aviljoenn/inno-pilot/test_after_opensettings.png

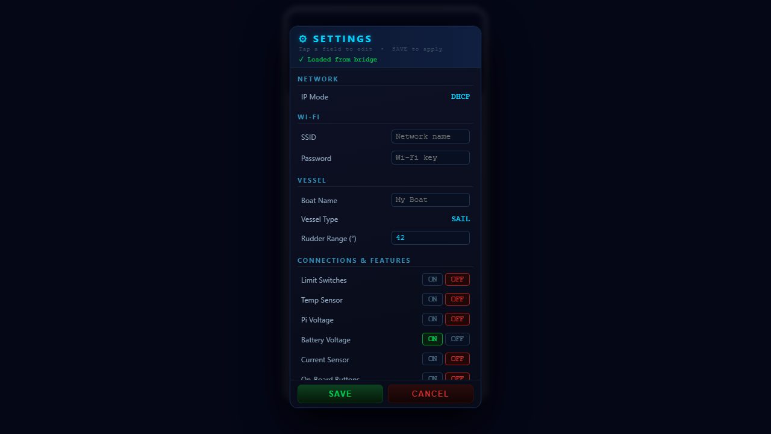
test_after_opensettings.png
