aviljoenn/inno-pilot/test_before_gear.png

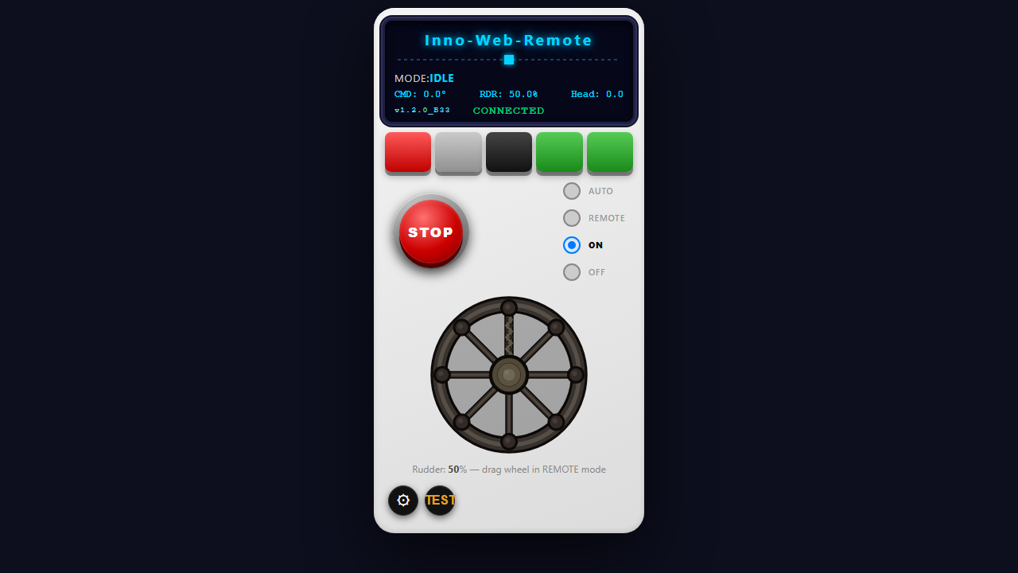
test_before_gear.png
