aviljoenn/inno-pilot/CHANGELOG.md

# Changelog

All notable changes to the Inno-Pilot system are documented here.
Format follows [Keep a Changelog](https://keepachangelog.com/).
Version applies to all three components (Bridge, Nano, Remote) simultaneously and the version of all components must always match regardless if a change was made in a component or not.
Versioning is `vHARDWARE.FEATURE.FIX` (MAJOR = hardware change, MINOR = software feature change,
PATCH = patch / bug fix), bumped on every merge of code to master. Components whose development is
paused (currently the ESP32 remote + its OTA binary) are deliberately left on their old version.
Full rule: CLAUDE.md "Version sync".

## [Unreleased]

## [v3.3.2] — 2026-10-21

Patch release. Bumped across all actively developed components (Nano, bridge, web remote).
The paused ESP32 remote firmware (v1.3.3_B3) and its OTA binary are deliberately not bumped.
Diagnosed on Inno-Pilot-Rosa from a REMOTE hand-steering session that stopped by itself, plus an
attended dock test with a packet capture (Samsung S20, Chrome).

### Fixed
- **REMOTE stopped (STEER LOSS) while the skipper was steering.** With a finger held on the helm
  wheel for several seconds, Chrome on a Samsung S20 paused the web page's timers (~1.5 s) and then
  reported the page hidden although it stayed on screen, so the page's heartbeat stopped and the
  bridge's 1.5 s dead-man ended REMOTE. Wi-Fi and the Pi were fine (pings answered within 70 ms,
  every request served in 2–20 ms). Touches on the wheel now send a heartbeat too (`ALIVE T`),
  also while the browser claims the page is hidden — a finger on the wheel is a skipper. The
  dead-man itself is unchanged: no heartbeat and no touches for 1.5 s still means STEER LOSS
  (screen locked, phone gone).
- **Motor chatter in REMOTE.** 144 of 189 REMOTE motor starts lasted only 1–2 ms: the Nano started
  and stopped on the same deadband edge, and each start's inrush pulled the motor supply down (once
  to 6.3 V). The Nano now starts only beyond 1.5 × the deadband (stops at the deadband), runs at
  least 60 ms once started, rests at least 150 ms after any stop, and never reverses a running pump
  directly. Limits, rudder ends and STOP still stop at once. The bridge's REMOTE stall check uses the
  same start threshold, so the deliberate hold between 1 and 1.5 deadbands is not counted as a stall.
- **Debug log motor direction was backwards** (`[PORT]` while the rudder moved to starboard). The
  bridge now labels RPWM = port, LPWM = starboard as the firmware drives them (honours `invert_motor`).

### Added
- **Diagnostics that survive.** The journal is kept across reboots (64 MB cap; Raspberry Pi OS keeps
  it in RAM by default). The bridge logs a late REMOTE heartbeat (> 1.0 s) as a warning, naming
  whether it came from the timer or a touch. The page reports hidden/visible, frozen/resumed, focus
  changes and late timers to the journal (`PAGE_EVENT`), so the next unexplained stop names its cause.

## [v3.3.1] — 2026-10-15

Patch release. Bumped across all actively developed components (Nano, bridge, web remote);
only the vendored pypilot fork changed. The paused ESP32 remote firmware (v1.3.3_B3) and its
OTA binary are deliberately not bumped.

### Fixed
- **Autopilot dead after any pypilot restart or hang (EBUSY on `/dev/ttyINNOPILOT`).**
  pypilot's servo set the exclusive flag (TIOCEXCL) on its port and cleared it only on a tidy
  close; when pypilot was stopped or restarted (by hand, or by systemd after pypilot exits —
  pypilot exits on any signal, including a hang being resumed) the flag stayed on the socat
  PTY and every reopen failed with EBUSY, so an engaged AP
  sent no commands until pypilot, the bridge and socat were restarted together. Found and
  confirmed on Inno-Pilot-Rosa (flag read back as set). Deliberate pypilot-fork strips:
  - `servo.py`: no TIOCEXCL on the servo port.
  - `nmea.py`: serial NMEA probing disabled — the flag only existed to keep that probe off
    the servo port, and Inno-Pilot has no serial NMEA devices (GPS/wind come over TCP/UDP).
    TCP/UDP NMEA inputs are unchanged.
- **False "rudder at centre" after a pypilot restart.** pypilot reports an invalid rudder
  reading as `False`; the bridge converted it with `float()`, giving 0.0°, so the web rudder bar
  and helm jumped to centre for ~0.5 s on every pypilot restart (a 29° "swing" on
  Inno-Pilot-Rosa with the rudder at port). Invalid pypilot values now mean "unknown": the
  page keeps the last angle, and a jog is refused or stopped while the angle is unknown (its
  soft limit cannot be checked). Applies to a dead rudder sensor as well.

## [v3.3.0] — 2026-10-15

Minor (feature) release. Bumped across all actively developed components (Nano, bridge,
web remote). The paused ESP32 remote firmware (v1.3.3_B3) and its OTA binary are
deliberately not bumped.

### Safety: no rudder motion before rudder limits are set
- **The bridge refuses every rudder motion until the rudder limits have been set by hand**:
  engaging AP (web remote, Nano B3 **and** pypilot's own port 8000 page — its COMMAND frames
  are dropped before the Nano and `ap.enabled=False` is sent back), REMOTE steering, jog and
  the rudder sweep. Alert `RUDDER LIMITS: NOT SET` in the web page alert panel
  (telemetry `WARN LIMITS_UNSET` when something was refused or stopped).
- **Limits are tied to the calibration they were set against.** Any later change to pypilot's
  rudder calibration (reset or capture on port 8000, a rudder range edit, the Nano EEPROM
  copy differing beyond its rounding) makes them invalid, and anything moving the rudder is
  stopped through its normal exit path. A pypilot outage keeps the last calibration, so
  REMOTE steering still works when pypilot dies.
- **Dock-Side Wizard, step 1 — rudder sensor & limits by hand** (Settings → Setup Wizards →
  Dock-Side → OPEN). Clutch out, the skipper turns the wheel/tiller: rudder angle at the stops
  → capture centre, port stop and starboard stop (each sampled for 1 s and rejected if the
  rudder moved > 0.5°; handed to pypilot's own 3-point calibration) → soft limits in degrees,
  at least 1° inside each stop (default 3°). The bridge checks the resulting calibration
  (stops inside the sensor span, span not tiny, curve monotonic) before accepting.
  New bridge commands `LIMITS RANGE|CAPTURE|SET`, status telemetry `LIMITS <json>`.
- Limits live in a bridge-owned file `/var/lib/inno-pilot/rudder_limits.json` (atomic
  write), deliberately outside `settings.json` so `SETTINGS SET` cannot mark them set.
- Jog and sweep now use these degree limits. The old **Port/Stbd Limit (%)** settings are
  greyed out as "REPLACED: DOCK-SIDE WIZARD" (still written to the Nano EEPROM block).
- **Existing installations must run the Dock-Side Wizard step once after updating** —
  there is no carry-over of the old percentage limits (agreed: Inno-Pilot-Rosa is
  re-commissioned).
- Not yet: the soft limits are not enforced while AP or REMOTE steer (TODO.md HIGH item);
  "limits set" is a precondition for motion, not yet a bound in every mode.

### Fixed after the Inno-Pilot-Rosa bench test (2026-10-15)
- **Web STOP silences the Nano's alarms** (new `WARNING_CODE` value 3), like the Nano's STOP
  button — units without helm buttons could not stop a STEER LOSS buzzer. Web STOP also
  ends a running jog.
- **Bridge now detects pypilot dying.** pypilot's client never raises on disconnect, so the
  immediate "pypilot connection lost" stop never fired on hardware (the Nano's 1.5 s
  watchdog caught it instead). The connection state now comes from the client.
- **Jog stops before the soft limit, not after**: it allows for its speed × 0.25 s (one
  pypilot angle step + coast; tuned on Inno-Pilot-Rosa, where the coast is only 0.6–0.9°). Measured overshoot before: up to 2.2° at detection, 0.8° short of the
  stop. The log reports where the rudder settled, for tuning.
- **No stale rudder angle to the Nano**: when pypilot hangs, the bridge stops relaying its
  frozen angle, and the Nano's cross-check only trusts a relayed angle under 0.6 s old —
  a hang no longer latches the Nano off its local angle.

### Safety (stop latch, dead-men, failsafe)
- **Nano STOP is now one press, always a full stop, and latched** (`motor_simple.ino`). It
  used to be two-press while an alarm sounded (first press only silenced and left the AP
  engaged), and a stop could be undone within ~200 ms by pypilot's next COMMAND frame. The
  Nano now ignores COMMAND frames and re-sends STOP until pypilot has visibly disengaged.
- **Nano AP command watchdog**: engaged but no pypilot COMMAND for 1.5 s (pypilot crashed or
  hung) → disengage, `!STEER LOSS` alarm, new button event 7 (AP_LOST) to the bridge.
- **REMOTE steering dead-man**: the web page sends `ALIVE` every 0.4 s; 1.5 s of silence (phone
  dropped, screen locked, Wi-Fi gone) stops REMOTE steering with STEER LOSS. Before, REMOTE
  steering continued indefinitely while the server stayed connected. Armed at entry
  (`MODE MANUAL ALIVE`), sent only by the phone that selected REMOTE. Opt-in per session, so
  the paused ESP32 remote is unaffected.
- **NUDGE dead-man**: `NUDGE HOLD` every 0.2 s while held; 0.8 s of silence stops the jog
  (was: up to 10 s). A held button can no longer restart a jog the bridge has stopped.
- **pypilot loss while engaged** (bridge): immediate DISENGAGE + alert when the pypilot
  connection drops, or when AP is shown but pypilot has sent no COMMAND for 3 s (also catches
  a re-engage while pypilot is hung); and no surprise re-engage — pypilot COMMAND frames are held back until pypilot disengages or the skipper
  re-engages.
- Skipper alerts `REMOTE STEER: STOPPED` / `AUTOPILOT: STOPPED` in the web page alert panel
  (telemetry `WARN <code>`); the mode selector follows the bridge when it leaves REMOTE.

## [v3.2.0] — 2026-10-15

Minor (feature) release. Bumped across all actively developed components (Nano, bridge,
web remote); the Nano and bridge have no code change. The paused ESP32 remote firmware
(v1.3.3_B3) and its OTA binary are deliberately not bumped. First release for
Inno-Pilot-Rosa (the unit formerly called Dyason).

### Changed
- Web remote Settings split into **SETUP WIZARDS** (Startup, Dock-Side, Sea Trial —
  placeholders, "COMING SOON") and **ADVANCED SETTINGS** (all existing settings,
  collapsed by default). Saving is unchanged.
- 14 settings that are stored but not acted on by the Pi or the Nano are greyed out,
  locked and labelled "(NOT USED)": network block, Wi-Fi SSID/key, vessel type, P-Gain,
  off-course alarm, auto-disengage, comms WARN/CRIT. See the dead settings register
  in TODO.md.

## [v3.1.0] — 2026-10-13

Minor (feature) release. Bumped across all actively developed components (Nano, bridge,
web remote). The paused ESP32 remote firmware (v1.3.3_B3) and its OTA binary are
deliberately not bumped.

### Added
- Attended rudder sweep with measurements (Hardware Test 1); Hardware tests 2-9 greyed out
  (PR #85, first shipped on Inno-Pilot-Rosa as v3.0.3 from the PR branch).

### Fixed
- Latent `NameError` in vendored pypilot `gps_filter.py` (missing `import datetime`, PR #80).

## [v3.0.3] — 2026-10-01

Patch release. Bumped across all actively developed components (Nano, bridge, web
remote). The paused
ESP32 remote firmware (v1.3.3_B3) and its OTA binary are deliberately not bumped.

### Fixed
- **REMOTE helm: "play" between the finger and the rudder** (found on Inno-Pilot-Rosa after the
  deadband tuning; four stacked causes, fixed together):
  - **A — final finger position dropped** (`inno_web_remote.py`): RUD was rate-limited
    to 5 Hz and anything inside the 200 ms window was discarded, with nothing sent on
    release, so the rudder went to where the finger was up to 200 ms before it
    stopped. Now a trailing send delivers the latest value as soon as the window
    allows, and the final value is sent on finger lift.
  - **B — Nano steered on a ~0.3 s-stale angle** (`motor_simple.ino`,
    `inno_pilot_bridge.py`; hardware impact — position control). The remote-manual
    loop used pypilot's angle, computed from the Nano's own ADC but sent out at 5 Hz,
    converted ~220 ms later and relayed back at 5 Hz (~2° late at 6°/s). The bridge
    now watches pypilot's rudder calibration (scale, offset, nonlinearity, range) and
    sends it to the Nano as a quadratic (new frames 0xC0–0xC6, status 0xC8); the Nano
    evaluates it on its fresh ADC every loop. pypilot stays the calibration truth.
    Safety: cross-check against pypilot's angle (> 5° for > 1 s → rejected, falls
    back to the old behaviour, latched until the calibration changes); end-stop
    backstop checks both angles; AP steering unchanged. Host unit test: Nano maths
    matches pypilot's formula within 0.05° over 300 random calibrations × 1024 ADC
    values. **Changes the right deadband:** with fresh feedback the Nano stops at the
    deadband edge (4% → ~2° short), and overshoot shrinks to the coast, so a smaller
    deadband (~1.5%) now settles without correction moves (simulator: 1.5% → end
    error −0.5°, overshoot 0; old firmware at 1.5% overshot 1.3° and corrected).
  - **C — offset starting target on entering REMOTE** (`motor_simple.ino`): the Nano
    seeded its target from the raw ADC scaled to 1..1022 but interprets targets on the
    calibrated axis, so the first wheel move jumped. It now re-seeds from the
    calibrated angle (unless the bridge sends a target first). Bridge side: the stall
    check's fixed 500 placeholder target is replaced by the actual rudder position, which
    removes the false "RUDDER: NOT MOVING" alert when REMOTE is entered off-centre.
  - **D — wheel gearing now a setting** (`inno_web_remote.py`): "Helm Wheel Turn (±°)"
    (Settings, shown with Remote Helm ON), default ±90° (was fixed ±150°) — 3° of wheel
    per rudder degree on a ±30° rudder instead of 5°. Changing it re-draws the wheel at
    the same rudder position. Also: ON/OFF settings now show/hide their dependent rows,
    and fields can carry a default for settings saved before they existed.
  - Nano flash 96% (29508 / 30720) after B — little headroom left.
- **Nano: REMOTE steering and the rudder sweep could not start the motor near the
  target** (`motor_simple.ino`; hardware impact — motor drive). Within 4 × deadband of
  the target (24° on Inno-Pilot-Rosa) remote-manual mode wrote `analogWrite(D9, 160)`, but the
  pin-state telemetry called `digitalRead(D9)` every loop, and on AVR `digitalRead()`
  turns PWM off on that pin — the duty never reached the motor. Found when Inno-Pilot-Rosa's
  second sweep stopped "stuck" without moving at all. Fix: all EN writes go through
  `motor_pwm()`, which records the duty, and the telemetry reports EN from that value
  (no `digitalRead(D9)`); and the slow zone now drives at full duty (255), matching the
  AP path — the hydraulic pump is on/off and the firmware's own note requires ≥ 180 for
  any PWM. Stopping is left to the existing reverse brake pulse + deadband, so overshoot
  near the target may rise slightly; the sweep measures it.
- **Hardware tests 2–9 could never run, and pressing RUN broke the bridge's text
  relay** (`inno_web_remote.py`, `inno_pilot_bridge.py`). They send `TEST <id>` to
  the Nano, but no sketch implements that protocol (`motor_simple` ignores it;
  `pwm_test.ino` picks its mode with compile-time `#define`s and never sends
  `TEST_DONE`). The bridge set `test_mode` and never cleared it, so every telemetry
  byte went through the text relay and any `0x0A` inside a frame reached the
  remotes as a junk `TEST_LINE` until restart. Tests 2–9 are now greyed out
  ("BENCH FIRMWARE / NOT AVAILABLE") and the bridge refuses `TEST` behind
  `NANO_TEST_PROTOCOL_SUPPORTED = False`. Also fixed: duplicate ID 2 (Speed Sweep
  is 3), and the test list staying visible behind the detail/config screens.
- **RAM test: the Nano's physical STOP did not stop it** (safety). STOP set the
  bridge mode to IDLE but left `ram_test_running` set; the sweep loop re-asserted
  MANUAL within 200 ms and carried on. The Nano's B3 could also engage AP mid-sweep.
- **RAM test kept sweeping with nobody watching**: a remote disconnect only
  handled MANUAL mode; stall detection flagged but did not stop it; `MODE`/`RUD`/
  `NUDGE` from any client left it running.

### Changed
- **RAM test → "Rudder Sweep (commissioning)", attended only, with measurements.**
  - **Dead-man hold:** after arming, the operator must HOLD B3 for the whole run.
    The browser sends `RAM HOLD` every 200 ms; the bridge stops after 1 s without
    one, so lifting the finger, dropping/locking the phone, switching apps,
    closing the page or losing WiFi all stop it. Release ends the test (no resume;
    re-arm from Settings). Arming never held disarms after 60 s.
  - **One exit path** (`ram_test_abort()`): hold lost/released, any Nano button,
    any remote STOP/BTN/MODE/RUD/NUDGE/TGT, stall, rudder angle unavailable,
    stroke timeout, remote disconnect, cycles complete. A stop never auto-centres
    (that would be unattended motion); MANUAL is released where the rudder stands.
  - **Measures** per direction: rudder speed (°/s, central 60% of the stroke),
    estimated hard-over time, reversal lag, overshoot, settled end error, settle
    timeouts, motor current (if `current_sensor` is on), port/stbd speed
    difference. Results show on the remote and go to the journal. PASS / CHECK /
    STOPPED. Reported only — nothing is written to settings.
  - Amplitude 5°–range (also clamped to `rudder_limit_*_pct`), 1–10 cycles
    (default 3). Bridge now watches `servo.current` from pypilot.
  - **Deadband-aware** (found on Inno-Pilot-Rosa's first boat run, which false-stopped with
    "rudder not moving" while the rudder moved fine): the Nano stops anywhere within
    its deadband (`deadband_pct` × full span — ±6° on Inno-Pilot-Rosa at 10%). The sweep now
    treats arriving inside that band as the end of the stroke, uses its own
    speed-independent jam check (< 0.5° progress in 2 s) instead of the generic 2°/s
    stall detector, times speed over the travel actually achieved, estimates lag from
    the local speed at the start of the move, and refuses sweeps too small to clear
    the deadband (with a plain explanation). Results show the deadband.
  - Verified against the real bridge `main()` with a simulated Nano/pypilot:
    complete run (speeds measured exactly), release (~120 ms), window blur
    (~120 ms), silent heartbeat loss (~1.1 s), Nano STOP, Nano B3, jam → stall,
    remote MODE, disconnect, 60 s arm timeout, too-small sweep refused; plus a
    Inno-Pilot-Rosa-like profile (±30°, 10% deadband, 80/20 limits) that reproduced both boat
    failures (false stop; motor never starting inside the old PWM-160 zone) and passes
    with the fixes. Nano: 91% flash / 70% RAM, `Serial` 221 bytes (128-byte RX buffer).

## [v3.0.2] — 2026-10-01

Patch release. Bumped across all actively developed components (Nano, bridge, web
remote) although only the web remote's code changed — a code change in any one
component makes a bump of all of them mandatory. The paused ESP32 remote firmware
(v1.3.3_B3) and its OTA binary are deliberately not bumped.

### Fixed
- **Web remote felt slow and jerky** (`inno_web_remote.py`; web remote only — bridge,
  pypilot and Nano untouched). Diagnosed from a Inno-Pilot-Rosa Debug capture 2026-09-30.
  - **SSE coalescing:** every bridge telemetry line used to push a full-state
    snapshot to every browser — ~48 events/s, ~85% identical, each a full page
    re-render, and enough to overflow a browser's 60-event queue (→ "dropped slow
    client") after a ~1.25 s stall. The bridge thread now parses each received
    burst, then publishes one snapshot, and only if it changed. Measured against a
    burst-faithful fake bridge: 51 → 3.4 events/s idle, 150 → 13 during a 2 s
    nudge, every rudder step still delivered, command round-trip unchanged.
    `TEST_LINE`/`TEST_DONE` bypass coalescing so no test line can be merged away.
  - **Rudder bar / wheel glide:** marker and arrows `0.12s ease` → `0.2s linear`
    (matches the ~200 ms telemetry interval so steps join up); the wheel gets the
    same glide when following telemetry, and none in REMOTE mode (it follows the
    finger). Headless-Chrome measurement during a nudge: marker stationary on 44%
    → 11% of frames, longest pause 99 → 33 ms. Cost: the drawn marker trails the
    reported position by ~1% of bar width more on average (the glide).

## [v3.0.1] — 2026-09-30

### Added
- **Two separate network-link monitors, one display** (`inno_web_remote.py`,
  `inno_health_notify.py`). Both are kept; they watch different paths and each
  alerts and logs on its own.
  - **Remote -> Pi** (new, `inno_web_remote.py`): the page probes `/health` once a
    second from the browser and tracks loss and round-trip over a rolling 60 s.
    Breach = loss > 2% (acceptable for AP control) with >= 10 samples; clears when
    the window is back at <= 2%. Each breach/clear is POSTed to the new
    `/linkevent` endpoint and written to the journal as `LINK_LOSS_BREACH` /
    `LINK_LOSS_CLEAR`; a report that fails during an outage is retried.
  - **Pi -> router** (`inno_health_notify.py`, unchanged in purpose): thresholds
    shortened from a 10 min window / 30 min clear to **60 s window / 60 s clear**.
    Still logs `PACKET_LOSS_WARN/CLEAR` and sends Telegram alerts. Also publishes
    its state on every ping result to `/dev/shm/inno-pilot-net.json` (tmpfs, no SD wear).
    - **Ping interval:** default 1 s (was 0.5 s), settable 1-30 s in Settings
      (`notifications.ping_interval_s`, clamped 1-30). Forced to 0.5 s while the
      remote is in Debug mode, for finer debug metrics (the web remote mirrors its
      Debug state to `/dev/shm/inno-pilot-debug`; the loop notices within ~1 s).
    - **Non-blocking rewrite:** the 60 s batch-`ping` calls are gone. One
      long-lived `ping -O` process is read with non-blocking reads in a single
      loop; each result is recorded, evaluated, logged and published the moment it
      arrives (`_record_ping`). The loop only ever waits in `select()` for <= 0.25 s,
      so shutdown, setting changes and Debug toggles are prompt. The default
      gateway is read from `/proc/net/route` (no subprocess) every 10 s; a gateway
      change resets the window (samples described a different path).
    - **Alert rule:** WARN when loss > 2% of the window AND >= 2 pings lost (one
      stray drop in a young window can't alert); nothing is judged before 20
      samples; the window stretches to 20 x interval at slow intervals (e.g. 10 min
      at 30 s) so it is always statistically meaningful.
  - **Display:** the full-width `#net-warn-banner` (outside the remote body) is
    removed. A miniature OLED-styled panel in the footer, right of the Debug
    button, replaces it. Normal mode: quiet `PI WIFI WEAK` / `REMOTE WIFI WEAK`
    lines only while a link is over threshold. Debug mode: live numbers for both
    (`PI>RTR loss% ms`, `REM>PI loss% avg/max ms`).
  - The web remote now reads the Pi-side state from that file instead of tailing
    `journalctl -f` for `PACKET_LOSS_*` strings; a file older than 60 s means the
    monitor isn't running and is shown as unknown (nothing displayed).
  - **Plain-language wording** for the skipper: the full-screen "NO BRIDGE" overlay
    (look and grey-out unchanged) now reads "AUTO PILOT: CONNECTION LOST /
    Trying to reconnect...", with the heading wrapped to stay inside the remote's
    width; the OLED status row says "AUTOPILOT LOST". Footer messages read
    "AUTOPILOT WIFI: WEAK" / "REMOTE WIFI: WEAK"; Telegram alerts read "WIFI ALERT:
    Autopilot WiFi is weak ..." / "WIFI OK: ...". Technical log markers
    (`PACKET_LOSS_*`, `LINK_LOSS_*`) are unchanged.
  - **One alerting area (principle):** all warnings, errors and system messages
    moved out of the skipper's command-and-control area into the bottom-right panel
    (`#alert-oled`, OLED-styled, 3 rows: red blinking = critical, amber = warning,
    cyan = info/debug). Quiet when all is well; if more than 3 are active the last
    row reads `+N MORE`. Priority: rudder not moving, autopilot lost, steer-motor
    fault, no compass heading, motor link poor, autopilot WiFi weak, remote WiFi weak.
    - Removed the OLED's bottom status row (version + connection text) — the OLED now
      shows steering information only. The software version moved to the panel in
      Debug mode (shown when no alert is active).
    - Replaced the centre-screen "Settings only available in OFF mode" toast (it sat
      outside the remote body) with a transient message in the panel; the same path
      shows "could not start autopilot" style errors, word-wrapped.
    - Reworded: RUDDER NOT RESPONDING -> "RUDDER: NOT MOVING", MOTOR FAULT ->
      "STEER MOTOR: FAULT", NO HEADING -> "COMPASS: NO HEADING", COMMS WARN ->
      "MOTOR LINK: POOR". Server error texts and the Settings / Software Update
      dialogs no longer say "bridge", "GitHub" or "git error".
  - No bridge, Nano or ESP32 change, so no version bump. Needs `inno_deploy.sh`
    (restarts health-notify and web-remote).

### Changed
- **Version scheme:** all components (Nano, bridge, web remote) move to **v3.0.1** and
  from now on carry release versions only (`vMAJOR.MINOR.PATCH`); the `_Bxx` beta build
  suffix is dropped. The Nano/bridge build counter `INNOPILOT_BUILD_NUM` is replaced by
  `INNOPILOT_VERSION_CODE` = major*10000 + minor*100 + patch (30001), sent in the existing
  `BRIDGE_VERSION_CODE` (0xF2) uint16 frame — no protocol change. The Nano's
  `!VER MISMATCH!` row and boot screen now show real versions (`Pi:3.0.1 Nano:3.0.1`,
  `Bridge: v3.0.1`) instead of `B11` / a hard-coded `v0.2.0_Bxx`.
  - ESP32 handheld remote source (`inno-remote/.../inno_remote.c`) and its OTA binary
    are NOT changed: remotes are offline pending development, and the source there is
    known not to match the firmware on the device.
- **Web remote layout** (`inno_web_remote.py`, page only):
  - The "Inno-Web-Remote" title moved out of the top OLED to the bottom edge of the
    remote body, in black, left-justified, with the software version right-justified
    beside it (served from `INNOPILOT_VERSION`). The name is the same font size as
    the OLED "Head"; the version stays small.
  - OLED mode line is centred, no longer prefixed with "MODE:", and uses the same
    font, size and colour as CMD/Head (previously grey small text with a big "AP",
    so "AP ON" showed a small white "ON").
  - OLED rudder position bar is twice as tall (track, centre tick, marker and
    command arrow heights all doubled; widths unchanged).
  - OLED "CMD: / Head:" line is now two lines: "Command" and "Heading" labels with
    the degrees centred beneath each.
  - Alert panel uses the same face, weight and colour as the OLED CMD/Head readout
    (bold Courier, cyan). Warnings are now cyan too (were amber); critical alerts
    stay red and blinking. Alerts use a smaller size so three rows still fit. When
    there is nothing to report it shows "All Services Nominal" at full CMD/Head
    size on two centred lines ("All Services" / "Nominal") instead of staying blank.
  - Helm wheel + nudge buttons moved up by the height of the old title row; wheel,
    Settings/Debug/alert footer and name/version row are evenly spaced (13 px).
    STOP, the mode radios and the nudge-button spacing are unchanged.
  - Web-remote-only change; shipped with the v3.0.1 version sync above.

### Fixed
- **Latent `NameError` in vendored pypilot GPS filter**
  (`compute_module/pypilot/pypilot/gps_filter.py`): the world-magnetic-model
  declination path called `datetime.date.today().year` but the module never
  imported `datetime` — and neither `from values import *` nor
  `from resolv import *` supplies the name (verified: `values.py` imports only
  `os, time, math, pyjson, resolv`; `resolv.py` imports nothing; neither
  defines `__all__`). Added the missing `import datetime`.
  - **Dormant on every current install, not a live fault.** The line runs only
    when the `wmm2020` package is installed *and* `gps.filtered.enabled` is
    true. On Inno-Pilot-Rosa `wmm2020` is absent (`ModuleNotFoundError`) and
    `gps.filtered.enabled=false` is persisted in `~/.pypilot/pypilot.conf`, so
    it was unreachable. Found 2026-09-26 while auditing whether GPS input could
    influence autopilot heading.
  - **What it would have done if reached:** `filter_process()` calls
    `f.update(*args)` with no `try`/`except`, so the `NameError` would have
    killed the GPS filter child process. The parent keeps calling
    `pipe.send(...)`; because the parent still holds its own copy of the read
    fd, no `EPIPE` is raised — the writes simply fill the 64 KB pipe buffer and
    then fail with `BlockingIOError`, which `NonBlockingPipe.send()` swallows
    into a **rate-limited (once per 10 s) and misleading** log line reading
    `ERROR: failed to encode data pipe!`. Net effect: filtered GPS output stops
    dead with no obvious indication of why.
  - This is a genuine upstream bug fix inside the vendored fork, **not** one of
    the deliberate strips described under "pypilot fork strategy" in CLAUDE.md.
  - Repo-wide check: `gps_filter.py:257` was the only `datetime.` use in the
    fork. The only other importer, `gpsd.py`, does `from datetime import
    datetime` and is correct (that import is currently unused, left untouched).
  - **Follow-up (not done here):** `filter_process()`'s `predict`/`update` calls
    remain unguarded, so any exception in the filter still kills the child
    process semi-silently. Adding a guard is a separate robustness concern and
    was kept out of this fix per CLAUDE.md's "keep changes small and focused".
- **I2C enable verification** (`install.sh`, `INSTALL.md`): `raspi-config nonint
  do_i2c 0` can exit 0 without actually writing the `dtparam=i2c_arm=on` line
  (seen in the field 2026-09-15, on a card whose boot partition had been
  re-imaged separately from its rootfs). `install.sh` now greps
  `/boot/firmware/config.txt` (falling back to `/boot/config.txt`) right after
  the call and aborts with a clear error if the write didn't land, instead of
  silently continuing with I2C never actually enabled. `INSTALL.md` documents
  the same manual check for anyone enabling I2C by hand.
- **pypilot web UI / install** (`install.sh`, `inno_deploy.sh`,
  `compute_module/pypilot/scripts/debian/etc/systemd/system/pypilot_web.service`):
  the pypilot web UI on port **8000** — which hosts the compass/heel
  **calibration** interface — was never installed. `install.sh` deliberately
  skipped `pypilot_web.service` ("not used by Inno-Pilot"), and `inno_deploy.sh`
  only *started* the unit if it already existed, so port 8000 was down on every Pi.
  - `install.sh` now installs and enables `pypilot_web.service` alongside
    `pypilot.service`.
  - `inno_deploy.sh` Step 4b now installs/enables the unit on redeploy, so Pis
    provisioned before this change pick it up without a full reinstall.
  - `inno_deploy.sh` Step 4b now does a **two-pass** `setup.py install`.
    dependencies.py drops a `pyproject.toml` that (on setuptools 78 / Python
    3.13) makes `build_py` skip the pure-Python pypilot source, so a single pass
    installs only the C extensions and never updates `web.py` et al. — meaning
    edits to pypilot Python source silently never reach the Pi on a redeploy.
    The second pass (pyproject.toml removed + `deps` marker touched, bypassing
    dependencies.py) actually installs the Python modules. This mirrors
    install.sh's workaround but runs every redeploy (install.sh only ran it when
    pypilot was entirely missing).
  - The unit runs as `User=innopilot` (upstream ships it with no `User=` line, so
    it would run as root with the wrong `~/.pypilot`) and uses an absolute
    `ExecStart` path.
- **pypilot competing with avahi-daemon for mDNS (UDP 5353)** (`compute_module/pypilot/pypilot/server.py`,
  `compute_module/pypilot/pypilot/signalk.py`, `compute_module/glue/inno_pilot_bridge.py`):
  `<hostname>.local` resolution on the LAN was intermittently failing — diagnosed
  on Inno-Pilot-Rosa (2026-09-17) after the web UI appeared unreachable via mDNS. Three
  independent pieces of code each ran their own IPv4 python-zeroconf mDNS
  responder/scanner, all competing with the system `avahi-daemon` for the same
  UDP 5353 socket (avahi itself logs `Detected another IPv4 mDNS stack running
  on this host... makes mDNS unreliable` when this happens):
  1. `server.py` self-announced `_pypilot._tcp.local.` for pypilot-client
     auto-discovery — unused by anything in this repo, disabled outright.
  2. `signalk.py`'s `ZeroConfProcess` scanned for `_http._tcp.local.` to
     auto-discover a SignalK server — SignalK integration itself is a real,
     wanted feature (see `TODO.md`), only the live LAN-scanning discovery was
     disabled; `ZeroConfProcess.process()` now idles instead.
  3. Our own `inno_pilot_bridge.py` called `pypilotClient()` with no host
     argument, which makes pypilot's client library probe via zeroconf on every
     (re)connect — fixed by pinning `pypilotClient('127.0.0.1')` (bridge and
     pypilot always run co-resident on the same Pi at a fixed port, so no
     discovery was ever needed).
  - Verified on Inno-Pilot-Rosa: `avahi-daemon` is now the sole UDP 5353 holder, a fresh
    avahi restart logs no conflict warning, and a direct unicast mDNS query
    (`dig @<pi-ip> -p 5353 <hostname>.local A`) resolves correctly.
  - See `CLAUDE.md`'s "pypilot fork strategy" section for the full diagnosis
    and the standing lesson for future pypilot integration code in this repo
    (always pass an explicit host to `pypilotClient()`).

### Added
- **`TODO.md`**: parked a high-priority design task — proper SignalK
  integration covering two scenarios (no central SignalK instance, Inno-Pilot
  must stand alone reliably; vs. a central SignalK Pi that every instance
  connects to via a static, known address rather than LAN discovery). Disabling
  SignalK's zeroconf discovery above was a narrow mDNS-conflict fix, not this
  design.
- **CLAUDE.md**: firm rule that deployment always goes through `inno_deploy.sh`
  — no component's own install/build tooling (`setup.py`, `arduino-cli upload`,
  etc.) should ever be hand-run against a live instance.

### Notes
- This change touches the **pypilot** subsystem, the bridge glue, and docs
  only; it does **not** modify any of the version-synced inno-remote
  components (Bridge protocol, Nano firmware, Remote), so no
  `INNOPILOT_VERSION` bump is required.

## [v1.3.3_B7] — 2026-06-26 — ADC mux-settle fix (spurious PiV HIGH) + 5V calibration

### Fixed
- **Nano firmware** (`motor_simple.ino`, `read_adc_avg()`): added ADC sample/hold
  settling (3 discarded reads after each channel switch). Without it the
  high-impedance dividers (A3 Pi/5V, A0 Vin) suffered ADC-mux **crosstalk**: A3 (5V
  rail) intermittently read ~14 V (≈ Vin's pin voltage), tripping a **spurious
  `PiV HIGH` alarm** (buzzer + OLED) once FEATURE_PI_VOLTAGE was enabled. Confirmed
  via the new 5V telemetry — ~15 % of samples read 14.2 V, the rest a correct ~5.18 V
  (14 V on a 5 V rail is impossible — it would destroy the Pi/Nano).
- **Nano firmware**: `PI_VSENSE_SCALE` calibrated 5.25 → **5.17** (multimeter 5.1 V
  vs reported 5.18 V). Per-board value.

### Changed
- **All version-synced components** (Nano, Bridge, Web remote): v1.3.3_B6 → v1.3.3_B7.

### Hardware impact
- Adds ~1.2 ms per `read_adc_avg()` call (3 settle reads); negligible at 5 Hz, no
  change to motor drive. Makes A3/A0/A1 readings trustworthy — prerequisite for a
  meaningful brown-out load test.

## [v1.3.3_B6] — 2026-06-26 — 5V-rail telemetry + Vin calibration (brown-out diagnosis)

### Added
- **Nano firmware + Bridge**: 5V logic-rail telemetry. The Nano samples the shared
  Pi/Nano 5V bus (A3) each telemetry cycle and sends it as `PI_VOLTAGE_CODE` (0xB4,
  volts×100); the bridge logs it at DEBUG (`Nano 5V rail: X.XX V`). Lets us watch the
  logic rail under motor load to diagnose a suspected brown-out/reset of the Nano
  during steering. Forwarded to pypilot like other inno-pilot codes (pypilot ignores
  codes it doesn't recognise, so no guard needed).

### Fixed
- **Nano firmware** (`motor_simple.ino`): `VOLTAGE_SCALE` corrected for Malu (.13)
  from 3.323 to **4.855** (bench-calibrated: multimeter 12.985 V vs reported 8.887 V).
  The old value under-read Vin by ~35% (a true 13 V showed as ~8.9 V — below the
  10.9 V under-voltage threshold; harmless only because battery-voltage faults are
  disabled on Malu). Per-board value; recalibrate per unit.

### Changed
- **All version-synced components** (Nano, Bridge, Web remote): v1.3.3_B5 → v1.3.3_B6.

### Hardware impact
- Adds one ADC read (A3) per telemetry cycle (~5 Hz); negligible loop-time impact, no
  change to motor drive. Corrected `VOLTAGE_SCALE` makes the reported Vin accurate —
  relevant if battery-voltage faults are later enabled.

## [v1.3.3_B5] — 2026-06-23 — Fix: remote-manual (REMOTE) rudder runaway — axis sign

### Fixed
- **Nano firmware** (`servo_motor_control/arduino/motor_simple/motor_simple.ino`):
  remote-manual ("REMOTE" helm) steering ran the rudder hard-over to the
  commanded-side end-stop instead of servoing to the commanded angle. The B49
  angle-based loop assumed `pilot_rudder_deg10` was `+port / -stbd`, but the bridge
  transmits the Nano `-rudder.angle` (`PILOT_RUDDER_CODE`) plus matching limits, so
  the axis is actually `+stbd / -port`. That single inverted assumption made the
  position loop **positive-feedback** (error grew as it drove) and pointed the
  end-limit guard at the wrong end, so nothing halted travel. Confirmed by
  instrumented bench test on Malu (192.168.6.13): a small port command drove the
  rudder to the port stop (~+91°, well past the ±42° calibrated limit).
  - Rebuilt the remote-manual block on the correct `+stbd / -port` axis — target
    mapping, position error, drive direction, and end-limit guard are now consistent,
    so the loop converges and holds at the commanded angle.
  - Added a **convention-independent absolute end backstop** (`over_stbd_end` /
    `over_port_end`): the motor is never driven past a calibrated end regardless of
    the directional logic — defence-in-depth against any future sign error.
  - Motor direction mapping unchanged (bench-confirmed correct: port cmd → port
    motion); only the position-loop sign and limit-end mapping were wrong.
- **Deploy/install** (`inno_deploy.sh`, `install.sh`): the two-pass `setup.py install`
  marker-file shuffle now uses `sudo` (`sudo rm -f pyproject.toml; sudo touch deps;
  sudo rm -f deps`). Pass 1 runs under sudo and creates those files as root, so the
  earlier plain `touch deps` failed with "Permission denied" and aborted the deploy
  mid-way (after services were already stopped).

### Changed
- **All version-synced components** (Nano, Bridge, Web remote): v1.3.3_B4 →
  v1.3.3_B5 (`INNOPILOT_VERSION` / `INNOPILOT_BUILD_NUM`). The ESP32 hardware-remote
  OTA binary is not rebuilt here — it is not used for the bench validation (the web
  remote on port 8888 drives the test).

### Hardware impact
- Changes which H-bridge direction is commanded for a given rudder error in
  remote-manual mode, and adds an absolute end-stop cutout. Requires a Nano reflash
  and bench re-test before sea use: verify port/stbd convergence and that travel
  halts at the calibrated limits.

## [v1.3.3_B3] — 2026-05-08 — Fix: deploy script aborts on root-owned nano_sketch.sha256

### Fixed
- **Deploy** (`inno_deploy.sh`): After a successful Nano flash the script
  records the firmware hash via `echo > "$NANO_HASH_FILE"` (no sudo).
  If a previous deploy was run with `sudo`, the hash file ends up
  `root:root`, and the next unprivileged deploy fails with
  `Permission denied` *after* the Nano has already been reflashed —
  leaving the post-flash steps (boot wait, bridge restart, version
  verification) unrun and the system in a half-deployed state.
  The script now detects an unwritable hash file and repairs ownership
  via `sudo chown` to the current user before writing.

### Changed
- **All** (Bridge, Web, Nano, Remote): version bump v1.3.3_B2 → v1.3.3_B3.

## [v1.3.3_B2] — 2026-05-08 — Fix: OTA URL `127.0.0.1` due to bridge/network startup race

### Fixed
- **Bridge** (`inno_pilot_bridge.py`): `_local_ip()` was called at module
  import time and its result frozen in `OTA_SERVER_HOST`. On a Pi Zero on
  Wi-Fi the bridge service starts ~80 s before `network-online.target`, so
  the UDP probe to `8.8.8.8` raised `ENETUNREACH`, the except branch fell
  back to `127.0.0.1`, and the bridge advertised an unreachable OTA URL
  (`http://127.0.0.1:8556/inno_remote.bin`) to every remote that connected
  with a version mismatch — even after the network came up.
  - Replaced with a lazy `ota_host()` helper that resolves the LAN IP at
    OTA-offer time and caches the first non-loopback result. `_local_ip()`
    now returns `None` (instead of `127.0.0.1`) when no route is available
    so the cache is not poisoned.
  - If the network is still unreachable when an OTA is offered, the bridge
    logs a WARNING and re-tries on the next remote HELLO.

### Changed
- **All** (Bridge, Web, Nano, Remote): version bump v1.3.3_B1 → v1.3.3_B2.

## [v1.2.0_B36] — 2026-04-14 — OLED SH1106 toggle + EEPROM settings storage

### Added
- **Web** (`inno_web_remote.py`): "OLED SH1106 Mode" toggle in CONNECTIONS & FEATURES
  settings section with hover tooltip explaining the pixel-shift symptom.
- **Bridge** (`inno_pilot_bridge.py`): All settings now serialized to Nano EEPROM on
  save and on bridge startup. Nano rebooted via DTR pulse after EEPROM write so
  settings take effect immediately.
- **Nano** (`motor_simple.ino`): EEPROM read on boot — loads feature flags (including
  OLED type) before display init. OLED init selects SH1106_128x64 or Adafruit128x64
  profile based on the stored flag.
- **Nano** (`motor_simple.ino`): EEPROM_WRITE_CODE (0x53) handler for receiving
  settings bytes from bridge.

### Changed
- **All** (Nano, Bridge, Web): Version bump v1.2.0_B34 → v1.2.0_B36.
  B35 fixes (OTA IP auto-detect, Nano cold-boot DTR pulse, Flask Markup) are
  included but were committed previously without a version string bump.

## [v1.2.0_B35] — 2026-04-13 — Fix: Pi5/Bookworm reinstall issues (OTA IP, Nano cold-boot UART, Flask Markup)

### Fixed
- **Bridge** (`inno_pilot_bridge.py`): Removed hardcoded `OTA_SERVER_HOST = "192.168.6.13"`.
  Replaced with a `_local_ip()` function that probes the routing table via a UDP
  connect (no data sent) to determine the Pi's own LAN IP at startup. This means the
  bridge works correctly on any Pi regardless of its fixed IP address, and OTA update
  push works without manual edits after install.
- **Bridge** (`inno_pilot_bridge.py`): Added explicit DTR pulse on bridge startup to
  ensure the Nano's UART initialises correctly on cold boot. On cold boot the CH340
  USB-UART DTR line starts LOW; `open_serial_no_reset()` clears HUPCL but causes no
  DTR transition, so the Nano's serial TX never drove the line. The bridge sent frames
  continuously but received nothing until a DTR reset occurred. The fix pulses DTR
  HIGH→LOW (150 ms) immediately after opening the port; HUPCL is already cleared so
  this is the only reset the Nano will see during normal bridge operation. The
  subsequent `time.sleep(2.0)` gives the Nano comfortable margin to finish `setup()`
  before the bridge starts sending RCT settings.
- **Web** (`compute_module/pypilot/web/web.py`): Fixed `ImportError` crash-loop on
  Flask >= 2.3. `flask.Markup` was removed in Flask 2.3 and moved to `markupsafe`.
  The import is now guarded with a try/except so pypilot_web starts correctly on
  Bookworm (Flask 3.x) and still works on older installs.

## [v1.2.0_B34] — 2026-04-13 — Fix: settings SAVE permanently stuck on "Saving…" (missing Content-Length)

### Fixed
- **Web Remote**: Settings POST response now includes a `Content-Length` header.
  The handler class uses `protocol_version = "HTTP/1.1"` so the browser keeps the
  connection alive and requires either `Content-Length` or `Transfer-Encoding:
  chunked` to know when the response body ends.  Without it `r.json()` in the
  browser hung forever — the 200 status and headers were received immediately but
  the body never "arrived".  The GET (`_serve_settings`) and command POST
  (`_handle_command` via `_send_json`) already sent Content-Length correctly; only
  the settings POST was missing it.  Root cause found via Playwright debug tracing
  (browser showed HTTP 200 received; server logs showed response fully sent; body
  never delivered to JS).

## [v1.2.0_B33] — 2026-04-13 — Fix: "Saving…" status stuck indefinitely on slow bridge response

### Fixed
- **Web Remote**: Settings SAVE POST now has a 9-second `AbortController` timeout.
  Previously there was no client-side fetch timeout — if the Python HTTP handler
  blocked longer than expected (bridge reconnect 2 s + SETTINGS_TIMEOUT_S 4 s = 6 s
  worst case, or indefinitely on an unhandled server error), the "Saving…" status
  would remain on-screen forever. The AbortController guarantees `.catch()` fires
  within 9 s with a "✗ Save timed out" message so the panel always closes.

## [v1.2.0_B32] — 2026-04-13 — Fix: Settings panel always shows "bridge unavailable" in OFF mode

### Fixed
- **Web Remote**: Settings GET and SET now work regardless of autopilot mode.
  Previously, the bridge client thread dropped its TCP connection when mode was
  OFF, so `_snap()["connected"]` returned False and both `_serve_settings` and
  `_handle_settings_post` silently fell back to the local file — showing the
  "⚠ Using local settings — bridge unavailable" warning even when the bridge
  was fully operational.  Fixed by temporarily setting `_bridge_active` before
  each settings operation, waiting up to 2 s for the bridge thread to
  (re)connect, then restoring the OFF state in a `finally` block.

## [v1.2.0_B31] — 2026-04-13 — Feat: Settings panel status/feedback line

### Added
- **Web Remote**: Status/feedback line inside the settings panel header (`#sov-status`).
  Shows load and save outcomes so the user always knows whether settings came from the
  bridge or the local fallback file, and whether a save succeeded.
  - **Opening settings**: "Loading…" (blue-grey) while the `GET /settings` request is in
    flight; then "✓ Loaded from bridge" (green) or "⚠ Using local settings — bridge
    unavailable" (amber) depending on which path the server used.
  - **Saving settings**: "Saving…" (blue-grey) while the `POST /settings` request is in
    flight; panel stays open until the response arrives, then shows "✓ Saved via bridge"
    (green), "⚠ Saved locally — bridge unavailable" (amber), or "✗ Save failed" (red).
    Panel auto-closes 1.8 s after a successful save (2 s after a network error).
  - **Load failure**: "✗ Failed to load settings" (red) on network error.
- **Web Remote**: `setSovStatus(msg, type)` JS helper manages the status line.
- **Web Remote**: `_doClosePanel()` JS helper extracted from `closeSettings` to support
  the deferred-close save flow.

### Changed
- **Web Remote** (`_serve_settings`): Response JSON now includes a `_source` key
  (`"bridge"` or `"local"`) so JS can show the correct status. JS strips this key before
  storing settings in `gSettings` so it is never re-POSTed to the bridge.
- **Web Remote** (`_handle_settings_post`): Response JSON changed from `{"ok":true}` to
  `{"ok":true,"via":"bridge"|"local"}` so JS can distinguish the two save paths.
- **Nano**: Version constant bumped to B31 (no logic changes).

## [v1.2.0_B29] — 2026-04-05 — Feat: 4-mode animated radio button selector (OFF / ON / REMOTE / AUTO)

### Changed
- **Web Remote**: Replaced 3-position vertical lever toggle (OFF / AUTO / MANUAL) with a
  4-position animated radio button group (AUTO / REMOTE / ON / OFF, top-to-bottom).
  Each option has an animated round radio dot with a label beside it.
- **Web Remote**: Mode semantics redefined:
  - **OFF** — OLED content area blanked, TCP connection to bridge dropped (port freed for ESP32 handheld)
  - **ON** — observer mode; connects to bridge, shows all telemetry, helm wheel follows rudder position sensor (dark/inactive appearance), no control
  - **REMOTE** — skipper steers; helm wheel lights up, wheel reflects commanded rudder position, boat driven by web remote (was "MANUAL")
  - **AUTO** — Pypilot heading hold; helm wheel dark but follows actual rudder movements, all metrics displayed
- **Web Remote**: `MODE ON` command handled server-side (wakes bridge thread without forwarding a control command)
- **Web Remote**: Wheel label updated to "drag wheel in REMOTE mode"

## [v1.2.0_B28] — 2026-04-05 — Fix: On-Board Buttons setting not rendering or responding in web UI

### Fixed
- **Web Remote**: `on_board_buttons` was missing from the `SF` field descriptor array —
  the UI rendered the row but had no JS registration for it, so the ON/OFF buttons showed
  no active state on open and click events were silently ignored. Added
  `{id:'on_board_buttons', sec:'features', type:'bool'}` to `SF` alongside the other
  feature flags.

## [v1.2.0_B27] — 2026-04-05 — Fix: motor activates in HAND mode on units without buttons

### Fixed
- **Nano**: Motor falsely activated in HAND mode when helm moved by hand on units with no
  physical buttons wired (e.g. .12 / Pi5 boat). Root cause: floating A6 pin combined with
  ADC S/H crosstalk from the preceding A2 rudder read caused `decode_button_from_adc()` to
  return BTN_B1, setting `manual_override=true` and driving the motor STBD (confirmed via
  MOTOR_REASON_CODE = `manual_phys(btn)` with `manual_ov=1`).

### Added
- **Nano**: `FEATURE_ON_BOARD_BUTTONS` (0x20) — when this feature flag is OFF, the Nano
  skips `analogRead(A6)` entirely and forces `raw_b = BTN_NONE`, eliminating the floating
  pin false-positive. Default OFF so units without buttons are safe out of the box.
- **Bridge**: `FEATURE_ON_BOARD_BUTTONS` constant and `on_board_buttons` settings key;
  included in `send_features_to_nano()` and logged at startup.
- **Web Remote**: "On-Board Buttons" ON/OFF toggle in SETTINGS → CONNECTIONS & FEATURES.
  Set ON for the .13 unit (has buttons), leave OFF for the .12 unit (no buttons).

## [v1.2.0_B20] — 2026-04-02 — Version sync across all components

### Changed
- **All**: Synchronised version to `v1.2.0_B20` across Bridge, Nano (motor_simple.ino), and ESP32 Remote — Bridge was at B15, Nano and Remote were at B7

## [v1.2.0_B1] — 2026-03-27 — OTA Update Pipeline + Version Reset

### Added
- **Remote**: OTA firmware update via TCP — on TCP connect, HELLO version mismatch triggers automatic OTA download from bridge HTTP server (`http://192.168.6.13:8556/inno_remote.bin`), flashes inactive OTA partition, and reboots; OLED shows "OTA UPDATE / Updating..." during transfer, "OTA FAILED / Check bridge" on error
- **Remote**: Task watchdog unregisters during OTA download to prevent false 10 s timeout during transfer
- **Bridge**: OTA HTTP file server on port 8556 — serves `inno_remote.bin` from `/var/lib/inno-pilot/ota/` in a daemon thread; returns 404 if binary not yet deployed (safe at startup)
- **Bridge**: HELLO handler now sends `OTA <url>` after `HELLO <ver>` reply when remote version mismatches and binary is present
- **Deploy**: `deploy_inno_pilot_glue.sh` now copies `ota/inno_remote.bin` from repo to `/var/lib/inno-pilot/ota/` on Pi
- **Repo**: `inno-remote/firmware/inno_remote/ota/` directory tracked in git; `.gitignore` exception allows committing the OTA-ready `.bin`

### Changed
- Version scheme reset from `v0.2.0_B21` (Bridge/Nano) / `v0.2.0_B19` (Remote) to `v1.2.0_B1` across all three components — build counter restarts at 1

## [v0.2.0_B21] — 2026-03-27 — OLED Fault Area Moved to Rows 1-2, Helm Always at Row 3

### Changed
- **Nano**: All fault/warning messages moved from rows 2-3 to rows 1-2 — 2X messages span rows 1+2, 1X messages use row 1
- **Nano**: Helm field (row 3) is now always drawn unconditionally — `row3_taken` guard removed entirely
- **Bridge**: Build bumped to B21 to match Nano

## [v0.2.0_B20] — 2026-03-27 — OLED Layout Compaction: Remove Diagnostics Row, Move Helm/Cmd/Rudder Up

### Changed
- **Nano**: Removed Rx diagnostics row (was row 3: `Rx:N Er:N A:N.N`) — no longer shown in normal or offline state
- **Nano**: Helm mode moved from row 4 to row 3 (guarded: hidden during 2X fault messages that span rows 2-3)
- **Nano**: Cmd/HDG row moved from row 5 to row 4
- **Nano**: Graphical rudder bar moved from row 6 to row 5; track now filled with `-` instead of spaces (`P---I---S`)
- **Nano**: Row 6 always cleared (was rudder bar); row 7 V/A/T unchanged
- **Nano**: Offline path now simply clears rows 3-6 (no diagnostics text in middle rows)
- **Bridge**: Build bumped to B20 to match Nano

## [v0.2.0_B19] — 2026-03-27 — Remote Safety: TCP Indicator, Comms Display, Watchdog, Buzzer, Version Handshake

### Added
- **Remote**: No-bridge connecting screen — when TCP is not established in normal mode, OLED shows "NO BRIDGE / Connecting..." instead of simulated instrument values; simulation is now strictly a demo-mode feature (hold ESTOP at boot)
- **Remote**: COMMS fault display — parses `COMMS WARN` / `COMMS CRIT` from bridge; mode line becomes `MODE: AUTO [W]` on WARN and `!COMMS FAULT!` on CRIT
- **Remote**: Buzzer drive — GPIO 8 (NPN transistor) now driven for three events:
  - ESTOP press: double-beep (100 ms on / 60 ms off / 100 ms on), highest priority
  - TCP bridge lost mid-session: triple short pulse alarm
  - COMMS CRIT active: continuous 500 ms on/off slow beep (matches Nano pattern)
- **Remote**: Task watchdog — `esp_task_wdt_add(NULL)` registered in `app_main`; fed by `esp_task_wdt_reset()` every 20 ms loop; 10 s timeout + panic in `sdkconfig.defaults`
- **Remote**: VERSION handshake — sends `HELLO v0.2.0_B19` on every new TCP connection; logs mismatch warning if bridge replies with a different version
- **Remote**: `tcp_client_set_connect_callback()` API — fires once per new TCP connection, used for HELLO send
- **Bridge**: HELLO command handler — parses remote version, logs match/mismatch at INFO/WARNING, replies `HELLO <bridge_version>`

### Changed
- All components bumped to B19 (Nano: version constant only, no logic changes)

## [v0.2.0_B18] — 2026-03-27 — OLED Simplification & Graphical Rudder Bar

### Changed
- **Nano**: OLED Row 1 removed — Pi online/offline status replaced by version-mismatch-by-exception warning in rows 2-3 (flashing `!VER MISMATCH!` + build numbers when bridge ≠ Nano build)
- **Nano**: Boot splash is now non-blocking — `loop()` runs during the 3 s splash (serial RX uninterrupted); old `delay(3000)` removed
- **Nano**: Row 4 replaces AP/Clutch dual-field with single `Helm:` field: `HAND` (manual jog), `AUTO` (AP engaged), `REMOTE` (TCP remote manual)
- **Nano**: Row 5 heading values always 3-digit zero-padded (e.g. `005`); `HDG:` right-justified on the display
- **Nano**: Row 6 replaced with graphical rudder bar — `P` on left, `S` on right, `I` indicator proportionally placed within [port_lim, stbd_lim]; `I` blinks over `P` or `S` when rudder exceeds a limit, with `?Rud>Limit` warning in rows 2-3
- **Nano**: Rows 2-3 warning priority updated: steer_loss > hw_fault > ver_mismatch > comms_crit > comms_warn > rud_overshoot > ap_pressed
- **Nano**: Removed unused `rudder_deg` local in `oled_draw()` (was never read)
- **Bridge**: Build bumped to B18 to match Nano

## [v0.2.0_B17] — 2026-03-27 — Fix CRC Errors: RX Buffer + OLED Throttle

### Fixed
- **Nano**: Root cause of sustained ~20 CRC errors/10s identified — OLED I2C draw blocking `loop()` long enough to overflow the 64-byte Arduino serial RX buffer during bridge telemetry bursts
- **Nano**: Increased serial RX buffer from 64 to 128 bytes via `--build-property "build.extra_flags=-DSERIAL_RX_BUFFER_SIZE=128"` (required on every compile)
- **Nano**: Reduced OLED refresh from 200ms (5 Hz) to 1000ms (1 Hz) — eliminates buffer pressure overlap with 5 Hz telemetry bursts
- **Nano**: Partial OLED update — rows 0-1 (version/Pi status) skip I2C writes when content unchanged, saving ~25% of draw time

## [v0.2.0_B16] — 2026-03-27 — Comms Error Diagnostic Logging

### Added
- **Nano**: `COMMS_ERR_DETAIL_CODE` (0xED) — sends corrupt frame CODE byte + received CRC to bridge on CRC error, rate-limited to 5/s (200 ms throttle, latest-wins 1-slot)
- **Bridge**: Volatile diagnostic log at `/tmp/inno_pilot_comms_diag.log` — 256 KB rotating, ms-precision timestamps, does not survive reboot
- **Bridge**: `COMMS_ERR_DETAIL_CODE` parser — extracts corrupt code + CRC, logs with err_window/crit_s context
- **Bridge**: Bridge-side CRC errors (Nano→Bridge direction) also logged to the same diagnostic file

## [v0.2.0_B15] — 2026-03-26 — Comms-Fault Detection & Safety System

### Added
- **Nano**: Sliding-window CRC error rate monitor — 10 × 1-second buckets, cached sum, evaluated every loop
- **Nano**: Two-level fault thresholds: WARN (≥5 errors/10 s) and CRITICAL (≥15/10 s held 3 consecutive seconds)
- **Nano**: Autonomous AP disengage (one-shot latch) on CRITICAL — motor neutral, clutch off, 0ms latency
- **Nano**: 1 Hz comms buzzer alarm (500ms on/off) — distinct from 100ms hw-alarm rapid beeps
- **Nano**: OLED comms-fault slots: `!COMMS ERR!` (flashing 2×) at CRITICAL, `?Comms:N err/10s` (static 1×) at WARN
- **Nano**: PTM two-press extended to silence comms buzzer (first press silence, second press STOP)
- **Nano**: `COMMS_DIAG_CODE` (0xEC) telemetry at 1 Hz — lo byte = err_window_sum, hi byte = crit_consec_s
- **Nano**: New flag bits `COMMS_WARN_FAULT=0x1000`, `COMMS_CRIT_FAULT=0x2000` in FLAGS word
- **Bridge**: Parse `COMMS_WARN_FAULT`/`COMMS_CRIT_FAULT` from FLAGS — auto-disengage AP via pypilot set_q on CRITICAL
- **Bridge**: `COMMS_DIAG_CODE` handler — logs elevated error rates at INFO, clean at DEBUG
- **Bridge**: CRC validation on Nano→bridge frames in `extract_wrapped_frames()` — corrupt frames dropped, not forwarded to pypilot
- **Bridge**: `COMMS OK` / `COMMS WARN N` / `COMMS CRIT` TCP telemetry to remote at 5 Hz
- **Bridge**: Relay diagnostics — drop-rate percentage logged every 30 s, warns at >5%

### Changed
- OLED fault priority: steer_loss > hw_fault > **comms_crit** > **comms_warn** > ap_pressed_warn > overlay
- Buzzer priority: steer_loss > hw_alarm > **comms_fault** (500ms/1Hz) > ap_pressed_warn

## [v0.2.0_B14] — 2026-03-26 — AP State Cleanup + Probe Refactor

### Changed
- **Bridge**: Removed `AP_ENABLED_CODE` (0xE1) send — AP engage/disengage is now derived from pypilot's native `COMMAND_CODE`/`DISENGAGE_CODE` relay frames (single source of truth)
- **Bridge**: Removed `ap.enabled` subscription from pypilot worker thread (redundant after above)
- **Bridge**: Relay loop now inspects forwarded pypilot frames to keep `bstate.mode` accurate when pypilot changes AP state externally
- **Bridge**: `probe_nano_port()` now uses `send_nano_frame()` — removes hand-rolled wrap/build duplication
- **Nano**: Removed `AP_ENABLED_CODE` handler; `ap_enabled_remote` set true on first `COMMAND_CODE`, cleared on `DISENGAGE_CODE`

## [v0.2.0_B11] — 2026-03-26 — Serial Reliability + HUPCL Fix

### Added
- **Bridge**: B8 — CRC-validated pypilot relay: wraps outbound pypilot frames in bridge framing + CRC before forwarding to Nano; prevents Nano CRC-error flood from raw pypilot data
- **Bridge**: B9 — Structured DEBUG logging for relay diagnostics (SIGUSR1 toggle)
- **Nano**: B10 — RX debug counters on OLED (CRC errors, raw bytes, valid frames)

### Fixed
- **Bridge**: B11 — HUPCL disabled on serial open via `termios.tcsetattr(~termios.HUPCL)` — prevents Nano reset (DTR-drop) when the port is closed. Documented in `CLAUDE.md` and top-level `CLAUDE.md`.

## [v0.2.0_B7] — 2026-03-25 — Remote Integration (Tasks #2–#10)

### Added
- **Bridge**: Mode state machine (`IDLE / AP / MANUAL`), `handle_remote_disconnect()` with steer-loss safety
- **Bridge**: TCP server on port 8555 handles `MODE MANUAL/AUTO`, `RUD xx.x`, `BTN TOGGLE/±1/±10`, `ESTOP`
- **Bridge**: Parses `FLAGS_CODE` and `BUZZER_STATE_CODE` from Nano, relays to Remote as TCP text
- **Bridge**: Sends `RDR_PCT`, `MODE`, `WARN AP_PRESSED` telemetry to Remote
- **Nano**: `MANUAL_MODE_CODE` (0xE9), `MANUAL_RUD_TARGET_CODE` (0xE8), `WARNING_CODE` (0xEA), `BUZZER_STATE_CODE` (0xEB)
- **Nano**: Two-press STOP logic — first press silences active alarm, second press is full emergency stop
- **Nano**: Remote manual steering via bang-bang motor drive to ADC target with deadband
- **Nano**: Steer-loss OLED display (flashing `!STEER LOSS`), `?AP Pressed?` warning (5s)
- **Nano**: Buzzer priority chain: steer-loss > hw-fault > ap-warn, with state reporting to bridge
- **Nano**: OLED row 4 shows `MAN: ON` when in remote MANUAL mode
- **Remote**: `on_bridge_rx()` TCP callback — parses `AP`, `HDG`, `CMD`, `RDR`, `RDR_PCT`, `FLAGS`, `MODE`, `WARN AP_PRESSED`
- **Remote**: Mode switch sends `MODE MANUAL` / `MODE AUTO` on physical transition
- **Remote**: Buttons send `BTN TOGGLE`, `BTN ±1/±10` in AUTO mode
- **Remote**: STOP button sends `ESTOP` to bridge on every press
- **Remote**: Pot sends `RUD xx.x` (0–100%) in MANUAL mode, throttled to 1% change or 200ms
- **Remote**: Bridge telemetry overrides local simulation when connected
- **Remote**: `?AP Rejected?` warning overlay on OLED (5s auto-expire)

### Changed
- `MANUAL_MODE_CODE` reassigned from 0xE7 to 0xE9 (0xE7 conflicts with pypilot `RESET_CODE`)
- Bridge `process_remote_line()` refactored to modify `BridgeState` directly
- Bridge pypilot worker thread with `time.sleep(0.01)` to prevent CPU starvation on Pi Zero (fix from B6)

### Fixed
- Pi: Offline issue (pypilot thread consuming 92% CPU on single-core Pi Zero, starving main loop)

## [v0.1.0] — 2026-03-20 — Baseline

First tagged baseline. Captures the working state before inno-remote integration.

### Components
- **Bridge** (`compute_module/glue/inno_pilot_bridge.py`) — pypilot ↔ Nano relay via PTY/socat
- **Nano** (`servo_motor_control/arduino/motor_simple/motor_simple.ino`) — motor controller with clutch, OLED, buzzer
- **Remote** (`inno-remote/firmware/inno_remote/`) — ESP32-C3 handheld, demo/simulator mode only

### What works
- pypilot autopilot with heading hold via bridge relay
- Serial CRC-8 framed protocol (6-byte frames, 38400 baud) between bridge and Nano
- Motor H-bridge drive with current sensing and stall protection
- Clutch engage/disengage with buzzer feedback
- Rudder position sensing via potentiometer (ADC)
- Port and starboard limit detection
- OLED status display on Nano (heading, rudder, AP state)
- Remote: Wi-Fi STA with auto-reconnect, OLED UI, button ladder, demo/simulation mode
- Deployment via `deploy_inno_pilot_glue.sh` on Pi

### Known limitations
- Remote is not integrated (demo mode only, no TCP connection)
- No OTA update capability for remote
- No version checking between components
- Single installation config (no per-boat provisioning)
