aviljoenn/inno-pilot/compute_module/glue/inno_pilot_bridge.py

#!/usr/bin/env python3
"""
inno_pilot_bridge.py — relay between pypilot and the Nano servo controller,
with a TCP listener on port 8555 for the inno-remote wireless handheld.

Architecture:
  pypilot (port 23322) <-> bridge <-> PTY pair <-> Nano USB serial
  inno-remote / web remotes (Wi-Fi)  <-> bridge (TCP port 8555, multi-client)

Threading model:
  - pypilot_worker (daemon thread): owns all pypilotClient interaction.
    Calls client.receive() (which may block on pselect) without stalling
    the main loop.  Outbound set() calls are posted via set_queue.
  - Main thread: Nano serial, TCP remote, HELLO keepalive.
    Reads pypilot state from PypilotState under state_lock.

Mode state machine (BridgeState.mode):
  IDLE   — AP disengaged, no remote manual control
  AP     — autopilot engaged via pypilot
  MANUAL — remote/manual steering mode active
  Transitions:
    BTN_TOGGLE / ESTOP       -> IDLE<->AP
    MODE MANUAL (TCP)        -> any -> MANUAL  (disengages AP)
    MODE AUTO   (TCP)        -> MANUAL -> IDLE
    TCP disconnect in MANUAL -> MANUAL -> IDLE + WARN_STEER_LOSS to Nano
"""
import copy
import json
import logging
import logging.handlers
import os
import queue
import select
import signal
import socket
import struct
import threading
import time
import serial
import termios
from dataclasses import dataclass, field
from typing import Optional
from pypilot.client import pypilotClient

# ---------------------------------------------------------------------------
# Logging — default INFO; toggle to DEBUG at runtime with:
#   kill -USR1 $(pgrep -f inno_pilot_bridge)
# ---------------------------------------------------------------------------
logging.basicConfig(
    level=logging.INFO,
    format="%(asctime)s.%(msecs)03d %(levelname)-5s %(message)s",
    datefmt="%H:%M:%S",
)
log = logging.getLogger("bridge")
log_pp = logging.getLogger("pypilot")      # pypilot-worker messages


def _toggle_log_level(signum, frame):       # noqa: ARG001
    """SIGUSR1 handler: flip between INFO and DEBUG for all bridge loggers."""
    root = logging.getLogger()
    if root.level <= logging.DEBUG:
        root.setLevel(logging.INFO)
        log.info("Log level toggled -> INFO")
    else:
        root.setLevel(logging.DEBUG)
        log.info("Log level toggled -> DEBUG")


# SIGUSR1 is only available on Unix (Pi), harmless to skip on Windows dev
if hasattr(signal, "SIGUSR1"):
    signal.signal(signal.SIGUSR1, _toggle_log_level)

def _local_ip() -> str | None:
    """Return the Pi's LAN IP by probing the routing table (no data sent).

    Returns None if the kernel has no usable route yet (e.g. wlan0 not
    associated, default route not installed). Callers should retry/cache
    via ota_host() rather than calling this directly.
    """
    try:
        s = socket.socket(socket.AF_INET, socket.SOCK_DGRAM)
        try:
            s.connect(("8.8.8.8", 80))
            ip = s.getsockname()[0]
        finally:
            s.close()
    except OSError:
        return None
    if not ip or ip.startswith("127."):
        return None
    return ip


# OTA server host is computed lazily on first use (see ota_host() below).
# Computing at import-time races with NetworkManager-wait-online during boot —
# the bridge service starts ~80 s before network-online.target on a Pi Zero
# Wi-Fi setup, so the route to 8.8.8.8 is not yet available, _local_ip()
# raises ENETUNREACH, and the OTA URL ends up advertised as 127.0.0.1
# (unreachable from the ESP32 remote).
_ota_host_cache: str | None = None


def ota_host() -> str:
    """Return the LAN IP to advertise in OTA URLs to the remote.

    Cached once a non-loopback IP is found. Falls back to '127.0.0.1' only
    while the network is still unreachable — subsequent calls will retry,
    so the next remote HELLO will get a corrected URL.
    """
    global _ota_host_cache
    if _ota_host_cache:
        return _ota_host_cache
    ip = _local_ip()
    if ip:
        _ota_host_cache = ip
        return ip
    return "127.0.0.1"

# ---------------------------------------------------------------------------
# Inno-Pilot version (must match Nano firmware + remote firmware )
# ---------------------------------------------------------------------------
# Release versions only: "vMAJOR.MINOR.PATCH" — no "_Bxx" beta build suffix (dropped at v3.0.1).
# Meaning: MAJOR = hardware change, MINOR = software feature change, PATCH = patch / bug fix.
# Bumped on EVERY merge of code to master, in all actively developed components at once.
# Paused components (currently the ESP32 remote firmware + its OTA binary) are deliberately
# NOT bumped, so the mismatch stays visible (see CLAUDE.md "Version sync").
INNOPILOT_VERSION      = "v3.3.2"
# Numeric form sent to the Nano (BRIDGE_VERSION_CODE, uint16): major*10000 + minor*100 + patch.
# MUST be changed together with INNOPILOT_VERSION.  (Replaces INNOPILOT_BUILD_NUM.)
INNOPILOT_VERSION_CODE = 30302

# ---------------------------------------------------------------------------
# Serial devices
# ---------------------------------------------------------------------------
# NANO_PORT is the post-fixlink path that resolves to the actual USB device.
# Default value preserves the historical CH340 Nano path; if board_conf.py is
# importable (installed alongside this script in /usr/local/bin), use the
# detected value from /var/lib/inno-pilot/board.conf so the bridge follows
# whatever Arduino variant detect_arduino.sh identified.
NANO_PORT  = "/dev/serial/by-id/usb-1a86_USB_Serial-if00-port0.real"
try:
    import board_conf as _board_conf
    _bc = _board_conf.load()
    NANO_PORT = _bc["INNO_BOARD_BYID_REAL"]
except Exception as _exc:
    # board_conf.py missing, or board.conf not yet generated — keep the default.
    # Log on first import so the operator notices when running on transitional
    # installs that pre-date detect_arduino.sh.
    print(f"[bridge] board_conf not available ({_exc}); using default NANO_PORT")
PILOT_PORT = "/dev/ttyINNOPILOT_BRIDGE"
BAUD       = 38400

# ---------------------------------------------------------------------------
# Nano serial frame codes  (6-byte wire: MAGIC1 MAGIC2 CODE LO HI CRC)
# ---------------------------------------------------------------------------

# Bridge -> Nano commands
PILOT_HEADING_CODE         = 0xE2  # imu.heading * 10 (uint16, 0-3600)
PILOT_COMMAND_CODE         = 0xE3  # ap.heading_command * 10 (uint16)
PILOT_RUDDER_CODE          = 0xE4  # -rudder.angle * 10 (int16). Bridge negates to translate
                                   # pypilot's positive=port (canonical) into the Nano's internal
                                   # coordinate (positive=Dir-A end). Coord-system bridge only —
                                   # not a convention violation.
PILOT_RUDDER_PORT_LIM_CODE = 0xE5  # -rudder.range * 10 (int16, negative: port is the lower end
                                   # of the Nano's internal Dir-A/Dir-B degree axis)
PILOT_RUDDER_STBD_LIM_CODE = 0xE6  # +rudder.range * 10 (int16, positive: stbd is the upper end
                                   # of the Nano's internal Dir-A/Dir-B degree axis)
# NOTE: 0xE7 is RESET_CODE in pypilot servo protocol — do NOT use for bridge commands

# pypilot servo protocol codes (relayed verbatim to Nano via PILOT_PORT)
PYPILOT_COMMAND_CODE   = 0xC7  # motor position command — implies AP engaged
PYPILOT_DISENGAGE_CODE = 0x68  # motor disengage — implies AP off
MANUAL_RUD_TARGET_CODE     = 0xE8  # manual rudder target: 0-1000 (0=full stbd, 1000=full port)
MANUAL_MODE_CODE           = 0xE9  # remote manual mode active: 0/1  (was 0xE7, changed to avoid RESET_CODE conflict)
WARNING_CODE               = 0xEA  # warning type to display/beep on Nano

# Warning subtypes sent with WARNING_CODE
WARN_NONE        = 0
WARN_STEER_LOSS  = 2   # TCP dropped in MANUAL: continuous beep, STOP required
WARN_SILENCE     = 3   # remote STOP: Nano silences every alarm (like its own STOP button)

# Nano -> Bridge telemetry / events
PIN_STATE_CODE    = 0xE1  # H-bridge pin state change: bits [2]=D9/EN, [1]=D3/LPWM, [0]=D2/RPWM
BUTTON_EVENT_CODE = 0xE0
PI_VOLTAGE_CODE   = 0xB4  # Nano -> Bridge: 5V logic-rail voltage *100 (shared Pi/Nano bus).
                          # Diagnostic; logged at DEBUG. Forwarded to pypilot like the other
                          # inno-pilot codes — pypilot ignores codes it doesn't recognise.

# B26: motor activation reason diagnostic — sent once when D9 goes LOW→HIGH
MOTOR_REASON_CODE = 0xEE

# Local calibrated rudder angle on the Nano ("B", 2026-10-02) — see
# rudder_cal_coeffs() and the RCAL block in motor_simple.ino.
RCAL_K2_LO_CODE  = 0xC0   # Bridge -> Nano: coefficient words (float32 as LO/HI uint16)
RCAL_K2_HI_CODE  = 0xC1
RCAL_K1_LO_CODE  = 0xC2
RCAL_K1_HI_CODE  = 0xC3
RCAL_K0_LO_CODE  = 0xC4
RCAL_K0_HI_CODE  = 0xC5
RCAL_COMMIT_CODE = 0xC6   # value = uint16 sum of the six words; applies atomically
RCAL_STATUS_CODE = 0xC8   # Nano -> Bridge: 0 none, 1 active, 2 rejected by cross-check
RCAL_STATUS_NAMES = {0: "none (steering on pypilot angle)",
                     1: "ACTIVE (steering on local angle)",
                     2: "REJECTED by cross-check (steering on pypilot angle)"}
RCAL_RESEND_S    = 10.0   # re-send period (Nano reset recovery); same values are a no-op
RCAL_SETTLE_S    = 1.0    # values must be unchanged this long before a NEW set is sent:
                          # at start-up pypilot publishes scale/offset, then re-adjusts
                          # them once rudder.range loads (seen on Dyason: offset 8.14 ->
                          # 0.25 within 0.3 s); sending the in-between set gave the Nano
                          # a calibration ~8 deg off for a moment.
# reason field (bits [3:0] of value):
_MRSN = {1: "manual_phys(btn)", 2: "delta_jog(stale_cmd)", 3: "ap_active",
         4: "rm_driving", 5: "rm_braking"}
BTN_EVT_MINUS10   = 1
BTN_EVT_MINUS1    = 2
BTN_EVT_TOGGLE    = 3
BTN_EVT_PLUS10    = 4
BTN_EVT_PLUS1     = 5
BTN_EVT_STOP      = 6
# Not a button: the Nano's AP command watchdog disengaged because pypilot's
# COMMAND frames stopped arriving (pypilot crashed or hung).
BTN_EVT_AP_LOST   = 7
# Plain names for logs / RAM sweep stop reasons shown to the skipper
BTN_EVT_NAMES = {BTN_EVT_MINUS10: "-10", BTN_EVT_MINUS1: "-1", BTN_EVT_TOGGLE: "B3",
                 BTN_EVT_PLUS10: "+10", BTN_EVT_PLUS1: "+1", BTN_EVT_STOP: "STOP",
                 BTN_EVT_AP_LOST: "AP command watchdog"}

# ---------------------------------------------------------------------------
# Phone dead-man heartbeats (safety, 2026-10-15)
# The web remote's TCP client is inno_web_remote.py on this Pi, which stays
# connected when the phone is gone (screen off, battery, overboard, Wi-Fi), so a
# TCP disconnect cannot detect a lost phone.  Anything that moves the rudder from
# the phone therefore needs a heartbeat that originates in the browser:
#  - REMOTE (MODE MANUAL): "ALIVE" lines.  Enforced once the client has sent its
#    first ALIVE in this REMOTE session (opt-in keeps the paused ESP32 remote,
#    which never sends ALIVE and relies on its own TCP drop, working).
#  - NUDGE: the page sends "NUDGE HOLD" while the button is held; a nudge with no
#    heartbeat for NUDGE_ALIVE_TIMEOUT_S stops (it used to run up to 10 s).
# ---------------------------------------------------------------------------
REMOTE_ALIVE_TIMEOUT_S = 1.5   # page sends ALIVE every 0.4 s while in REMOTE
NUDGE_ALIVE_TIMEOUT_S  = 0.8   # page sends NUDGE HOLD every 0.2 s while held
# v3.3.2: an ALIVE arriving more than this after the previous one is logged as a
# near-miss, so the journal shows how close REMOTE came to a STEER LOSS without
# Debug.  Since v3.3.2 the page also sends "ALIVE T" from touches on the wheel
# (Chrome on a Samsung S20 paused the page's timers while the skipper held the
# wheel, 2026-10-21); plain "ALIVE" comes from the page's 0.4 s timer.
REMOTE_ALIVE_LATE_S    = 1.0

# Jog soft-limit lead (bench test 2026-10-15): the bridge sees pypilot's rudder angle
# ~0.2-0.4 s late (5 Hz updates + filtering) and the rudder coasts after the motor
# stops, so stopping AT the limit ran 2.2 deg past it (0.8 deg short of the stop).
# The jog now stops when angle + speed * lead reaches the limit.  Tune on the boat:
# "NUDGE ... settled at" in the log shows where the rudder actually came to rest.
# Measured on Inno-Pilot-Rosa (12-14 deg/s): the rudder coasts only 0.6-0.9 deg after
# the stop; most of the old overshoot was pypilot's 5 Hz angle steps (~2.6 deg each
# at that speed).  0.5 s stopped 3-6 deg short; 0.25 s covers one step + coast.
NUDGE_LIMIT_LEAD_S     = 0.25
NUDGE_SETTLE_LOG_S     = 1.5   # log the resting angle this long after a limit stop

# pypilot's servo stream (COMMAND/DISENGAGE frames on the PTY) runs at >= 5 Hz in
# every mode.  Silent for this long = pypilot hung: its rudder angle is stale and is
# no longer relayed to the Nano (whose cross-check would otherwise latch a rejection
# against a frozen angle — bench test 2026-10-15).
PP_STREAM_STALE_S      = 1.0

# Skipper alerts the bridge raises itself (telemetry "WARN <code>"; bare "WARN" = none).
ALERT_STEER_LOSS = "STEER_LOSS"   # REMOTE steering stopped: phone/link lost
ALERT_AP_LOST    = "AP_LOST"      # autopilot stopped steering: pypilot lost
ALERT_HOLD_S     = 120.0          # shown this long unless the skipper re-engages first
ALERT_LIMITS_UNSET = "LIMITS_UNSET"  # motion refused or stopped: rudder limits not set/valid


# Bridge-side AP stream watchdog: in AP mode pypilot sends COMMAND at >= 5 Hz.
# None for this long means nothing is steering although the remote shows AP
# (pypilot hung, or the skipper re-engaged while it was hung so the Nano never
# engaged).  Longer than the Nano's own 1.5 s watchdog, which normally acts first;
# this one also covers a lost Nano event and a Nano that never engaged.
AP_STREAM_TIMEOUT_S = 3.0

# Nano -> Bridge new telemetry
BUZZER_STATE_CODE = 0xEB  # Nano->Bridge: buzzer on(1)/off(0)
COMMS_DIAG_CODE       = 0xEC  # Nano->Bridge: comms diagnostics (lo=err_window_sum, hi=crit_consec_s)
COMMS_ERR_DETAIL_CODE = 0xED  # Nano->Bridge: error detail (lo=corrupt code, hi=rx_crc)

# ---------------------------------------------------------------------------
# Nano loop profiling (B8) — measurement only, no control effect.
# The Nano sends one metric per frame in a 13-frame burst every 5 s, spread one
# frame per loop pass so the burst stays inside its 64-byte TX buffer.
#
# Durations are microseconds already clamped to 65535 by the Nano; a reported
# 65535 means that metric overflowed uint16 and must be rescaled on the Nano
# before the number is trusted.
#
# Purpose: every CRC error observed on Dyason fell on a ~1.0086 s grid, but both
# oled_draw() and temp_service() run on a 1000 ms period — these metrics (in
# particular rx_avail after oled vs after temp) are what tell the two apart.
#
# Reading the buffer metrics: SERIAL_RX_BUFFER_SIZE (0xDA) is only what the SKETCH
# was compiled with, which an incremental build on a warm cache can leave out of
# step with the linked core. The trustworthy figure is the observed high-water
# (0xD8), which can never exceed the real buffer size minus one. If 0xDA reports
# 128 but 0xD8 never passes 63, the flag did not reach the linked core.
# ---------------------------------------------------------------------------
PROF_CODES: dict[int, tuple[str, str]] = {
    0xD0: ("oled_draw max",         "us"),
    0xD1: ("oled_draw mean",        "us"),
    0xD2: ("temp_service max",      "us"),
    0xD3: ("rudder_adc max",        "us"),
    0xD4: ("motor_update max",      "us"),
    0xD5: ("serial_rx max",         "us"),
    0xD6: ("loop max",              "us"),
    0xD7: ("loop mean",             "us"),
    0xD8: ("rx_avail high-water",   "bytes"),
    0xD9: ("rx_avail >= 63",        "times"),
    0xDA: ("SERIAL_RX_BUFFER_SIZE", "bytes"),
    0xDB: ("rx_avail after oled",   "bytes"),
    0xDC: ("rx_avail after temp",   "bytes"),
}

# Codes the Nano sends in 4 us units rather than plain us (B9). B8 reported these
# four pinned at the uint16 us ceiling — max AND mean — so their real durations were
# invisible; micros() resolution on AVR is 4 us, so this costs no precision and
# raises the range from 65.5 ms to 262 ms. Scaled back here so the log reads in
# plain us. A value of 262140 us means it is STILL clamped and needs rescaling again.
PROF_SCALE_4US: frozenset[int] = frozenset({0xD0, 0xD1, 0xD6, 0xD7})

# Bridge -> Nano: feature enable bitmask (0xEF)
FEATURES_CODE             = 0xEF  # Bridge->Nano: uint8 feature bitmask (sent on startup + settings change)
FEATURE_LIMIT_SWITCHES    = 0x01  # use D7/D8 NC limit switches
FEATURE_TEMP_SENSOR       = 0x02  # DS18B20 temperature fault detection
FEATURE_PI_VOLTAGE        = 0x04  # A3 Pi supply voltage fault detection
FEATURE_BATTERY_VOLTAGE   = 0x08  # A0 main Vin over/under-voltage fault detection
FEATURE_CURRENT_SENSOR    = 0x10  # A1 motor current telemetry
FEATURE_ON_BOARD_BUTTONS  = 0x20  # physical button ladder on A6 is wired
FEATURE_OLED_SH1106       = 0x40  # OLED uses SH1106 controller (vs SSD1306)
FEATURE_INVERT_CLUTCH     = 0x80  # Clutch relay is active-LOW (invert pin 11 logic)

# Second feature-flags byte (EEPROM offset 23, layout v2).
# Not sent via FEATURES_CODE at runtime; EEPROM-only until direction-inversion logic is wired in.
FEATURE2_INVERT_MOTOR     = 0x01  # Invert H-bridge direction (storage only for now)

# Bridge -> Nano: settings EEPROM write (0xF2, B47+).
# 0x53 is reserved for the arduino_servo pass-through protocol (EEPROM_WRITE_CODE).
# Using a separate code avoids the byte-order conflict: arduino_servo encodes
# as lo=addr/hi=data, while the bridge settings push uses hi=addr/lo=data.
BRIDGE_SETTINGS_WRITE_CODE = 0xFA  # Bridge->Nano: uint16 = (addr<<8)|data_byte

# EEPROM binary layout constants
EEPROM_MAGIC1             = 0xAA
EEPROM_MAGIC2             = 0x55
EEPROM_LAYOUT_VERSION     = 2

# Nano -> Bridge pypilot result codes (parsed here, also forwarded to pypilot)
FLAGS_CODE        = 0x8F  # Nano flags word — bridge relays fault bits to remote

# Flag bit masks for bridge-side parsing of FLAGS_CODE value
FLAG_COMMS_WARN   = 0x1000  # error rate elevated (WARN level)
FLAG_COMMS_CRIT   = 0x2000  # error rate unsafe, AP auto-disengaged (CRITICAL level)

# RCT (Remote Control Test) frame codes — ignored by production motor_simple.ino
RCT_SETTING_CODE        = 0xEE  # both dirs: HI=setting_index (0-6), LO=uint8 value
RCT_TARGET_CODE         = 0xF3  # Pi -> Nano: target pct×10 (0-1000; 500 = midships)
RCT_RESULT_STOP_CODE    = 0xF4  # Nano -> Pi: first_stop_adc after full-power coast
RCT_RESULT_PULSES_CODE  = 0xF5  # Nano -> Pi: fine pulse count used to reach deadband
RCT_RESULT_FINAL_CODE   = 0xF6  # Nano -> Pi: final_adc inside (or nearest to) deadband
RCT_RDR_PCT_CODE        = 0xF7  # Nano -> Pi: ratify live rudder position pct×10 (0-1000)
RCT_HZ_CODE             = 0xF8  # Nano -> Pi: ratify loop Hz (sent once per second)

# RCT settings — stored on Pi as JSON, pushed to Nano on bridge startup
RCT_SETTINGS_PATH = "/etc/inno-pilot/rct_settings.json"

# ---------------------------------------------------------------------------
# Pilot settings — user-configurable parameters, owned by bridge
# ---------------------------------------------------------------------------
PILOT_SETTINGS_PATH = "/var/lib/inno-pilot/settings.json"

# ---------------------------------------------------------------------------
# Rudder limits ("no rudder motion before limits are set", agreed 2026-10-15).
#
# The bridge refuses every rudder motion (AP, REMOTE, jog, sweep) until the
# skipper has set the rudder limits BY HAND in the Dock-Side Wizard: clutch out,
# turn the wheel/tiller to centre and to each stop while the bridge captures the
# rudder sensor, then confirm soft limits a few degrees inside each stop.
#
# The capture reuses pypilot's own 3-point calibration (rudder.py, triggered via
# rudder.calibration_state): the stops are DECLARED to be at +/-rudder.range.
# The limits are stored together with the calibration they were set against
# (scale/offset/nonlinearity/range).  Any later change to that calibration --
# a reset or capture on pypilot's port 8000 page, a range edit, the Nano's
# EEPROM copy differing -- makes the limits invalid, and the bridge stops any
# motion in progress.  The file is owned by the bridge and is deliberately NOT
# part of settings.json, so SETTINGS SET from a remote cannot mark limits "set".
#
# NOTE: the soft limits are enforced by the bridge only for the jog and the
# sweep.  AP and REMOTE are still bounded only by pypilot's +/-range and the
# Nano's own limits (TODO.md HIGH item) -- "limits set" is a precondition for
# motion, not yet a guarantee that every mode stays inside them.
# ---------------------------------------------------------------------------
RUDDER_LIMITS_PATH = "/var/lib/inno-pilot/rudder_limits.json"
LIMITS_MARGIN_DEFAULT_DEG = 3.0  # proposed soft limit = stop - this
LIMITS_MIN_MARGIN_DEG     = 1.0  # a soft limit must be at least this far inside its stop
LIMITS_MIN_DEG            = 5.0  # ... and at least this far from centre
LIMITS_CAP_SAMPLE_S       = 1.0  # a capture samples the rudder angle for this long
LIMITS_CAP_STILL_DEG      = 0.5  # ... and fails if it moved more than this (not held still)
LIMITS_CAP_SETTLE_S       = 2.0  # pypilot needs a moment to apply a capture before SET
LIMITS_RANGE_MIN_DEG      = 10.0 # pypilot rudder.range bounds (RangeProperty 10..100)
LIMITS_RANGE_MAX_DEG      = 100.0
# Calibration tolerance when comparing with the values stored at "limits set".
# pypilot re-adopts the Nano's EEPROM copy on every connect, which is quantised
# (arduino_servo mirror: offset*64, scale*8, nonlinearity*8), so allow one step.
LIMITS_CAL_TOL = {"scale": 0.13, "offset": 0.02, "nonlinearity": 0.13, "range": 0.5}
# pypilot calibration_state names for each captured point
LIMITS_CAP_POINTS = {"CENTRE": "centered", "PORT": "port range", "STBD": "starboard range"}

_DEFAULT_PILOT_SETTINGS: dict = {
    "network": {
        "ip_mode": "dhcp",
        "ip":      "",
        "mask":    "255.255.255.0",
        "gateway": "",
        "dns1":    "8.8.8.8",
        "dns2":    "8.8.4.4",
    },
    "wifi": {
        "ssid": "",
        "key":  "",
    },
    "vessel": {
        "name":             "",
        "type":             "sail",
        "rudder_range_deg": 35,
    },
    "features": {
        "limit_switches":         False,
        "temp_sensor":            False,
        "pi_voltage_sensor":      False,
        "battery_voltage_sensor": False,
        "current_sensor":         False,
        "on_board_buttons":       False,
        "oled_sh1106":            False,
        "invert_clutch":          False,
        "invert_motor":           False,
    },
    "autopilot": {
        "deadband_pct":           3.0,
        "pgain":                  1.0,
        "off_course_alarm_deg":   20,
        # Convention: pct=100 = full port, pct=0 = full stbd (matches conv. 1, 2, 7).
        # rudder_limit_port_pct is therefore the *upper* allowed pct (default 100 = no limit).
        # rudder_limit_stbd_pct is the *lower* allowed pct (default 0 = no limit).
        # NO LONGER USED (v3.3.0): replaced by the Dock-Side Wizard's degree limits in
        # RUDDER_LIMITS_PATH.  Kept only because they are still part of the Nano
        # EEPROM settings block (_serialize_settings); see TODO.md DUP-06.
        "rudder_limit_port_pct":  100,
        "rudder_limit_stbd_pct":  0,
    },
    "safety": {
        "auto_disengage_on_fault":  True,
        "comms_warn_threshold_pct": 10,
        "comms_crit_threshold_pct": 25,
    },
}

# In-memory pilot settings — loaded at startup, updated on SETTINGS SET.
# Only accessed from the main thread; no locking required.
_pilot_settings: dict = {}

# Ordered list of setting keys (index must match Nano's RCT_SETTING_NAMES order)
_RCT_KEYS = [
    "pwm_max",         # 0
    "coast_count_max", # 1
    "pwm_min",         # 2
    "coast_count_min", # 3
    "pulse_ms",        # 4
    "deadband",        # 5
    "pulse_delay_ms",  # 6
]
_RCT_DEFAULTS: dict = {
    "pwm_max":         255,
    "coast_count_max":  50,
    "pwm_min":         160,
    "coast_count_min":  10,
    "pulse_ms":         20,
    "deadband":         20,
    "pulse_delay_ms":  100,
}

# Bridge <-> Nano keepalive framing
BRIDGE_MAGIC1         = 0xA5
BRIDGE_MAGIC2         = 0x5A
BRIDGE_HELLO_CODE     = 0xF0
BRIDGE_HELLO_ACK_CODE = 0xF1
BRIDGE_HELLO_VALUE    = 0xBEEF
BRIDGE_VERSION_CODE   = 0xF2  # Bridge -> Nano: version code, major*10000+minor*100+patch (uint16)

# ---------------------------------------------------------------------------
# Bridge mode identifiers
# ---------------------------------------------------------------------------
MODE_IDLE    = "IDLE"
MODE_AP      = "AP"
MODE_MANUAL  = "MANUAL"
MODE_RAM_OFF = "RAM_OFF"   # RAM test armed, waiting for B3
MODE_RAM_ON  = "RAM_ON"    # RAM test actively reciprocating

# Plain-text hardware-test protocol ("TEST <id>" -> TEST_LINE/TEST_DONE).
# False until a Nano sketch actually implements it — see the TEST handler.
NANO_TEST_PROTOCOL_SUPPORTED = False

# ---------------------------------------------------------------------------
# Timing
# ---------------------------------------------------------------------------
HELLO_PERIOD_S    = 1.0   # Nano keepalive — Nano requires 3 frames within 5 s
TELEM_PERIOD_S    = 0.2   # 5 Hz telemetry to Nano and remote

# ---------------------------------------------------------------------------
# Rudder-stall detection
# ---------------------------------------------------------------------------
# A "fail" is one 200 ms commanded cycle where the rudder did not move ≥ 2°
# from the current reference angle in the commanded direction.  The fail count
# is direction-agnostic (SB fail + PORT fail + … all accumulate together).
# A "success" is a commanded cycle where ≥ 2° of movement WAS achieved; two
# consecutive successes clear the fault and reset all counters.
STALL_FAIL_THRESHOLD = 5    # direction-agnostic fails to trip fault
STALL_SUCC_THRESHOLD = 2    # successes (any direction) to clear fault
STALL_MOVE_DEG       = 2.0  # minimum rudder travel (degrees) per cycle to count as a success

# ---------------------------------------------------------------------------
# RAM test = rudder commissioning sweep (Settings -> Hardware Tests -> 1)
# ---------------------------------------------------------------------------
# A short, ATTENDED measurement run: the rudder sweeps +/-N deg for a few cycles
# while the operator holds a dead-man button.  It measures rudder speed per
# direction, reversal lag, overshoot/settled position at each end and (if a
# current sensor is fitted) motor current.  It is NOT an endurance test —
# unattended running is deliberately impossible:
#   * the browser sends "RAM HOLD" every ~200 ms while the button is held;
#     no HOLD for RAM_HOLD_TIMEOUT_S stops the test (finger lifted, phone
#     dropped/locked, page closed, WiFi lost all end the heartbeat);
#   * every other exit (STOP anywhere, any helm/remote button, mode change,
#     stall, lost rudder angle, remote gone) goes through ram_test_abort().
# A stop never auto-centres the rudder: that would be motion with nobody
# holding the button.  The rudder stays where it stopped and MANUAL is released.
RAM_HOLD_TIMEOUT_S     = 1.0   # dead-man: max gap between RAM HOLD heartbeats
RAM_ARM_TIMEOUT_S      = 60.0  # armed but never held -> disarm (releases clutch)
RAM_STROKE_TIMEOUT_S   = 40.0  # belt-and-braces: one stroke may never take longer
RAM_MIN_DEG            = 5     # smaller sweeps give no usable speed window
RAM_DEFAULT_CYCLES     = 3
RAM_MAX_CYCLES         = 10
RAM_REACH_DEG          = 2.0   # min distance from the end target that counts as "arrived";
                               # widened to the Nano's own deadband + RAM_REACH_MARGIN_DEG
                               # (see ram_nano_deadband_deg) — the Nano deliberately stops
                               # anywhere inside that band, which is NOT a stall.
RAM_REACH_MARGIN_DEG   = 1.0   # slack on top of the Nano deadband (coast, angle filtering)
RAM_MIN_TRAVEL_DEG     = 5.0   # each stroke must be able to travel at least this far
                               # beyond the deadband shortfall, or speed is not measurable
RAM_SETTLE_STILL_DEG   = 0.3   # "still" = moved less than this ...
RAM_SETTLE_STILL_S     = 0.6   # ... for this long
RAM_SETTLE_TIMEOUT_S   = 3.0   # settle phase gives up (recorded) after this
RAM_LAG_MOVE_DEG       = 0.5   # first movement this far = end of reversal lag
RAM_JAM_MOVE_DEG       = 0.5   # sweep's own jam check: less progress than this ...
RAM_JAM_S              = 2.0   # ... for this long while driving = rudder stuck.
                               # Deliberately NOT the generic 2 deg/s stall detector: it
                               # is a speed criterion, and a sweep must not depend on how
                               # fast a particular ram is (false stall on Dyason
                               # 2026-10-01).  0.5 deg / 2 s still catches a jam quickly.
RAM_SPEED_WINDOW_FRAC  = 0.6   # speed timed across the central 60% of the distance
                               # each stroke ACTUALLY travelled (20%..80%)

# ---------------------------------------------------------------------------
# Remote TCP server
# ---------------------------------------------------------------------------
REMOTE_TCP_PORT        = 8555
REMOTE_TIMEOUT_S       = 6.0   # disconnect if no data received for this long
REMOTE_PING_PERIOD_S   = 2.0   # send PONG keepalive to remote every N seconds

# ---------------------------------------------------------------------------
# OTA firmware server (serves inno_remote.bin to remote on version mismatch)
# ---------------------------------------------------------------------------
OTA_HTTP_PORT     = 8556
OTA_FIRMWARE_DIR  = "/var/lib/inno-pilot/ota"
OTA_FIRMWARE_FILE = "inno_remote.bin"
OTA_FIRMWARE_PATH = f"{OTA_FIRMWARE_DIR}/{OTA_FIRMWARE_FILE}"

# ---------------------------------------------------------------------------
# Probe / discovery constants
# ---------------------------------------------------------------------------
PROBE_INITIAL_DELAY_S = 1.0
PROBE_RETRIES         = 5
PROBE_RETRY_DELAY_S   = 3.0

# ---------------------------------------------------------------------------
# pypilot reconnect constants
# ---------------------------------------------------------------------------
PYPILOT_RECONNECT_DELAY_S = 3.0


# ===========================================================================
# Shared pypilot state (owned by pypilot_worker, read by main thread)
# ===========================================================================

@dataclass
class PypilotState:
    """Thread-safe container for pypilot values.  Always access under state_lock."""
    ap_enabled:   Optional[bool]  = None
    heading:      Optional[float] = None
    heading_cmd:  Optional[float] = None
    rudder_angle: Optional[float] = None
    rudder_range: Optional[float] = None
    servo_current: Optional[float] = None   # servo.current (A); only meaningful with a current sensor
    # pypilot rudder calibration (rudder.py): angle = scale*u + offset + nl*(m0-u)*(m1-u)
    rudder_scale:  Optional[float] = None
    rudder_offset: Optional[float] = None
    rudder_nonlin: Optional[float] = None
    connected:    bool            = False


# ===========================================================================
# RAM commissioning sweep: one stroke's measurements
# ===========================================================================

@dataclass
class RamStroke:
    """One stroke of the RAM sweep, from a reversal command to the settled end.

    Sign convention: ``direction`` is the bridge's ram_test_direction
    (+1 = driving toward STBD, -1 = toward PORT).  pypilot angles are
    +port/-stbd, so progress along the stroke is ``-direction * angle``.
    """
    direction:   int             # +1 toward stbd, -1 toward port
    target_deg:  float           # end target, pypilot convention (+port)
    start_t:     float           # monotonic time the reversal target was sent
    start_angle: float           # rudder angle when the stroke was commanded
    full:        bool            # False for the first (approach) stroke — not measured
    phase:       str   = "drive" # "drive" -> "settle"
    move_t:      Optional[float] = None  # first RAM_LAG_MOVE_DEG of movement
    samples:     list = field(default_factory=list)  # (t, progress) on each angle change
    jam_ref:     Optional[float] = None  # progress at the last jam checkpoint
    jam_since:   float = 0.0             # time of the last jam checkpoint
    speed_dps:   Optional[float] = None  # set when the stroke finishes
    lag_s:       Optional[float] = None  # reversal lag, set when the stroke finishes
    settle_t:    Optional[float] = None  # entered settle phase
    still_ref:   float = 0.0
    still_since: float = 0.0
    peak:        float = 0.0     # furthest progress reached (deg, in stroke direction)
    settled:     Optional[float] = None  # final angle (pypilot convention)
    settle_timeout: bool = False
    i_peak:      Optional[float] = None  # motor current while driving (A)
    i_sum:       float = 0.0
    i_n:         int   = 0


# ===========================================================================
# Bridge-local state (main thread only, no locking needed)
# ===========================================================================

@dataclass
class BridgeState:
    """Mode state machine and bridge-local bookkeeping."""
    mode:              str  = MODE_IDLE  # IDLE / AP / MANUAL
    manual_rud_target: int  = 500        # 0-1000, sent as MANUAL_RUD_TARGET_CODE
    nano_buzzer_on:    bool = False      # last known Nano buzzer state
    # Comms-fault state (populated from Nano FLAGS and COMMS_DIAG frames)
    nano_comms_warn:      bool = False
    nano_comms_crit:      bool = False
    nano_err_window:      int  = 0       # errors in last 10-second window
    nano_crit_consec:     int  = 0       # consecutive seconds above CRIT threshold
    comms_disengage_sent: bool = False   # latch: prevents repeated disengage on same fault
    rct_target:            int  = 500        # last TGT sent to Nano (pct×10, 0-1000)
    rct_last_rdr_send:   float = 0.0        # monotonic time of last RDR_PCT forward to remote
    test_mode:            bool = False       # True while a TEST <id> is running (pwm_test.ino)
    servo_cmd_dir:         int  = 0         # last pypilot servo command direction: -1=port, 0=neutral, 1=stbd
    ram_test_deg:          int  = 0         # RAM test: degrees each side of centre to sweep
    ram_test_running:      bool = False      # RAM test: actively reciprocating
    ram_test_direction:    int  = 1          # RAM test: current sweep direction +1=stbd, -1=port
    ram_cycles:            int  = RAM_DEFAULT_CYCLES  # full port+stbd cycles to measure
    ram_armed_at:        float = 0.0        # monotonic time RAM_SETUP armed the test
    ram_hold_last:       float = 0.0        # monotonic time of last RAM HOLD heartbeat
    ram_rng:             float = 35.0       # rudder range (deg each side) captured at arm time
    ram_db_deg:          float = 0.8        # Nano manual-mode deadband (deg) captured at arm time
    ram_reach_deg:       float = RAM_REACH_DEG  # "arrived" band used for the settle phase
    ram_stroke: Optional["RamStroke"] = None  # stroke currently being driven/measured
    ram_results: list = field(default_factory=list)  # finished RamStroke records
    ram_result_pending: Optional[str] = None  # RAM_RESULT JSON waiting to go to remotes
    # Nano local calibrated angle ("B")
    rcal_sent_words: Optional[tuple] = None   # last six words sent
    rcal_last_send:  float = 0.0
    rcal_status:     Optional[int] = None     # last RCAL_STATUS from the Nano
    rcal_cand_words: Optional[tuple] = None   # candidate set waiting to settle
    rcal_cand_since: float = 0.0
    # Nudge state — brief full-power motor jog without disengaging pypilot
    nudge_until:          float = 0.0       # monotonic expiry; 0 = inactive
    nudge_cmd_val:          int = 0         # PYPILOT_COMMAND_CODE value: 2000=full port, 0=full stbd (conv 1)
    nudge_was_idle:        bool = False      # True if mode was IDLE when nudge was triggered
    nudge_last_sent:      float = 0.0       # monotonic time of last synthetic COMMAND frame sent
    nudge_alive_last:     float = 0.0       # monotonic time of the last NUDGE start/HOLD from the page
    nudge_prev_angle: Optional[float] = None  # jog speed estimate (soft-limit lead)
    nudge_prev_t:         float = 0.0
    nudge_speed:          float = 0.0       # deg/s, + = port (pypilot convention)
    nudge_settle_at:      float = 0.0       # when to log the resting angle after a limit stop
    nudge_settle_lim:     float = 0.0
    pp_frame_last:        float = 0.0       # monotonic time of the last valid frame FROM pypilot's servo
    # REMOTE dead-man (see REMOTE_ALIVE_TIMEOUT_S)
    manual_alive_last:    float = 0.0       # monotonic time of the last ALIVE in REMOTE
    manual_hb_seen:        bool = False     # client sent ALIVE this REMOTE session -> enforce
    # Skipper alert raised by the bridge (ALERT_*), sent as telemetry "WARN <code>"
    alert:        Optional[str] = None
    alert_at:             float = 0.0       # monotonic time the alert was raised
    # pypilot connection, previous loop (detects a crash/restart while engaged)
    prev_pp_connected: Optional[bool] = None
    # No surprise re-engage: set when the bridge itself stopped the AP because
    # pypilot vanished (connection lost / Nano AP command watchdog).  While set,
    # pypilot COMMAND frames are not relayed to the Nano, so a pypilot that comes
    # back still engaged cannot re-engage the motor after the skipper was told
    # "AUTOPILOT: STOPPED".  Cleared by pypilot's own DISENGAGE (it has caught
    # up) or by the skipper engaging the AP again.
    pp_cmd_block: bool = False
    pp_cmd_last:  float = 0.0        # monotonic time of the last COMMAND frame FROM pypilot
    # Rudder limits (see RUDDER_LIMITS_PATH).  limits_ok is re-evaluated every
    # loop; while False every rudder motion is refused or stopped.
    rudder_limits: dict = field(default_factory=dict)  # contents of RUDDER_LIMITS_PATH
    limits_ok:      bool = False
    limits_reason:  str  = "not checked yet"
    last_cal: Optional[dict] = None    # last complete pypilot calibration seen (kept
                                       # across a pypilot outage so REMOTE stays usable)
    limits_ap_stop_sent: float = 0.0   # rate-limits "ap.enabled=False" while blocked
    # By-hand capture in progress (LIMITS CAPTURE <point>)
    lim_cap_point: Optional[str] = None   # CENTRE / PORT / STBD being sampled
    lim_cap_t0:    float = 0.0
    lim_cap_min:   float = 0.0
    lim_cap_max:   float = 0.0
    lim_cap_done:  dict = field(default_factory=dict)  # point -> time captured (this session)
    lim_cap_last:  float = 0.0     # monotonic time of the last capture sent to pypilot
    lim_msg:       str  = ""       # last result line for the wizard page
    # Fix #5c two-way sync: tracks the last pypilot rudder.range value mirrored into
    # _pilot_settings, to avoid re-persisting and re-pushing on every loop iteration.
    last_synced_rudder_range: float = -1.0
    # Rudder-stall detection
    rudder_stall:     bool           = False  # True when stall fault is active
    stall_fail_count: int            = 0      # direction-agnostic fail count (trips at STALL_FAIL_THRESHOLD)
    stall_succ_count: int            = 0      # success count (direction-agnostic; clears fault at STALL_SUCC_THRESHOLD)
    stall_ref_angle:  Optional[float] = None  # rudder_angle snapshot; reset on direction change or idle
    stall_prev_dir:   int            = 0      # commanded direction at previous cycle (+1/0/-1)


# ===========================================================================
# pypilot daemon thread
# ===========================================================================

def pp_number(value) -> Optional[float]:
    """A pypilot value as a float, or None when pypilot marks it invalid.

    pypilot sends False for an invalid sensor reading; bool is a subclass of int
    in Python, so float(False) silently gives 0.0 -- never use float() directly.
    """
    if isinstance(value, bool) or value is None:
        return None
    try:
        return float(value)
    except (TypeError, ValueError):
        return None


def pypilot_worker(
    state: PypilotState,
    lock: threading.Lock,
    set_q: "queue.Queue[tuple]",
) -> None:
    """
    Daemon thread: owns all pypilotClient interaction.
    receive() may block on pselect; the 10ms sleep prevents spinning
    which would starve the main loop on the single-core Pi Zero.
    """
    while True:
        try:
            # Explicit host pins the connection to the local pypilot instance
            # (always co-resident on this Pi at the default port) and, as a
            # side effect, sets pypilotClient.can_probe = False -- omitting
            # the host previously made the client import python-zeroconf and
            # scan for "_pypilot._tcp.local." on every (re)connect, which
            # competed with the system avahi-daemon on UDP 5353 the same way
            # server.py's self-announcement and signalk.py's discovery did
            # (see CLAUDE.md "pypilot fork strategy"). No discovery is ever
            # needed here: bridge and pypilot always run on the same host.
            client = pypilotClient('127.0.0.1')
            client.watch('imu.heading', True)
            client.watch('ap.heading_command', True)
            client.watch('rudder.angle', True)
            client.watch('rudder.range', 1.0)
            client.watch('servo.current', 0.25)   # RAM sweep current stats
            client.watch('rudder.scale', True)    # calibration -> Nano local angle
            client.watch('rudder.offset', True)
            client.watch('rudder.nonlinearity', True)
            log_pp.info("pypilot client started (127.0.0.1) — connects on first poll")

            while True:
                # Drain outbound set() queue before blocking on receive()
                while True:
                    try:
                        key, val = set_q.get_nowait()
                        client.set(key, val)
                    except queue.Empty:
                        break

                msgs = client.receive(0)
                # Sleep to yield CPU back to main thread on single-core Pi Zero
                time.sleep(0.01)

                # Connection state from the client itself.  pypilotClient never
                # raises when pypilot goes away: it closes the socket
                # (client.connection = False) and quietly reconnects on later
                # polls, re-sending our watches.  This used to be "connected = True"
                # on every pass, so a dead pypilot looked alive and the bridge's
                # "pypilot connection lost" stop never fired (only the Nano's 1.5 s
                # watchdog caught it — bench test on Inno-Pilot-Rosa, 2026-10-15).
                conn_now = bool(client.connection)
                with lock:
                    was = state.connected
                    state.connected = conn_now
                if was and not conn_now:
                    log_pp.warning("Connection lost: pypilot closed the connection — reconnecting")
                elif conn_now and not was:
                    log_pp.info("pypilot connection up")

                with lock:
                    # pypilot reports an INVALID sensor value as False (e.g. rudder.angle
                    # while the servo reconnects after a restart, or with a dead rudder
                    # sensor).  float(False) is 0.0, so the bridge used to report a
                    # confident 0 deg: the web rudder bar/helm jumped to centre for ~0.5 s
                    # on every pypilot restart (seen on Inno-Pilot-Rosa as a "wild swing"),
                    # and jog limits / REMOTE seeding / stall check would have used it.
                    # Invalid live readings now become None ("unknown").
                    for key, attr in (("ap.heading_command", "heading_cmd"),
                                      ("imu.heading", "heading"),
                                      ("rudder.angle", "rudder_angle"),
                                      ("servo.current", "servo_current")):
                        if key in msgs:
                            setattr(state, attr, pp_number(msgs[key]))
                    if "rudder.range" in msgs:
                        rng = pp_number(msgs["rudder.range"])
                        if rng is not None:          # never forget a known range
                            state.rudder_range = rng
                    for key, attr in (("rudder.scale", "rudder_scale"),
                                      ("rudder.offset", "rudder_offset"),
                                      ("rudder.nonlinearity", "rudder_nonlin")):
                        if key in msgs:
                            val = pp_number(msgs[key])
                            if val is not None:      # calibration: keep the last known value
                                setattr(state, attr, val)

        except Exception as exc:
            log_pp.warning("Connection lost: %s — retrying in %ds", exc, PYPILOT_RECONNECT_DELAY_S)
            with lock:
                state.connected = False
            time.sleep(PYPILOT_RECONNECT_DELAY_S)


# ===========================================================================
# Serial helpers
# ===========================================================================

def open_serial_no_reset(port: str, baud: int, timeout: float) -> serial.Serial:
    """Open serial port while keeping DTR/RTS low to avoid Arduino resets.

    Also clears the HUPCL termios flag so that DTR is not dropped when the
    port is later closed — otherwise the kernel drops DTR on close, which
    triggers the Nano's reset circuit and causes it to restart.
    """
    ser = serial.Serial()
    ser.port = port
    ser.baudrate = baud
    ser.timeout = timeout
    ser.dsrdtr = False
    ser.rtscts = False
    ser.open()
    try:
        ser.dtr = False
        ser.rts = False
    except Exception:
        pass
    # Disable HUPCL: prevents DTR from dropping when the fd is closed.
    # Without this, every close() resets the Nano via its RC-differentiator
    # on the RESET pin, even if dtr=False was set during open.
    attrs = termios.tcgetattr(ser.fd)
    attrs[2] &= ~termios.HUPCL  # cflag: clear hang-up-on-close
    termios.tcsetattr(ser.fd, termios.TCSANOW, attrs)
    return ser


def crc8_msb(data: bytes, poly: int = 0x31, init: int = 0xFF) -> int:
    """CRC-8 MSB-first, poly 0x31, init 0xFF (matches Arduino crc8)."""
    crc = init
    for b in data:
        crc ^= b
        for _ in range(8):
            if crc & 0x80:
                crc = ((crc << 1) & 0xFF) ^ poly
            else:
                crc = (crc << 1) & 0xFF
    return crc & 0xFF


def build_frame(code: int, value_u16: int) -> bytes:
    lo = value_u16 & 0xFF
    hi = (value_u16 >> 8) & 0xFF
    body = bytes([code, lo, hi])
    return body + bytes([crc8_msb(body)])


def wrap_frame(frame: bytes) -> bytes:
    return bytes([BRIDGE_MAGIC1, BRIDGE_MAGIC2]) + frame


def send_nano_frame(nano: serial.Serial, code: int, value_u16: int) -> None:
    raw = wrap_frame(build_frame(code, value_u16))
    log.debug("nano TX  code=0x%02X val=%d  hex=%s", code, value_u16, raw.hex())
    nano.write(raw)


def extract_wrapped_frames(buf: bytearray) -> list[tuple[bytes, bool]]:
    """Pull all complete 6-byte frames out of buf (mutates buf in place).

    Returns list of (frame_4bytes, crc_ok) tuples. Callers must skip frames
    where crc_ok is False rather than forwarding corrupt data.
    """
    frames: list[tuple[bytes, bool]] = []
    while len(buf) >= 2:
        if buf[0] != BRIDGE_MAGIC1 or buf[1] != BRIDGE_MAGIC2:
            del buf[0]
            continue
        if len(buf) < 6:
            break
        frame = bytes(buf[2:6])
        del buf[:6]
        crc_ok = (crc8_msb(frame[:3]) == frame[3])
        frames.append((frame, crc_ok))
    return frames


# ===========================================================================
# Nano discovery / probe
# ===========================================================================

def probe_nano_port(port: str, timeout_s: float = 0.5) -> bool:
    try:
        with open_serial_no_reset(port, BAUD, timeout=0.1) as probe:
            time.sleep(PROBE_INITIAL_DELAY_S)
            for attempt in range(PROBE_RETRIES):
                probe.reset_input_buffer()
                send_nano_frame(probe, BRIDGE_HELLO_CODE, BRIDGE_HELLO_VALUE)
                buf = bytearray()
                deadline = time.monotonic() + timeout_s
                while time.monotonic() < deadline:
                    chunk = probe.read(64)
                    if chunk:
                        buf.extend(chunk)
                        for frame, crc_ok in extract_wrapped_frames(buf):
                            if not crc_ok:
                                continue
                            code = frame[0]
                            value = frame[1] | (frame[2] << 8)
                            if code == BRIDGE_HELLO_ACK_CODE and value == BRIDGE_HELLO_VALUE:
                                return True
                if attempt < (PROBE_RETRIES - 1):
                    time.sleep(PROBE_RETRY_DELAY_S)
            return False
    except Exception:
        return False


def find_nano_port() -> str:
    by_id = "/dev/serial/by-id"
    candidates: list[str] = []
    if os.path.isdir(by_id):
        for entry in sorted(os.listdir(by_id)):
            path = os.path.join(by_id, entry)
            if os.path.islink(path):
                if os.path.realpath(path) == "/dev/ttyINNOPILOT":
                    continue
                candidates.append(path)
    if NANO_PORT not in candidates and os.path.exists(NANO_PORT):
        candidates.append(NANO_PORT)

    if os.path.exists(NANO_PORT):
        return NANO_PORT

    for candidate in candidates:
        if probe_nano_port(candidate):
            return candidate

    raise RuntimeError(f"Unable to find Nano on serial ports: {candidates}")


# ===========================================================================
# Encoding helpers
# ===========================================================================

def clamp_heading(deg: float) -> float:
    deg = deg % 360.0
    if deg < 0:
        deg += 360.0
    return deg


def enc_deg10_u16(deg: float) -> int:
    """0..360 deg -> 0..3600 (uint16)."""
    v = int(round(clamp_heading(float(deg)) * 10.0))
    return max(0, min(3600, v)) & 0xFFFF


def enc_deg10_i16(deg: float) -> int:
    """Signed degrees -> int16 tenths as two's-complement uint16."""
    v = int(round(float(deg) * 10.0))
    v = max(-32768, min(32767, v))
    return v & 0xFFFF


# ===========================================================================
# RCT settings helpers
# ===========================================================================

def load_or_create_rct_settings() -> dict:
    """Load RCT settings from JSON, creating the file with defaults if absent."""
    if os.path.isfile(RCT_SETTINGS_PATH):
        try:
            with open(RCT_SETTINGS_PATH) as fh:
                data = json.load(fh)
            # Back-fill any missing keys added in later versions
            missing = {k: v for k, v in _RCT_DEFAULTS.items() if k not in data}
            if missing:
                data.update(missing)
                _save_rct_settings(data)
            return data
        except Exception as exc:
            log.warning("RCT settings load failed (%s) — recreating with defaults", exc)
    settings = dict(_RCT_DEFAULTS)
    _save_rct_settings(settings)
    log.info("RCT settings created at %s", RCT_SETTINGS_PATH)
    return settings


def _save_rct_settings(settings: dict) -> None:
    """Write RCT settings dict to JSON (creates parent dir if needed)."""
    os.makedirs(os.path.dirname(RCT_SETTINGS_PATH), exist_ok=True)
    with open(RCT_SETTINGS_PATH, "w") as fh:
        json.dump(settings, fh, indent=2)
    log.info("RCT settings saved to %s", RCT_SETTINGS_PATH)


def push_rct_settings_to_nano(nano: "serial.Serial", settings: dict) -> None:
    """Send all 7 RCT settings to the Nano as individual frames.

    Frame encoding: CODE=RCT_SETTING_CODE, uint16 = (index << 8) | uint8_value.
    Production motor_simple.ino ignores these frames silently.
    """
    for idx, key in enumerate(_RCT_KEYS):
        val = max(0, min(255, int(settings.get(key, _RCT_DEFAULTS[key]))))
        send_nano_frame(nano, RCT_SETTING_CODE, (idx << 8) | val)
    log.info("RCT settings pushed to Nano (%d frames)", len(_RCT_KEYS))


# ===========================================================================
# Pilot settings helpers
# ===========================================================================

def load_pilot_settings() -> dict:
    """Return pilot settings from file, merged over built-in defaults."""
    s = copy.deepcopy(_DEFAULT_PILOT_SETTINGS)
    if os.path.isfile(PILOT_SETTINGS_PATH):
        try:
            with open(PILOT_SETTINGS_PATH) as fh:
                saved = json.load(fh)
            for sec, vals in saved.items():
                if isinstance(s.get(sec), dict) and isinstance(vals, dict):
                    s[sec].update(vals)
                else:
                    s[sec] = vals
        except Exception as exc:
            log.warning("Pilot settings load failed (%s) — using defaults", exc)

    # B52 one-shot migration (Fix #3a): pre-B52 stored port_pct as the *lower*
    # bound and stbd_pct as the *upper* bound. The convention has flipped so
    # port_pct is now the upper bound. Detect the old layout by port < stbd
    # and swap+complement so the user's intent (limit fraction of full throw)
    # is preserved.
    ap = s.get("autopilot", {})
    try:
        port_v = float(ap.get("rudder_limit_port_pct", 100))
        stbd_v = float(ap.get("rudder_limit_stbd_pct", 0))
        if port_v < stbd_v:
            ap["rudder_limit_port_pct"] = int(round(100 - port_v))
            ap["rudder_limit_stbd_pct"] = int(round(100 - stbd_v))
            log.info("B52 migration: rudder limits flipped to canonical "
                     "convention (port=%s, stbd=%s)",
                     ap["rudder_limit_port_pct"], ap["rudder_limit_stbd_pct"])
    except Exception:
        pass

    return s


def _persist_pilot_settings(settings: dict) -> None:
    """Write pilot settings to file, creating parent dirs if needed."""
    try:
        os.makedirs(os.path.dirname(PILOT_SETTINGS_PATH), exist_ok=True)
        with open(PILOT_SETTINGS_PATH, "w") as fh:
            json.dump(settings, fh, indent=2)
        log.info("Pilot settings saved \u2192 %s", PILOT_SETTINGS_PATH)
    except Exception as exc:
        log.error("Pilot settings save failed: %s", exc)


def send_features_to_nano(nano: serial.Serial, settings: dict) -> None:
    """Build feature bitmask from pilot settings and send FEATURES_CODE to Nano.

    Called at startup (after the 1-second Nano settle delay) and on every
    SETTINGS SET command so the Nano immediately reflects the new feature config.
    """
    feats = settings.get("features", {})
    mask: int = 0
    if feats.get("limit_switches",         False): mask |= FEATURE_LIMIT_SWITCHES
    if feats.get("temp_sensor",            False): mask |= FEATURE_TEMP_SENSOR
    if feats.get("pi_voltage_sensor",      False): mask |= FEATURE_PI_VOLTAGE
    if feats.get("battery_voltage_sensor", False): mask |= FEATURE_BATTERY_VOLTAGE
    if feats.get("current_sensor",         False): mask |= FEATURE_CURRENT_SENSOR
    if feats.get("on_board_buttons",       False): mask |= FEATURE_ON_BOARD_BUTTONS
    if feats.get("oled_sh1106",            False): mask |= FEATURE_OLED_SH1106
    if feats.get("invert_clutch",          False): mask |= FEATURE_INVERT_CLUTCH
    send_nano_frame(nano, FEATURES_CODE, mask)
    log.info(
        "Features -> Nano: 0x%02X  (limit=%s temp=%s pi_v=%s bat_v=%s curr=%s btn=%s sh1106=%s inv_clutch=%s)",
        mask,
        bool(mask & FEATURE_LIMIT_SWITCHES),
        bool(mask & FEATURE_TEMP_SENSOR),
        bool(mask & FEATURE_PI_VOLTAGE),
        bool(mask & FEATURE_BATTERY_VOLTAGE),
        bool(mask & FEATURE_CURRENT_SENSOR),
        bool(mask & FEATURE_ON_BOARD_BUTTONS),
        bool(mask & FEATURE_OLED_SH1106),
        bool(mask & FEATURE_INVERT_CLUTCH),
    )


def _ip_to_bytes(ip_str: str) -> bytes:
    """Convert dotted-quad IP string to 4 bytes; returns 4 zero bytes on error."""
    if not ip_str:
        return b"\x00\x00\x00\x00"
    try:
        parts = [int(p) & 0xFF for p in ip_str.split(".")]
        return bytes(parts[:4]).ljust(4, b"\x00")
    except (ValueError, AttributeError):
        return b"\x00\x00\x00\x00"


def _build_features_mask(settings: dict) -> int:
    """Build the feature bitmask from pilot settings (shared logic)."""
    feats = settings.get("features", {})
    mask = 0
    if feats.get("limit_switches",         False): mask |= FEATURE_LIMIT_SWITCHES
    if feats.get("temp_sensor",            False): mask |= FEATURE_TEMP_SENSOR
    if feats.get("pi_voltage_sensor",      False): mask |= FEATURE_PI_VOLTAGE
    if feats.get("battery_voltage_sensor", False): mask |= FEATURE_BATTERY_VOLTAGE
    if feats.get("current_sensor",         False): mask |= FEATURE_CURRENT_SENSOR
    if feats.get("on_board_buttons",       False): mask |= FEATURE_ON_BOARD_BUTTONS
    if feats.get("oled_sh1106",            False): mask |= FEATURE_OLED_SH1106
    if feats.get("invert_clutch",          False): mask |= FEATURE_INVERT_CLUTCH
    return mask


def _build_features2_mask(settings: dict) -> int:
    """Build the second feature bitmask (EEPROM offset 23, layout v2).

    Not sent via FEATURES_CODE; persisted to EEPROM only.
    Extend this function when additional bits are needed beyond FEATURE2_INVERT_MOTOR.
    """
    feats = settings.get("features", {})
    mask = 0
    if feats.get("invert_motor", False): mask |= FEATURE2_INVERT_MOTOR
    return mask


def _serialize_settings(pilot: dict, rct: dict) -> bytes:
    """Serialize all settings into the EEPROM binary layout.

    Returns the complete block including magic, version, payload, and CRC8.
    """
    buf = bytearray()

    # Header (offsets 0-2)
    buf.append(EEPROM_MAGIC1)
    buf.append(EEPROM_MAGIC2)
    buf.append(EEPROM_LAYOUT_VERSION)

    # Feature flags bitmask (offset 3)
    buf.append(_build_features_mask(pilot))

    # RCT settings — 7 x uint8 (offsets 4-10)
    for key in _RCT_KEYS:
        val = max(0, min(255, int(rct.get(key, _RCT_DEFAULTS[key]))))
        buf.append(val)

    # Vessel (offsets 11-12)
    vessel = pilot.get("vessel", {})
    buf.append(0 if vessel.get("type", "sail") == "sail" else 1)
    buf.append(max(10, min(100, int(vessel.get("rudder_range_deg", 35)))))

    # Autopilot (offsets 13-19)
    ap = pilot.get("autopilot", {})
    db10 = max(0, min(65535, int(round(float(ap.get("deadband_pct", 3.0)) * 10))))
    buf.extend(db10.to_bytes(2, "little"))
    pg10 = max(0, min(65535, int(round(float(ap.get("pgain", 1.0)) * 10))))
    buf.extend(pg10.to_bytes(2, "little"))
    buf.append(max(0, min(255, int(ap.get("off_course_alarm_deg", 20)))))
    buf.append(max(0, min(255, int(ap.get("rudder_limit_port_pct", 100)))))
    buf.append(max(0, min(255, int(ap.get("rudder_limit_stbd_pct", 0)))))

    # Safety (offsets 20-22)
    safety = pilot.get("safety", {})
    safety_flags = 0x01 if safety.get("auto_disengage_on_fault", True) else 0x00
    buf.append(safety_flags)
    buf.append(max(0, min(255, int(safety.get("comms_warn_threshold_pct", 10)))))
    buf.append(max(0, min(255, int(safety.get("comms_crit_threshold_pct", 25)))))

    # Second feature-flags byte (offset 23, layout v2)
    buf.append(_build_features2_mask(pilot))

    # Network (offsets 24-44)
    net = pilot.get("network", {})
    buf.append(0 if net.get("ip_mode", "dhcp") == "dhcp" else 1)
    buf.extend(_ip_to_bytes(net.get("ip", "")))
    buf.extend(_ip_to_bytes(net.get("mask", "255.255.255.0")))
    buf.extend(_ip_to_bytes(net.get("gateway", "")))
    buf.extend(_ip_to_bytes(net.get("dns1", "8.8.8.8")))
    buf.extend(_ip_to_bytes(net.get("dns2", "8.8.4.4")))

    # Variable-length strings: SSID, WiFi key, vessel name
    wifi = pilot.get("wifi", {})
    for s, maxlen in [
        (wifi.get("ssid", ""), 32),
        (wifi.get("key", ""), 63),
        (vessel.get("name", ""), 32),
    ]:
        raw = s.encode("utf-8", errors="replace")[:maxlen]
        buf.append(len(raw))
        buf.extend(raw)

    # CRC8 over the entire payload (same algo as frame CRC)
    crc = crc8_msb(bytes(buf))
    buf.append(crc)

    return bytes(buf)


def push_all_settings_to_nano_eeprom(
    nano: serial.Serial, pilot: dict, rct: dict
) -> None:
    """Serialize all settings and write to Nano EEPROM byte by byte."""
    blob = _serialize_settings(pilot, rct)
    for addr, byte_val in enumerate(blob):
        send_nano_frame(nano, BRIDGE_SETTINGS_WRITE_CODE, (addr << 8) | byte_val)
    nano.flush()       # wait for OS buffer to drain to USB-serial chip
    time.sleep(0.5)    # allow CH340 to finish UART transmission
    log.info("EEPROM settings pushed to Nano (%d bytes, %d frames)", len(blob), len(blob))


def reboot_nano(nano: serial.Serial) -> None:
    """Reboot the Nano via DTR pulse (same as startup cold-boot fix)."""
    nano.dtr = True
    time.sleep(0.15)
    nano.dtr = False
    log.info("DTR reset pulse sent — Nano rebooting")


def _apply_pilot_settings(settings: dict, nano: "serial.Serial | None" = None) -> None:
    """Apply settings that the bridge uses at runtime.

    Called once at startup (nano=None, features sent separately after settle delay)
    and on every SETTINGS SET command (nano provided, features sent immediately).
    """
    db = settings.get("autopilot", {}).get("deadband_pct", 3.0)
    log.debug("Pilot settings applied: deadband=%.1f%%", db)
    if nano is not None:
        send_features_to_nano(nano, settings)


# ===========================================================================
# TCP server helpers
# ===========================================================================

def setup_ota_http_server() -> None:
    """Start a minimal HTTP file server in a daemon thread.

    Serves GET /inno_remote.bin from OTA_FIRMWARE_DIR on OTA_HTTP_PORT.
    Returns 404 if the file is not present (safe to call before binary is deployed).
    The server runs for the lifetime of the process.
    """
    import http.server
    import urllib.parse

    class _OTAHandler(http.server.BaseHTTPRequestHandler):
        def do_GET(self):
            requested = urllib.parse.unquote(self.path.lstrip("/"))
            if requested != OTA_FIRMWARE_FILE:
                self.send_error(404)
                return
            try:
                with open(OTA_FIRMWARE_PATH, "rb") as fh:
                    data = fh.read()
            except OSError:
                self.send_error(404)
                return
            self.send_response(200)
            self.send_header("Content-Type", "application/octet-stream")
            self.send_header("Content-Length", str(len(data)))
            self.end_headers()
            self.wfile.write(data)
            log.info("OTA: served %d bytes to %s", len(data), self.client_address[0])

        def log_message(self, fmt, *args):  # suppress default access-log noise
            pass

    class _OTAServer(http.server.HTTPServer):
        allow_reuse_address = True

    def _serve():
        srv = _OTAServer(("", OTA_HTTP_PORT), _OTAHandler)
        log.info("OTA HTTP server listening on port %d (firmware: %s)",
                 OTA_HTTP_PORT, OTA_FIRMWARE_PATH)
        srv.serve_forever()

    t = threading.Thread(target=_serve, daemon=True, name="ota-http")
    t.start()


def setup_tcp_server() -> socket.socket:
    srv = socket.socket(socket.AF_INET, socket.SOCK_STREAM)
    srv.setsockopt(socket.SOL_SOCKET, socket.SO_REUSEADDR, 1)
    srv.bind(("", REMOTE_TCP_PORT))
    srv.listen(8)
    srv.setblocking(False)
    log.info("TCP remote server listening on port %d", REMOTE_TCP_PORT)
    return srv


def remote_send(sock: socket.socket, line: str) -> bool:
    """Send a text line to the remote.  Returns False if the send failed."""
    try:
        sock.sendall((line + "\n").encode())
        return True
    except OSError:
        return False


def remote_send_many(remote_clients: dict, line: str) -> list[socket.socket]:
    """Send one line to all connected remotes, returning sockets that failed."""
    failed: list[socket.socket] = []
    for sock in list(remote_clients.keys()):
        if not remote_send(sock, line):
            failed.append(sock)
    return failed


def close_remote(sock: socket.socket) -> None:
    try:
        sock.close()
    except OSError:
        pass


# ===========================================================================
# Remote disconnect handler
# ===========================================================================

def handle_remote_disconnect(
    nano: serial.Serial,
    bstate: BridgeState,
    set_q: "queue.Queue[tuple]",
    pstate: PypilotState,
    plock: threading.Lock,
) -> None:
    """
    Called whenever the remote TCP connection drops (timeout, peer-closed, error).
    If the remote was in MANUAL mode this is a steering-loss event: force the
    Nano out of manual mode, trigger the Nano steer-loss alarm, disengage AP.
    """
    if bstate.mode == MODE_MANUAL:
        remote_steer_loss(nano, bstate, set_q, pstate, plock, "remote disconnected")
    elif ram_active(bstate):
        # No remote left means nobody can be holding the dead-man button.
        ram_test_abort(nano, bstate, "remote disconnected")


def raise_alert(bstate: BridgeState, code: str) -> None:
    """Raise a skipper alert (ALERT_*); telemetry carries it as "WARN <code>"."""
    bstate.alert = code
    bstate.alert_at = time.monotonic()


def remote_steer_loss(
    nano: serial.Serial,
    bstate: BridgeState,
    set_q: "queue.Queue[tuple]",
    pstate: PypilotState,
    plock: threading.Lock,
    reason: str,
) -> None:
    """REMOTE steering lost its operator (TCP drop or missing ALIVE heartbeat).

    Force the Nano out of REMOTE (motor stops, clutch drops — the rudder is left
    where it is; never auto-centre), sound the Nano steer-loss alarm, make sure
    the AP is off, and raise the skipper alert.
    """
    send_nano_frame(nano, MANUAL_MODE_CODE, 0)          # exit manual on Nano
    send_nano_frame(nano, WARNING_CODE, WARN_STEER_LOSS) # trigger Nano alarm
    set_q.put(("ap.enabled", False))
    with plock:
        pstate.ap_enabled = False
    bstate.mode = MODE_IDLE
    bstate.manual_hb_seen = False
    raise_alert(bstate, ALERT_STEER_LOSS)
    log.warning("REMOTE steering lost (%s) — STEER LOSS triggered, mode -> IDLE", reason)


def nudge_stop(nano: serial.Serial, bstate: BridgeState, reason: str) -> None:
    """End an active nudge.  From IDLE the Nano gets DISENGAGE (clutch drops);
    from AP the pypilot relay simply resumes.  No-op when no nudge is running."""
    if bstate.nudge_until <= 0.0:
        return
    if bstate.nudge_was_idle:
        send_nano_frame(nano, PYPILOT_DISENGAGE_CODE, 0)
        log.info("%s: nudge stopped (mode was IDLE — sent DISENGAGE to Nano)", reason)
    else:
        log.info("%s: nudge stopped (mode was AP — pypilot relay resumed)", reason)
    bstate.nudge_until = 0.0


def ap_failsafe_stop(
    nano: serial.Serial,
    bstate: BridgeState,
    set_q: "queue.Queue[tuple]",
    pstate: PypilotState,
    plock: threading.Lock,
    reason: str,
) -> None:
    """The bridge stops the AP because pypilot is gone or silent while engaged.

    DISENGAGE to the Nano at once, tell pypilot (queued if it is unreachable),
    alert the skipper, and block pypilot COMMAND frames until pypilot itself
    disengages or the skipper engages again (pp_cmd_block: no surprise re-engage).
    """
    nudge_stop(nano, bstate, reason)
    send_nano_frame(nano, PYPILOT_DISENGAGE_CODE, 0)
    set_q.put(("ap.enabled", False))   # delivered when pypilot is back
    with plock:
        pstate.ap_enabled = False
    bstate.mode = MODE_IDLE
    bstate.pp_cmd_block = True
    raise_alert(bstate, ALERT_AP_LOST)
    log.warning("AP stopped by failsafe (%s) — DISENGAGE sent, mode -> IDLE", reason)


# ===========================================================================
# Rudder limits: "no rudder motion before limits are set"
# ===========================================================================

def load_rudder_limits() -> dict:
    """Read RUDDER_LIMITS_PATH; {} when missing or unreadable (= limits not set)."""
    try:
        with open(RUDDER_LIMITS_PATH) as fh:
            data = json.load(fh)
        return data if isinstance(data, dict) else {}
    except FileNotFoundError:
        return {}
    except Exception as exc:
        log.warning("Rudder limits file unreadable (%s) — treating limits as NOT set", exc)
        return {}


def save_rudder_limits(data: dict) -> None:
    """Write RUDDER_LIMITS_PATH atomically (temp file + rename), so a power cut
    mid-write can never leave a half-written file that parses as 'set'."""
    os.makedirs(os.path.dirname(RUDDER_LIMITS_PATH), exist_ok=True)
    tmp = RUDDER_LIMITS_PATH + ".tmp"
    with open(tmp, "w") as fh:
        json.dump(data, fh, indent=2)
        fh.flush()
        os.fsync(fh.fileno())
    os.replace(tmp, RUDDER_LIMITS_PATH)
    log.info("Rudder limits saved -> %s", RUDDER_LIMITS_PATH)


def cal_snapshot(scale: Optional[float], offset: Optional[float],
                 nonlin: Optional[float], rng: Optional[float]) -> Optional[dict]:
    """pypilot's rudder calibration as a dict, or None while any value is unknown."""
    if None in (scale, offset, nonlin, rng):
        return None
    return {"scale": float(scale), "offset": float(offset),
            "nonlinearity": float(nonlin), "range": float(rng)}


def cal_problem(cal: dict) -> Optional[str]:
    """Plain-words reason why a calibration is unusable for limits, or None.

    pypilot: angle = scale*u + offset + nl*(m0-u)*(m1-u), u = raw in -0.5..0.5,
    m0/m1 = raw at -range/+range.  Checks the stops are inside the sensor's
    span, far enough apart, and that the curve is monotonic between them
    (slope at each stop keeps the sign of scale and at least half its size).
    """
    scale, offset, nl, rng = cal["scale"], cal["offset"], cal["nonlinearity"], cal["range"]
    if abs(scale) < 1.0:
        return "rudder sensor calibration is missing or flat"
    m0, m1 = (-rng - offset) / scale, (rng - offset) / scale
    if max(abs(m0), abs(m1)) > 0.5:
        return "a stop lies outside the rudder sensor's range"
    if abs(m1 - m0) < 0.02:
        return "the rudder sensor barely changes between the stops"
    if abs(nl * (m1 - m0)) > 0.5 * abs(scale):
        return "centre is too far off the middle between the stops (curve not usable)"
    return None


def limits_check(lim: dict, cal: Optional[dict]) -> tuple:
    """(ok, reason): are the stored limits valid for the current calibration?"""
    if not lim.get("set"):
        return False, "rudder limits have not been set"
    if cal is None:
        return False, "waiting for the rudder calibration from pypilot"
    stored = lim.get("cal") or {}
    for key, tol in LIMITS_CAL_TOL.items():
        try:
            if abs(float(stored[key]) - cal[key]) > tol:
                return False, "rudder calibration changed since the limits were set"
        except (KeyError, TypeError, ValueError):
            return False, "stored rudder limits are incomplete"
    return True, "ok"


def limits_refuse(bstate: BridgeState, what: str) -> bool:
    """True (and alert the skipper) if rudder motion `what` must be refused."""
    if bstate.limits_ok:
        return False
    raise_alert(bstate, ALERT_LIMITS_UNSET)
    log.warning("%s refused: %s — run the Dock-Side Wizard", what, bstate.limits_reason)
    return True


def limits_status_json(bstate: BridgeState) -> str:
    """Status line body for the Dock-Side Wizard page (telemetry LIMITS <json>)."""
    lim = bstate.rudder_limits
    cal = bstate.last_cal
    return json.dumps({
        "ok": bstate.limits_ok,
        "reason": bstate.limits_reason,
        "set": bool(lim.get("set")),
        "port_deg": lim.get("port_limit_deg"),
        "stbd_deg": lim.get("stbd_limit_deg"),
        "range": cal["range"] if cal else None,
        "cal_problem": cal_problem(cal) if cal else None,
        "capturing": bstate.lim_cap_point,
        "done": sorted(bstate.lim_cap_done),
        "msg": bstate.lim_msg,
        "margin": LIMITS_MARGIN_DEFAULT_DEG,
    }, separators=(",", ":"))


def limits_capture_service(bstate: BridgeState, set_q: "queue.Queue[tuple]",
                           rudder_angle: Optional[float], pp_connected: bool,
                           now: float) -> None:
    """Run a pending LIMITS CAPTURE: watch the rudder for LIMITS_CAP_SAMPLE_S and,
    if it stayed still, hand the point to pypilot's calibration (rudder.py
    snapshots its raw sensor value for the declared angle 0/+range/-range)."""
    point = bstate.lim_cap_point
    if point is None:
        return
    if (bstate.mode != MODE_IDLE or bstate.nudge_until > 0.0 or
            not pp_connected or rudder_angle is None):
        bstate.lim_cap_point = None
        bstate.lim_msg = "Capture of %s cancelled (steering started or rudder reading lost)" % point
        log.warning("LIMITS CAPTURE %s cancelled", point)
        return
    bstate.lim_cap_min = min(bstate.lim_cap_min, rudder_angle)
    bstate.lim_cap_max = max(bstate.lim_cap_max, rudder_angle)
    if now - bstate.lim_cap_t0 < LIMITS_CAP_SAMPLE_S:
        return
    bstate.lim_cap_point = None
    spread = bstate.lim_cap_max - bstate.lim_cap_min
    if spread > LIMITS_CAP_STILL_DEG:
        bstate.lim_msg = ("%s not captured: the rudder moved %.1f° — hold it still and try again"
                          % (point, spread))
        log.warning("LIMITS CAPTURE %s rejected: moved %.2f deg", point, spread)
        return
    set_q.put(("rudder.calibration_state", LIMITS_CAP_POINTS[point]))
    bstate.lim_cap_done[point] = time.strftime("%Y-%m-%dT%H:%M:%S%z")
    bstate.lim_cap_last = now
    bstate.lim_msg = "%s captured" % point
    log.info("LIMITS CAPTURE %s -> pypilot calibration_state '%s' (still within %.2f deg)",
             point, LIMITS_CAP_POINTS[point], spread)


def limits_stop_motion(nano: serial.Serial, bstate: BridgeState,
                       set_q: "queue.Queue[tuple]", pstate: PypilotState,
                       plock: threading.Lock) -> None:
    """Limits became invalid: stop whatever is moving the rudder (each stop
    through its own normal exit path).  Never auto-centres."""
    why = "rudder limits not valid (%s)" % bstate.limits_reason
    stopped = False
    if ram_active(bstate):
        ram_test_abort(nano, bstate, why)
        stopped = True
    if bstate.nudge_until > 0.0:
        nudge_stop(nano, bstate, why)
        stopped = True
    if bstate.mode == MODE_MANUAL:
        send_nano_frame(nano, MANUAL_MODE_CODE, 0)    # motor stops, clutch drops
        bstate.mode = MODE_IDLE
        bstate.manual_hb_seen = False
        stopped = True
    if bstate.mode == MODE_AP:
        send_nano_frame(nano, PYPILOT_DISENGAGE_CODE, 0)
        set_q.put(("ap.enabled", False))
        with plock:
            pstate.ap_enabled = False
        bstate.mode = MODE_IDLE
        stopped = True
    if stopped:
        raise_alert(bstate, ALERT_LIMITS_UNSET)
        log.warning("Steering stopped: %s", why)


# ===========================================================================
# Nano local calibrated rudder angle ("B")
# ===========================================================================

def rudder_cal_coeffs(scale: float, offset: float, nonlin: float,
                      rng: float) -> Optional[tuple]:
    """pypilot's rudder calibration as a quadratic for the Nano, or None.

    pypilot (arduino_servo.cpp + rudder.py), with value = adc*64 from the Nano:
        u     = value/65472 - 0.5 = adc/1023 - 0.5
        m0,m1 = (-range - offset)/scale, (range - offset)/scale
        angle = scale*u + offset + nonlin*(m0 - u)*(m1 - u)      (+ = port)
    Expanded: angle = nl*u^2 + (scale - nl*(m0+m1))*u + (offset + nl*m0*m1).
    The Nano's axis is -angle in tenths (PILOT_RUDDER_CODE convention), so every
    coefficient is multiplied by -10.  Returns (k2, k1, k0) for
    local_deg10 = (k2*u + k1)*u + k0.
    """
    if scale is None or offset is None or nonlin is None or not rng:
        return None
    if abs(scale) <= 0.01:          # pypilot's own "bad calibration" threshold
        return None
    rng = abs(float(rng))
    m0 = (-rng - offset) / scale
    m1 = (rng - offset) / scale
    a2 = nonlin
    a1 = scale - nonlin * (m0 + m1)
    a0 = offset + nonlin * m0 * m1
    return (-10.0 * a2, -10.0 * a1, -10.0 * a0)


def rcal_words(coeffs: tuple) -> tuple:
    """Six uint16 words (LO, HI per float32, little-endian) for the RCAL frames."""
    words = []
    for k in coeffs:
        lo, hi = struct.unpack("<HH", struct.pack("<f", float(k)))
        words += [lo, hi]
    return tuple(words)


def send_rudder_cal(nano: "serial.Serial", words: tuple) -> None:
    """Send the six coefficient words, then COMMIT with their uint16 sum."""
    codes = (RCAL_K2_LO_CODE, RCAL_K2_HI_CODE, RCAL_K1_LO_CODE,
             RCAL_K1_HI_CODE, RCAL_K0_LO_CODE, RCAL_K0_HI_CODE)
    for code, w in zip(codes, words):
        send_nano_frame(nano, code, w)
    send_nano_frame(nano, RCAL_COMMIT_CODE, sum(words) & 0xFFFF)


# ===========================================================================
# RAM commissioning sweep helpers (see the RAM_* constants for the rules)
# ===========================================================================

def ram_active(bstate: BridgeState) -> bool:
    """True while the RAM sweep is armed (RAM_OFF) or running (RAM_ON)."""
    return bstate.mode in (MODE_RAM_OFF, MODE_RAM_ON)


def ram_nano_deadband_deg(rng: float) -> float:
    """The Nano's remote-manual position deadband in degrees.

    Mirrors motor_simple.ino: REMOTE_DEADBAND = span_deg10 * g_deadband / 1000
    with span = 2*range and g_deadband = deadband_pct*10, floored at 0.8 deg.
    The Nano stops ANYWHERE inside this band of the target.
    """
    pct = float(_pilot_settings.get("autopilot", {}).get("deadband_pct", 3.0))
    return max(0.8, 2.0 * rng * pct / 100.0)


def remote_start_band_pct(rng: float) -> float:
    """The Nano's REMOTE start threshold as a percentage of the full span.

    Mirrors motor_simple.ino v3.3.2 anti-chatter rule 1: a settled rudder only
    starts moving once the error exceeds 1.5 x the deadband (rm_start_db); a run
    stops at the deadband.  Same units as RDR_PCT / the RUD target (0-100).
    """
    return 1.5 * ram_nano_deadband_deg(rng) / (2.0 * rng) * 100.0


def ram_send_target(nano: serial.Serial, bstate: BridgeState) -> None:
    """Send the current stroke's end target to the Nano (re-asserting MANUAL).

    MANUAL is re-asserted every time because any stray COMMAND_CODE that reaches
    the Nano (race/boot) sets ap_enabled_remote=true; this clears it within 200 ms.
    """
    st = bstate.ram_stroke
    if st is None:
        return
    rng = bstate.ram_rng
    # Convention: pct=100=port, pct=0=stbd. pypilot angle positive=port.
    target_pct = (rng + st.target_deg) / (2.0 * rng) * 100.0
    target_pct = max(0.0, min(100.0, target_pct))
    target_0_1000 = int(round(target_pct * 10.0))
    send_nano_frame(nano, MANUAL_MODE_CODE, 1)
    send_nano_frame(nano, MANUAL_RUD_TARGET_CODE, target_0_1000)
    bstate.rct_target = target_0_1000


def ram_stroke_begin(nano: serial.Serial, bstate: BridgeState, now: float,
                     rudder_angle: float, direction: int, full: bool) -> None:
    """Start a new stroke toward ``direction`` and send its target immediately
    (immediately, not at the next 5 Hz tick, so the measured lag is real)."""
    deg = float(bstate.ram_test_deg)
    bstate.ram_test_direction = direction
    bstate.ram_stroke = RamStroke(
        direction=direction, target_deg=-direction * deg,
        start_t=now, start_angle=rudder_angle, full=full)
    ram_send_target(nano, bstate)


def _mean(xs: list) -> Optional[float]:
    return sum(xs) / len(xs) if xs else None


def _rnd(x: Optional[float], nd: int = 1) -> Optional[float]:
    return None if x is None else round(x, nd)


def ram_stroke_speed(st: RamStroke) -> Optional[float]:
    """Speed (deg/s) over the central RAM_SPEED_WINDOW_FRAC of the distance the
    stroke actually travelled, from the recorded (t, progress) samples.

    Uses the real travel, not the commanded +/-N deg, because the Nano stops
    anywhere inside its deadband and the stroke may end well short of target.
    """
    if len(st.samples) < 3:
        return None
    p0 = st.samples[0][1]
    travel = st.peak - p0
    if travel < 3.0:
        return None
    edge = (1.0 - RAM_SPEED_WINDOW_FRAC) / 2.0
    lo, hi = p0 + edge * travel, p0 + (1.0 - edge) * travel
    t_lo = next((t for t, p in st.samples if p >= lo), None)
    t_hi = next((t for t, p in st.samples if p >= hi), None)
    if t_lo is None or t_hi is None or t_hi <= t_lo:
        return None
    return (hi - lo) / (t_hi - t_lo)


def ram_stroke_lag(st: RamStroke) -> Optional[float]:
    """Reversal lag (s): target sent -> rudder actually starts moving.

    Time to the first RAM_LAG_MOVE_DEG of movement, minus the time that
    distance itself takes at the LOCAL speed just after it (between 0.5 and
    1.5 deg of progress).  The local speed matters: right after a reversal the
    Nano is at full power, while the stroke's average may be slow-zone speed.
    """
    if st.move_t is None or not st.samples:
        return None
    p0 = st.samples[0][1]
    t_a = next((t for t, p in st.samples if p - p0 >= RAM_LAG_MOVE_DEG), None)
    t_b = next((t for t, p in st.samples if p - p0 >= RAM_LAG_MOVE_DEG + 1.0), None)
    raw = st.move_t - st.start_t
    if t_a is None or t_b is None or t_b <= t_a:
        return raw                      # no local speed: report uncorrected
    v_local = 1.0 / (t_b - t_a)
    return max(0.0, raw - RAM_LAG_MOVE_DEG / v_local)


def ram_summary(bstate: BridgeState, reason: str, completed: bool) -> dict:
    """Build the RAM_RESULT summary from the finished full strokes."""
    full = [r for r in bstate.ram_results if r.full]
    deg = float(bstate.ram_test_deg)
    dirs = {}
    for key, d in (("port", -1), ("stbd", 1)):
        rs = [r for r in full if r.direction == d]
        speeds = [r.speed_dps for r in rs if r.speed_dps]
        # Overshoot: how far past the end target the rudder went (deg, >= 0).
        overs = [max(0.0, r.peak - deg) for r in rs]
        # End error: settled position vs target (+ = past target, - = short).
        errs = [(-r.direction * r.settled) - deg for r in rs if r.settled is not None]
        ipk = [r.i_peak for r in rs if r.i_peak is not None]
        imn = [r.i_sum / r.i_n for r in rs if r.i_n]
        spd = _mean(speeds)
        lags = [r.lag_s * 1000.0 for r in rs if r.lag_s is not None]
        dirs[key] = {
            "n": len(rs),
            "speed_dps": _rnd(spd),
            # Extrapolated full hard-over to hard-over time at the measured speed.
            "hard_over_s": _rnd(2.0 * bstate.ram_rng / spd) if spd else None,
            "lag_ms": None if not lags else int(round(_mean(lags))),
            "overshoot_max_deg": _rnd(max(overs)) if overs else None,
            "end_err_deg": _rnd(_mean(errs)),
            "settle_timeouts": sum(1 for r in rs if r.settle_timeout),
            "i_peak_a": _rnd(max(ipk), 2) if ipk else None,
            "i_mean_a": _rnd(_mean(imn), 2) if imn else None,
        }
    sp, ss = dirs["port"]["speed_dps"], dirs["stbd"]["speed_dps"]
    asym = (abs(sp - ss) / ((sp + ss) / 2.0) * 100.0) if sp and ss else None
    if completed:
        clean = all(v["settle_timeouts"] == 0 for v in dirs.values())
        result = "PASS" if clean else "CHECK"
    else:
        result = "STOPPED"
    return {
        "result": result, "reason": reason,
        "deg": bstate.ram_test_deg, "range_deg": _rnd(bstate.ram_rng),
        "cycles_req": bstate.ram_cycles,
        "strokes": len(full), "strokes_req": 2 * bstate.ram_cycles,
        "speed_asym_pct": _rnd(asym), "dirs": dirs,
        # Context the numbers depend on: the Nano stops anywhere within
        # nano_deadband_deg of the target (shows up as end error).
        # (Until 2026-10-02 the Nano also dropped to PWM 160 within 4x the
        # deadband and the summary flagged speeds timed at reduced power; the
        # Nano now drives at full duty throughout, so that flag was removed.)
        "nano_deadband_deg": _rnd(bstate.ram_db_deg),
        # Which angle the Nano steered on: "local" = its own fresh calibrated
        # angle (B), "pypilot" = the ~0.3 s-stale relayed angle.  Note the
        # bridge still MEASURES with pypilot's angle, so lag_ms includes
        # pypilot's ~0.2 s conversion delay either way.
        "nano_angle": {1: "local", 2: "pypilot (local rejected)"}.get(
            bstate.rcal_status, "pypilot"),
    }


def ram_test_abort(nano: serial.Serial, bstate: BridgeState, reason: str,
                   completed: bool = False) -> None:
    """The ONE exit path for the RAM sweep (armed or running).

    Stops the sweep, releases MANUAL on the Nano (motor stops, clutch released)
    and queues a RAM_RESULT summary for the remotes.  Deliberately does NOT
    drive the rudder back to centre: that would be motion with nobody holding
    the dead-man button.  Safe to call when the sweep is not active (no-op).
    """
    if not ram_active(bstate):
        return
    was_running = bstate.mode == MODE_RAM_ON
    bstate.ram_test_running = False
    bstate.ram_stroke = None
    send_nano_frame(nano, MANUAL_MODE_CODE, 0)
    bstate.mode = MODE_IDLE
    if not was_running:
        log.info("RAM sweep disarmed: %s", reason)
        bstate.ram_result_pending = json.dumps(
            {"result": "DISARMED", "reason": reason})
        return
    summary = ram_summary(bstate, reason, completed)
    (log.info if completed else log.warning)(
        "RAM sweep %s: %s — %s", summary["result"], reason, json.dumps(summary))
    bstate.ram_result_pending = json.dumps(summary)


def ram_service(nano: serial.Serial, bstate: BridgeState, now: float,
                rudder_angle: Optional[float], pp_connected: bool,
                current: Optional[float]) -> None:
    """Per-main-loop RAM sweep supervision and measurement.

    Runs every loop iteration (~10 ms) rather than at the 5 Hz telemetry tick so
    timings are limited by pypilot's rudder.angle rate, not by the tick.
    """
    if bstate.mode == MODE_RAM_OFF:
        if now - bstate.ram_armed_at > RAM_ARM_TIMEOUT_S:
            ram_test_abort(nano, bstate, f"not started within {RAM_ARM_TIMEOUT_S:.0f} s")
        return
    if bstate.mode != MODE_RAM_ON:
        return

    # ---- dead-man and data-validity watchdogs ----
    if now - bstate.ram_hold_last > RAM_HOLD_TIMEOUT_S:
        # Heartbeat stopped without a clean RELEASE: tab frozen/closed,
        # phone locked or WiFi dropped.
        ram_test_abort(nano, bstate, "hold signal lost (connection or app)")
        return
    if not pp_connected or rudder_angle is None:
        ram_test_abort(nano, bstate, "rudder angle unavailable")
        return
    st = bstate.ram_stroke
    if st is None:
        ram_test_abort(nano, bstate, "internal: no active stroke")
        return

    deg = float(bstate.ram_test_deg)
    sgn = -st.direction                 # +1 when the stroke increases the angle (port)
    prog = sgn * rudder_angle           # progress along the stroke; target at +deg

    # ---- measurements ----
    if st.move_t is None and sgn * (rudder_angle - st.start_angle) >= RAM_LAG_MOVE_DEG:
        st.move_t = now
    if st.full and (not st.samples or st.samples[-1][1] != prog):
        st.samples.append((now, prog))
    if st.phase == "drive" and current is not None:
        st.i_peak = current if st.i_peak is None else max(st.i_peak, current)
        st.i_sum += current
        st.i_n += 1

    # ---- phase machine ----
    if st.phase == "drive":
        # Jam check: needs RAM_JAM_MOVE_DEG of progress every RAM_JAM_S.
        if st.jam_ref is None or prog - st.jam_ref >= RAM_JAM_MOVE_DEG:
            st.jam_ref = prog
            st.jam_since = now
        elif now - st.jam_since >= RAM_JAM_S:
            ram_test_abort(nano, bstate,
                           f"rudder not moving (stuck at {rudder_angle:.1f}°, "
                           f"target {st.target_deg:+.0f}°)")
            return
        if prog >= deg - bstate.ram_reach_deg:
            st.phase = "settle"
            st.settle_t = st.still_since = now
            st.still_ref = rudder_angle
            st.peak = prog
        elif now - st.start_t > RAM_STROKE_TIMEOUT_S:
            ram_test_abort(nano, bstate,
                           f"end not reached within {RAM_STROKE_TIMEOUT_S:.0f} s "
                           f"(stopped at {rudder_angle:.1f}°)")
        return

    # settle: let the Nano finish braking/holding, record peak and final position
    st.peak = max(st.peak, prog)
    if abs(rudder_angle - st.still_ref) > RAM_SETTLE_STILL_DEG:
        st.still_ref = rudder_angle
        st.still_since = now
    still = (now - st.still_since) >= RAM_SETTLE_STILL_S
    timed_out = (now - st.settle_t) >= RAM_SETTLE_TIMEOUT_S
    if not (still or timed_out):
        return
    st.settled = rudder_angle
    st.settle_timeout = timed_out and not still
    st.speed_dps = ram_stroke_speed(st)
    st.lag_s = ram_stroke_lag(st)
    bstate.ram_results.append(st)
    done = sum(1 for r in bstate.ram_results if r.full)
    log.info("RAM stroke %s %s: lag=%s speed=%s peak=%.1f settled=%.1f%s",
             "full" if st.full else "approach",
             "->stbd" if st.direction == 1 else "->port",
             None if st.move_t is None else f"{(st.move_t - st.start_t) * 1000:.0f}ms",
             None if st.speed_dps is None else f"{st.speed_dps:.1f}deg/s",
             st.peak, rudder_angle, " SETTLE-TIMEOUT" if st.settle_timeout else "")
    if done >= 2 * bstate.ram_cycles:
        ram_test_abort(nano, bstate, f"{bstate.ram_cycles} cycle(s) complete", completed=True)
        return
    ram_stroke_begin(nano, bstate, now, rudder_angle, -st.direction, full=True)


# ===========================================================================
# Remote command parser
# ===========================================================================
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
