aviljoenn/inno-pilot/compute_module/glue/inno_web_remote.py

#!/usr/bin/env python3
"""

inno_web_remote.py — Browser-based Inno-Remote UI (port 8888).

Connects to inno-pilot-bridge on TCP port 8555 as a standard remote
client (same HELLO/PING/BTN/MODE/RUD protocol as the ESP32 handheld),
then serves a single-page web app over HTTP + Server-Sent Events.

No external dependencies — stdlib only.

Usage:
    python3 /usr/local/bin/inno_web_remote.py
    Open http://192.168.6.13:8888/ in a browser on the boat LAN.

Environment overrides:
    INNO_WEB_PORT     HTTP/SSE listen port (default: 8888)
    INNO_BRIDGE_HOST  Bridge host (default: 127.0.0.1)
    INNO_BRIDGE_PORT  Bridge TCP port (default: 8555)
"""

import json
import logging
import math
import os
import queue
import socket
import subprocess
import threading
import time
from http.server import BaseHTTPRequestHandler, ThreadingHTTPServer
from typing import Optional

logging.basicConfig(
    level=logging.INFO,
    format="%(asctime)s %(levelname)-5s %(message)s",
    datefmt="%H:%M:%S",
)
log = logging.getLogger("web-remote")

# ---------------------------------------------------------------------------
# Configuration
# ---------------------------------------------------------------------------
WEB_PORT          = int(os.getenv("INNO_WEB_PORT", "8888"))
BRIDGE_HOST       = os.getenv("INNO_BRIDGE_HOST", "127.0.0.1")
BRIDGE_PORT       = int(os.getenv("INNO_BRIDGE_PORT", "8555"))
PING_PERIOD_S     = 2.0
RECONNECT_DELAY_S = 1.0
# Multi-browser command arbitration has been removed: every connected
# browser is always allowed to issue commands.
# Sent in HELLO handshake.  Bridge logs mismatch but stays connected.
INNOPILOT_VERSION = "v3.3.2"   # release versions only, no "_Bxx" beta suffix (dropped at v3.0.1);
                               # MAJOR=hardware, MINOR=software feature, PATCH=fix — see CLAUDE.md "Version sync"

# Telegram notification config — JSON file with "token" and "chat_id" keys.
# If the file does not exist or is invalid, notifications are silently skipped.
TELEGRAM_CONF = "/home/innopilot/.pypilot/telegram.conf"

# ---------------------------------------------------------------------------
# Settings persistence — /var/lib/inno-pilot/settings.json
# ---------------------------------------------------------------------------
SETTINGS_FILE = "/var/lib/inno-pilot/settings.json"

# ---------------------------------------------------------------------------
# OTA update paths
# ---------------------------------------------------------------------------
REPO_DIR      = "/home/innopilot/inno-pilot"
DEPLOY_SCRIPT = "/home/innopilot/inno_deploy.sh"
OTA_LOG_FILE  = "/var/lib/inno-pilot/ota_log.txt"

_DEFAULT_SETTINGS: dict = {
    "network": {
        "ip_mode": "dhcp",          # "dhcp" or "static"
        "ip":      "",
        "mask":    "255.255.255.0",
        "gateway": "",
        "dns1":    "8.8.8.8",
        "dns2":    "8.8.4.4",
    },
    "wifi": {
        "ssid": "",
        "key":  "",
    },
    "vessel": {
        "name":             "",
        "type":             "sail",  # "sail" or "power"
        "rudder_range_deg": 35,      # full rudder throw each side (degrees)
    },
    "features": {
        "limit_switches":         False,
        "temp_sensor":            False,
        "pi_voltage_sensor":      False,
        "battery_voltage_sensor": False,
        "current_sensor":         False,
        "on_board_buttons":       False,
        "oled_sh1106":            False,
        "invert_clutch":          False,
        "invert_motor":           False,
        "remote_helm":            False,  # Enables REMOTE button on main screen; OFF by default
        # REMOTE helm wheel travel: on-screen wheel degrees each way for full rudder.
        # Smaller = less wheel turn per rudder degree (the deadband shows as less
        # "play"), coarser control.  Was hard-coded ±150 until v3.0.3.
        "helm_wheel_deg":         90,
    },
    "autopilot": {
        "deadband_pct":           3.0,
        "pgain":                  1.0,  # proportional heading gain
        "off_course_alarm_deg":   20,   # degrees off-course before alert
        # Convention: pct=100=full port, pct=0=full stbd. Therefore
        # rudder_limit_port_pct is the *upper* allowed pct (default 100=no limit)
        # and rudder_limit_stbd_pct is the *lower* allowed pct (default 0=no limit).
        "rudder_limit_port_pct":  100,  # software port stop (%) — upper bound
        "rudder_limit_stbd_pct":  0,    # software stbd stop (%) — lower bound
    },
    "safety": {
        "auto_disengage_on_fault":  True,
        "comms_warn_threshold_pct": 10,  # CRC error rate % for WARN
        "comms_crit_threshold_pct": 25,  # CRC error rate % for CRIT
    },
    "notifications": {
        # 0 = send one health report at boot only.
        # >0 = repeat every N minutes (stats accumulated over the period).
        "health_interval_min": 0,
        # Seconds between Pi->router pings (1-30, standard 1; Pi side forces 0.5 in Debug)
        "ping_interval_s": 1.0,
    },
}


def _load_settings() -> dict:
    """Return settings from file merged over built-in defaults."""
    import copy
    s = copy.deepcopy(_DEFAULT_SETTINGS)
    if os.path.exists(SETTINGS_FILE):
        try:
            with open(SETTINGS_FILE) as fh:
                saved = json.load(fh)
            for sec, vals in saved.items():
                if isinstance(s.get(sec), dict) and isinstance(vals, dict):
                    s[sec].update(vals)
                else:
                    s[sec] = vals
        except Exception as exc:
            log.warning("Settings load failed: %s", exc)
    return s


def _persist_settings(settings: dict) -> None:
    """Write settings dict to file, creating parent dirs if needed."""
    try:
        os.makedirs(os.path.dirname(SETTINGS_FILE), exist_ok=True)
        with open(SETTINGS_FILE, "w") as fh:
            json.dump(settings, fh, indent=2)
        log.info("Settings saved \u2192 %s", SETTINGS_FILE)
    except Exception as exc:
        log.error("Settings save failed: %s", exc)


# ---------------------------------------------------------------------------
# Shared state — written by bridge thread, read by HTTP handlers
# ---------------------------------------------------------------------------
_state: dict = {
    "connected":  False,
    "mode":       "IDLE",   # IDLE | AP | MANUAL  (from bridge MODE telemetry)
    "ap":         0,
    "hdg":        None,     # float degrees
    "cmd":        None,     # float degrees (AP heading command)
    "rdr":        None,     # float degrees (actual rudder angle from pypilot)
    "rdr_pct":    None,     # float 0–100  (actual rudder position %)
    "rdr_cmd":    0,        # int: pypilot servo command direction +1=port, 0=neutral, -1=stbd (conv 2)
    "db":         3.0,
    "comms":        "OK",     # OK | WARN | CRIT
    "warn":         None,
    "bridge_ver":   None,
    "version":      INNOPILOT_VERSION,
    "ui_mode":      "on",     # web remote selector state: auto | remote | on | off
    "rudder_stall": False,    # True when motor commanded but rudder not moving
    "pypilot_ok":   True,     # False when pypilot process has lost its connection
    "debug":        False,    # True when bridge is in DEBUG log level
    "net_pi":       None,     # Pi->router link from inno-health-notify: {state, loss_pct, avg_ms} or None
    "ram_prog":     None,     # RAM sweep progress "done/total" strokes while armed/running, else None
    "limits":       None,     # rudder limits status from the bridge (telemetry LIMITS <json>), or None
}
_state_lock = threading.Lock()

# When the selector last went to REMOTE (monotonic).  The bridge can end REMOTE on
# its own (steer loss: phone heartbeat lost); after this grace the selector follows
# the bridge instead of showing REMOTE with nobody steering (see MODE telemetry).
_ui_remote_since = 0.0
UI_REMOTE_GRACE_S = 2.0

# One queue per connected SSE browser, tracked with client id.
_sse_subs: list[dict] = []
_sse_lock  = threading.Lock()

# Commands flowing from browser → bridge
_cmd_q: "queue.Queue[str]" = queue.Queue(maxsize=200)

# Responses to SETTINGS GET / SETTINGS SET received from the bridge.
# HTTP handler drains this queue before issuing a request, then waits up to
# SETTINGS_TIMEOUT_S for the bridge to reply.  Maxsize=4 catches stale replies.
_settings_resp_q: "queue.Queue[Optional[dict]]" = queue.Queue(maxsize=4)
SETTINGS_TIMEOUT_S = 4.0

# When cleared, the bridge thread drops the TCP connection and stops reconnecting.
# When cleared, the bridge thread drops the TCP connection and stops reconnecting.
# Set by default (ON is the startup mode); cleared only when the user selects OFF.
_bridge_active = threading.Event()
_bridge_active.set()


def _send_telegram(text: str) -> None:
    """Fire-and-forget Telegram message.  Reads token/chat_id from TELEGRAM_CONF.
    Runs in a daemon thread so it never blocks the HTTP response path.
    Silently does nothing if the config file is absent or malformed.
    Prepends vessel name from settings so messages are identifiable per boat.
    """
    import urllib.request
    import urllib.error

    # Prepend boat name for multi-boat identification
    try:
        vessel_name = _load_settings().get("vessel", {}).get("name", "").strip()
        if vessel_name:
            text = f"[{vessel_name}] {text}"
    except Exception:
        pass

    def _worker() -> None:
        try:
            with open(TELEGRAM_CONF, "r") as fh:
                cfg = json.loads(fh.read())
            token   = cfg["token"]
            chat_id = str(cfg["chat_id"])
        except Exception:
            return  # config missing or invalid — skip silently
        try:
            payload = json.dumps({"chat_id": chat_id, "text": text}).encode()
            req = urllib.request.Request(
                f"https://api.telegram.org/bot{token}/sendMessage",
                data=payload,
                headers={"Content-Type": "application/json"},
                method="POST",
            )
            urllib.request.urlopen(req, timeout=8)
        except Exception as exc:
            log.warning("Telegram notify failed: %s", exc)

    t = threading.Thread(target=_worker, daemon=True)
    t.start()


def _snap() -> dict:
    with _state_lock:
        return dict(_state)


# ---------------------------------------------------------------------------
# SSE coalescing
#
# The bridge sends ~10 telemetry lines per 200 ms cycle (AP, MODE, HDG, CMD,
# RDR, RDR_PCT, ...).  Previously every line pushed a full-state snapshot to
# every browser: ~48 events/s, 85% of them identical, each one a full DOM
# re-render.  That made the page stutter and could overflow a browser's
# 60-entry queue (→ "dropped slow client") after a ~1.25 s stall.
#
# Now:
#   - the bridge thread parses a whole received burst in "batch" mode (state is
#     updated, nothing is pushed), then publishes once at the end of the burst;
#   - a snapshot identical to the last one published is not pushed at all.
# Publishing at the end of the burst (not on a timer) adds no extra latency.
# Updates from other threads (HTTP handlers, net monitor, disconnects) still
# publish immediately.  Transient TEST_LINE/TEST_DONE events bypass this
# (see _broadcast_transient) so no hardware-test line is ever merged away.
# ---------------------------------------------------------------------------
_batch = threading.local()             # .active == True while bridge parses a burst
_last_published: Optional[dict] = None  # last snapshot pushed; guarded by _sse_lock


def _update(**kw) -> None:
    """Update shared state and push it to every SSE subscriber.

    Inside a bridge-burst batch the push is deferred until _publish() is
    called at the end of the burst.
    """
    with _state_lock:
        _state.update(kw)
    if not getattr(_batch, "active", False):
        _publish()


def _publish() -> None:
    """Push the current state to all SSE subscribers, unless it is unchanged
    since the last push.

    The snapshot is taken while holding _sse_lock so two threads publishing at
    once cannot deliver an older snapshot after a newer one.
    """
    global _last_published
    with _sse_lock:
        snap = _snap()
        if snap == _last_published:
            return
        _last_published = snap
        _broadcast_locked(snap)


def _broadcast_transient(snap: dict) -> None:
    """Push a one-off snapshot (e.g. carrying _test_line) unconditionally.

    Any batched state is published first so ordering is preserved.  Not
    recorded as _last_published because the extra keys are not part of state.
    """
    _publish()
    with _sse_lock:
        _broadcast_locked(snap)


def _broadcast(snap: dict) -> None:
    with _sse_lock:
        _broadcast_locked(snap)


def _broadcast_locked(snap: dict) -> None:
    """Queue snap for every subscriber.  Caller must hold _sse_lock."""
    dead = []
    for sub in _sse_subs:
        try:
            sub["q"].put_nowait(snap)
        except queue.Full:
            dead.append(sub)
    for sub in dead:
        _sse_subs.remove(sub)
        log.debug("SSE: dropped slow client")









def _parse_bridge_line(line: str) -> None:
    """Parse one telemetry line received from the bridge."""
    parts = line.split()
    if not parts:
        return
    c = parts[0].upper()

    if c == "PONG":
        pass  # keepalive, no state change

    elif c == "HELLO":
        _update(bridge_ver=(parts[1] if len(parts) > 1 else "?"))

    elif c == "AP":
        try:
            _update(ap=int(parts[1]))
        except (IndexError, ValueError):
            pass

    elif c == "MODE":
        # Bridge sends MODE IDLE|AP|MANUAL every telemetry cycle
        if len(parts) > 1:
            mode = parts[1].upper()
            if mode in ("RAM_OFF", "RAM_ON"):
                _update(mode=mode)
            else:
                _update(mode=mode, ram_prog=None)   # sweep over: drop stale progress
            # The bridge ended REMOTE by itself (e.g. STEER LOSS after the phone's
            # heartbeat stopped): move the selector to AUTO so the page does not
            # keep showing REMOTE.  The grace covers the moment between selecting
            # REMOTE and the bridge confirming it.
            if mode != "MANUAL":
                with _state_lock:
                    ui = _state.get("ui_mode")
                if ui == "remote" and time.monotonic() - _ui_remote_since > UI_REMOTE_GRACE_S:
                    _update(ui_mode="auto")

    elif c in ("HDG", "CMD", "RDR", "DB"):
        try:
            _update(**{c.lower(): float(parts[1])})
        except (IndexError, ValueError):
            pass

    elif c == "RDR_PCT":
        try:
            _update(rdr_pct=float(parts[1]))
        except (IndexError, ValueError):
            pass

    elif c == "RDR_CMD":
        try:
            _update(rdr_cmd=int(parts[1]))
        except (IndexError, ValueError):
            pass

    elif c == "COMMS":
        # COMMS OK | COMMS WARN <detail> | COMMS CRIT
        if len(parts) > 1:
            _update(comms=parts[1].upper())

    elif c == "WARN":
        _update(warn=(parts[1] if len(parts) > 1 else None))

    elif c == "SETTINGS":
        # Response to SETTINGS GET: "SETTINGS <json>"
        # Response to SETTINGS SET: "SETTINGS OK" or "SETTINGS ERR"
        if len(parts) < 2:
            return
        sub = parts[1].upper()
        if sub in ("OK", "ERR"):
            # Ack for a SET command — signal waiting HTTP handler
            try:
                _settings_resp_q.put_nowait({"_ack": sub})
            except queue.Full:
                pass
        else:
            # Must be JSON payload (SETTINGS GET response).
            # The entire remainder of the line (after "SETTINGS ") is JSON.
            json_str = line[len("SETTINGS "):].strip()
            try:
                data = json.loads(json_str)
                _settings_resp_q.put_nowait(data)
            except (json.JSONDecodeError, queue.Full) as exc:
                log.warning("SETTINGS response parse error: %s", exc)

    elif c == "RUDDER_STALL":
        # Bridge sends RUDDER_STALL 0|1 every telemetry cycle.
        try:
            _update(rudder_stall=bool(int(parts[1])))
        except (IndexError, ValueError):
            pass

    elif c == "PYPILOT":
        # Bridge sends PYPILOT OK|DEAD every telemetry cycle.
        if len(parts) > 1:
            _update(pypilot_ok=(parts[1].upper() == "OK"))

    elif c == "LIMITS":
        # Rudder limits status (Dock-Side Wizard; "no rudder motion before limits").
        # Sent every telemetry cycle; unchanged snapshots are not re-published.
        try:
            _update(limits=json.loads(line.split(None, 1)[1]))
        except (IndexError, ValueError):
            log.warning("Bad LIMITS from bridge: %s", line)

    elif c == "RAM_PROG":
        # RAM sweep progress: RAM_PROG <full strokes done> <total>
        if len(parts) >= 3:
            _update(ram_prog=f"{parts[1]}/{parts[2]}")

    elif c == "RAM_RESULT":
        # RAM sweep summary JSON (end of sweep, disarm or refusal).  Transient:
        # shown once, never replayed to a browser that connects later.
        try:
            result = json.loads(line.split(None, 1)[1])
        except (IndexError, ValueError):
            log.warning("Bad RAM_RESULT from bridge: %s", line)
            return
        log.info("RAM sweep result: %s", json.dumps(result))
        snap = _snap()
        snap["_ram_result"] = result
        _broadcast_transient(snap)

    elif c == "TEST_LINE":
        # Bridge relays a plain-text result line from the Nano test firmware.
        # Broadcast transiently — does NOT persist in _state (avoids replay on reconnect).
        text = " ".join(parts[1:])
        snap = _snap()
        snap["_test_line"] = text
        _broadcast_transient(snap)   # never coalesced/deduped — every line must arrive

    elif c == "TEST_DONE":
        # Bridge signals that the Nano test run is complete.
        snap = _snap()
        snap["_test_done"] = True
        _broadcast_transient(snap)

    else:
        log.debug("Bridge unknown: %s", line)


def bridge_client() -> None:
    """
    Persistent TCP client to inno-pilot-bridge.
    Reconnects automatically after any failure.
    When _bridge_active is cleared (mode OFF), drops the current connection
    and does not reconnect until the event is set again.
    Runs forever as a daemon thread.
    """
    while True:
        # Don't attempt connection while mode is OFF
        if not _bridge_active.is_set():
            time.sleep(0.2)
            continue

        sock: Optional[socket.socket] = None
        intentional_disconnect = False
        try:
            log.info("Connecting to bridge %s:%d", BRIDGE_HOST, BRIDGE_PORT)
            sock = socket.create_connection((BRIDGE_HOST, BRIDGE_PORT), timeout=5.0)
            sock.settimeout(0.1)
            _update(connected=True)
            sock.sendall(f"HELLO {INNOPILOT_VERSION}\n".encode())

            buf = b""
            last_ping = time.monotonic()

            while True:
                # Drop connection immediately if mode switched to OFF
                if not _bridge_active.is_set():
                    log.info("Bridge: mode OFF — dropping TCP connection")
                    intentional_disconnect = True
                    break

                now = time.monotonic()
                if now - last_ping >= PING_PERIOD_S:
                    sock.sendall(b"PING\n")
                    last_ping = now

                # Forward any queued commands from browser to bridge
                while True:
                    try:
                        sock.sendall((_cmd_q.get_nowait() + "\n").encode())
                    except queue.Empty:
                        break

                # Read telemetry from bridge
                try:
                    chunk = sock.recv(512)
                    if not chunk:
                        raise OSError("Bridge EOF")
                    buf += chunk
                except socket.timeout:
                    pass

                # Parse the whole received burst, then publish ONE snapshot
                # (and only if something changed) — see "SSE coalescing" above.
                if b"\n" in buf:
                    _batch.active = True
                    try:
                        while b"\n" in buf:
                            raw, buf = buf.split(b"\n", 1)
                            _parse_bridge_line(raw.decode(errors="replace").strip())
                    finally:
                        _batch.active = False
                    _publish()

        except Exception as exc:
            log.warning("Bridge lost: %s", exc)

        finally:
            if sock:
                try:
                    sock.close()
                except Exception:
                    pass
            if intentional_disconnect:
                # Mode OFF — stay disconnected; state already set by _handle_command
                log.info("Bridge disconnected (mode OFF)")
            elif not _bridge_active.is_set():
                # OFF may have been requested while the socket was already down.
                # Preserve OFF state and stay idle until MODE ON/active command.
                _update(connected=False)
                log.info("Bridge idle (mode OFF)")
            else:
                # Unexpected loss while active — reset to IDLE and schedule reconnect
                _update(
                    connected=False, hdg=None, cmd=None,
                    rdr=None, rdr_pct=None, ap=0,
                    mode="IDLE", comms="OK", warn=None,
                    rudder_stall=False, pypilot_ok=True,
                )
                log.info("Reconnecting in %ds...", RECONNECT_DELAY_S)
                time.sleep(RECONNECT_DELAY_S)


# ---------------------------------------------------------------------------
# Ship's wheel SVG — generated once at startup
# ---------------------------------------------------------------------------

def _make_wheel_svg() -> str:
    """Return SVG markup for a wooden ship's wheel (8 spokes, brass hub)."""
    parts: list[str] = []

    # Drop shadow
    parts.append('<ellipse cx="102" cy="103" rx="86" ry="86" fill="rgba(0,0,0,0.28)"/>')

    # Rim — three layered stroked circles give a rounded 3-D wood appearance
    parts.append('<circle cx="100" cy="100" r="84" fill="none" stroke="#2A1408" stroke-width="20"/>')
    parts.append('<circle cx="100" cy="100" r="84" fill="none" stroke="#8B5E3C" stroke-width="14"/>')
    parts.append('<circle cx="100" cy="100" r="84" fill="none" stroke="#C49A6C" stroke-width="5"/>')
    parts.append('<circle cx="100" cy="100" r="76" fill="none" stroke="#1A0C04" stroke-width="1.5"/>')

    # 8 spokes + handle knobs at 45° intervals
    for i in range(8):
        a = math.radians(i * 45)
        ix = 100 + 22 * math.cos(a)
        iy = 100 + 22 * math.sin(a)
        ox = 100 + 73 * math.cos(a)
        oy = 100 + 73 * math.sin(a)
        kx = 100 + 80 * math.cos(a)
        ky = 100 + 80 * math.sin(a)

        if i == 6:
            # ── King spoke: Turk's Head rope-woven appearance ──
            # Dark shadow base
            parts.append(
                f'<line x1="{ix:.1f}" y1="{iy:.1f}" x2="{ox:.1f}" y2="{oy:.1f}" '
                f'stroke="#1A0C04" stroke-width="11" stroke-linecap="round"/>'
            )
            # Rope base (manila/cream)
            parts.append(
                f'<line x1="{ix:.1f}" y1="{iy:.1f}" x2="{ox:.1f}" y2="{oy:.1f}" '
                f'stroke="#C8922A" stroke-width="7" stroke-linecap="round"/>'
            )
            # Woven Turk's Head strand pattern — alternating X crossings along the spoke.
            # King spoke is vertical: (100,78) → (100,27), length 51 px.
            # 7 crossings spaced every 7 px give seamless tiling (strand half-height = 3.5 px).
            rw = 3.5   # half-width  of strand from spoke centre
            rh = 3.5   # half-height of each crossing
            s_dark = "#6B4010"   # shadow side of strand
            s_mid  = "#D4A050"   # lit side of strand
            s_hi   = "#F0D090"   # specular highlight
            for step in range(7):
                yc = 30.5 + step * 7.0
                if step % 2 == 0:
                    # "\" strand lies on top of "/" strand
                    parts.append(
                        f'<line x1="{100+rw:.1f}" y1="{yc-rh:.1f}" '
                        f'x2="{100-rw:.1f}" y2="{yc+rh:.1f}" '
                        f'stroke="{s_dark}" stroke-width="2.5" stroke-linecap="round"/>'
                    )
                    parts.append(
                        f'<line x1="{100-rw:.1f}" y1="{yc-rh:.1f}" '
                        f'x2="{100+rw:.1f}" y2="{yc+rh:.1f}" '
                        f'stroke="{s_mid}" stroke-width="2.5" stroke-linecap="round"/>'
                    )
                    parts.append(
                        f'<line x1="{100-rw+0.5:.1f}" y1="{yc-rh+0.5:.1f}" '
                        f'x2="{100+rw-1.0:.1f}" y2="{yc+rh-1.0:.1f}" '
                        f'stroke="{s_hi}" stroke-width="0.9" stroke-linecap="round" opacity="0.65"/>'
                    )
                else:
                    # "/" strand lies on top of "\" strand
                    parts.append(
                        f'<line x1="{100-rw:.1f}" y1="{yc-rh:.1f}" '
                        f'x2="{100+rw:.1f}" y2="{yc+rh:.1f}" '
                        f'stroke="{s_dark}" stroke-width="2.5" stroke-linecap="round"/>'
                    )
                    parts.append(
                        f'<line x1="{100+rw:.1f}" y1="{yc-rh:.1f}" '
                        f'x2="{100-rw:.1f}" y2="{yc+rh:.1f}" '
                        f'stroke="{s_mid}" stroke-width="2.5" stroke-linecap="round"/>'
                    )
                    parts.append(
                        f'<line x1="{100+rw-0.5:.1f}" y1="{yc-rh+0.5:.1f}" '
                        f'x2="{100-rw+1.0:.1f}" y2="{yc+rh-1.0:.1f}" '
                        f'stroke="{s_hi}" stroke-width="0.9" stroke-linecap="round" opacity="0.65"/>'
                    )
        else:
            # Normal spoke — layered for wood-grain depth
            parts.append(
                f'<line x1="{ix:.1f}" y1="{iy:.1f}" x2="{ox:.1f}" y2="{oy:.1f}" '
                f'stroke="#2A1408" stroke-width="9" stroke-linecap="round"/>'
            )
            parts.append(
                f'<line x1="{ix:.1f}" y1="{iy:.1f}" x2="{ox:.1f}" y2="{oy:.1f}" '
                f'stroke="#8B5E3C" stroke-width="5.5" stroke-linecap="round"/>'
            )
            parts.append(
                f'<line x1="{ix:.1f}" y1="{iy:.1f}" x2="{ox:.1f}" y2="{oy:.1f}" '
                f'stroke="#C09060" stroke-width="2" stroke-linecap="round"/>'
            )

        # Handle knob
        parts.append(
            f'<circle cx="{kx:.1f}" cy="{ky:.1f}" r="10" '
            f'fill="#2A1408" stroke="#1A0C04" stroke-width="1"/>'
        )
        parts.append(
            f'<circle cx="{kx:.1f}" cy="{ky:.1f}" r="7.5" fill="#7A5030"/>'
        )
        # Highlight
        parts.append(
            f'<circle cx="{kx - 1.5:.1f}" cy="{ky - 1.5:.1f}" r="3" '
            f'fill="#C09060" opacity="0.6"/>'
        )

    # Brass center hub
    parts.append('<circle cx="100" cy="100" r="23" fill="#2A1408" stroke="#1A0C04" stroke-width="2"/>')
    parts.append('<circle cx="100" cy="100" r="20" fill="#C49020"/>')
    parts.append('<circle cx="100" cy="100" r="14" fill="#DAA520" stroke="#8B6010" stroke-width="1"/>')
    parts.append('<circle cx="100" cy="100" r="7"  fill="#F5D060"/>')
    parts.append('<circle cx="97"  cy="97"  r="3"  fill="#FFF8C0" opacity="0.55"/>')

    return "\n        ".join(parts)


_WHEEL_SVG = _make_wheel_svg()

# ---------------------------------------------------------------------------
# Embedded single-page web app
# ---------------------------------------------------------------------------
_HTML = """<!DOCTYPE html>
<html lang="en">
<head>
<meta charset="UTF-8">
<meta name="viewport" content="width=device-width,initial-scale=1,maximum-scale=1,user-scalable=no">
<title>Inno-Remote</title>
<style>
*,*::before,*::after{box-sizing:border-box;margin:0;padding:0}
html,body{height:100%}
body{
  background:#0d0f1e;
  display:flex;
  align-items:flex-start;
  justify-content:center;
  padding:10px 6px 24px;
  font-family:'Segoe UI',Roboto,Arial,sans-serif;
  min-height:100vh;
}

/* ── Remote outer case ── */
.remote{
  background:linear-gradient(160deg,#f5f5f5 0%,#dcdcdc 100%);
  border-radius:26px;
  box-shadow:
    0 30px 80px rgba(0,0,0,0.65),
    inset 0 1px 0 rgba(255,255,255,0.9),
    inset 0 -2px 6px rgba(0,0,0,0.12);
  padding:16px 14px 13px;   /* bottom kept small: .remote-id sits on the bottom edge */
  width:340px;
  max-width:98vw;
  display:flex;
  flex-direction:column;
  gap:13px;
  -webkit-user-select:none;user-select:none;
}

/* ── OLED display ── */
.oled{
  background:#06081a;
  border-radius:9px;
  padding:4px 12px 4px;
  box-shadow:
    inset 0 3px 10px rgba(0,0,0,0.9),
    0 0 0 3px #1e2040,
    0 0 0 5px #2e3060,
    0 0 0 7px #131326;
  display:flex;
  flex-direction:column;
  gap:0;
  justify-content:space-between;
  height:138px; /* content-box height; rendered total ≈ 146px (est. base +50px) */
}

/* Rudder position bar — all heights doubled (bar 16→32, track 2→4, tick 10→20,
   marker 12→24, arrow 14→28); widths unchanged so the JS arrow offsets still fit. */
.rdr-bar{
  position:relative;
  height:32px;
  display:flex;
  align-items:center;
  padding:0 4px;
}
.rdr-track{
  width:100%;
  height:4px;
  background:repeating-linear-gradient(90deg,
    #1a4060 0,#1a4060 4px,transparent 4px,transparent 8px);
  position:relative;
}
.rdr-center-tick{
  position:absolute;
  left:50%;
  top:-8px;
  width:2px;
  height:20px;
  background:#2a6090;
  transform:translateX(-50%);
}
.rdr-marker{
  position:absolute;
  width:12px;
  height:24px;
  background:#00d4ff;
  box-shadow:0 0 6px #00bfff;
  top:50%;
  left:50%;
  transform:translate(-50%,-50%);
  /* Rudder telemetry arrives at ~5 Hz (one update per bridge cycle, ~200 ms).
     A linear glide of the same length makes successive steps join into one
     continuous movement; the old 0.12 s ease stopped short of each 200 ms
     step, so the marker visibly jumped.  Do not make this much longer than
     the update interval: the glide then shows the rudder where it WAS. */
  transition:left 0.2s linear;
}

/* Rudder command direction triangle */
.rdr-cmd-arrow{
  position:absolute;
  top:50%;
  transform:translateY(-50%);
  width:0;
  height:0;
  border-top:14px solid transparent;
  border-bottom:14px solid transparent;
  display:none;        /* hidden by default; shown by JS */
  transition:left 0.2s linear;  /* match rdr-marker so arrow glides in lockstep */
}
.rdr-cmd-arrow.port{
  border-right:12px solid #ff6a00;  /* orange, points left */
}
.rdr-cmd-arrow.stbd{
  border-left:12px solid #ff6a00;   /* orange, points right */
}

/* Mode line: same face, weight, size and colour as the CMD/Head readout (.oled-data),
   so e.g. "AP ON" reads as one uniform OLED line.  (RAM-test labels keep their
   inline orange.)  Previously grey 0.8em text with a 1.5x "AP". */
.oled-mode{color:#00d4ff;font-family:'Courier New',monospace;font-weight:700;font-size:1.2em;
  line-height:1.2;display:flex;align-items:flex-end;justify-content:center}
.oled-mode b{color:#00d4ff}
.oled-mode .ap-label{color:#00d4ff}
.oled-data{
  color:#00d4ff;
  font-size:1.2em;
  font-weight:700;
  font-family:'Courier New',monospace;
  display:flex;
  justify-content:space-between;
}
/* Each readout is two lines: label on top, value centred beneath it */
.oled-data .od-col{display:flex;flex-direction:column;align-items:center;line-height:1.2}
.oled-btns{
  display:flex;
  justify-content:center;
  gap:4px;
  margin-top:1px;
}
.oled-btn{
  background:#0a1428;
  color:#7aabcc;
  border:1px solid #1e3850;
  border-radius:3px;
  font-size:0.7em;
  padding:2px 7px;
  cursor:pointer;
  font-family:'Courier New',monospace;
  touch-action:manipulation;
}
.oled-btn:active{background:#1a3060}
.ok{color:#00cc70}
.warn{color:#ffaa00}
.crit{color:#ff3030;animation:blink .45s step-end infinite}
@keyframes blink{50%{opacity:0}}

/* ── Physical button row ── */
.btn-row{
  display:flex;
  justify-content:space-between;
  gap:5px;
}
.hw-btn{
  flex:1;
  height:50px;
  border:none;
  border-radius:8px;
  font-size:1.2em;
  font-weight:800;
  cursor:pointer;
  color:#fff;
  box-shadow:0 5px 0 rgba(0,0,0,0.38),0 6px 10px rgba(0,0,0,0.28);
  transition:transform .07s,box-shadow .07s;
  display:flex;align-items:center;justify-content:center;
  touch-action:manipulation;
}
.hw-btn:active{transform:translateY(4px);box-shadow:0 1px 0 rgba(0,0,0,0.38),0 2px 4px rgba(0,0,0,0.28)}
.hw-btn.b1{background:linear-gradient(180deg,#ff5a5a,#c00000)}
.hw-btn.b2{background:linear-gradient(180deg,#cacaca,#909090);color:#111}
.hw-btn.b3{background:linear-gradient(180deg,#444444,#111111)}
.hw-btn.b4{background:linear-gradient(180deg,#55cc55,#1a8a1a)}
.hw-btn.b5{background:linear-gradient(180deg,#55cc55,#1a8a1a)}

/* ── STOP + toggle row ── */
.action-row{
  display:flex;
  align-items:center;
  justify-content:space-between;
  padding:0 10px;
}

/* STOP button */
.stop-wrap{
  position:relative;
  width:96px;
  height:96px;
}
.stop-ring{
  position:absolute;
  inset:0;
  border-radius:50%;
  background:radial-gradient(circle at 35% 28%,#dddddd,#9a9a9a 55%,#686868);
  box-shadow:0 4px 14px rgba(0,0,0,0.5),inset 0 1px 0 rgba(255,255,255,0.55);
}
.stop-btn{
  position:absolute;
  inset:8px;
  border-radius:50%;
  border:none;
  cursor:pointer;
  background:radial-gradient(circle at 38% 28%,#ff7070,#cc0000 55%,#7a0000);
  color:#fff;
  font-size:1.05em;
  font-weight:900;
  letter-spacing:2px;
  box-shadow:0 6px 0 #550000,0 8px 18px rgba(0,0,0,0.5),
             inset 0 2px 4px rgba(255,255,255,0.18);
  transition:transform .07s,box-shadow .07s;
  touch-action:manipulation;
}
.stop-btn:active{
  transform:translateY(4px);
  box-shadow:0 2px 0 #550000,0 4px 8px rgba(0,0,0,0.5),
             inset 0 2px 4px rgba(255,255,255,0.18);
}

/* ── 4-position mode radio selector ── */
.mode-radio-group{display:flex;flex-direction:column;gap:12px;justify-content:center}
.mode-radio{display:flex;align-items:center;gap:10px;cursor:pointer;user-select:none;-webkit-user-select:none}
.mrd-dot{
  width:22px;height:22px;border-radius:50%;
  border:2px solid #888;background:#ccc;
  position:relative;flex-shrink:0;
  transition:border-color .18s,background .18s;
}
.mrd-dot::after{
  content:'';position:absolute;inset:4px;border-radius:50%;
  background:#007aff;transform:scale(0);
  transition:transform .22s cubic-bezier(.34,1.56,.64,1);
}
.mode-radio.active .mrd-dot{border-color:#007aff;background:#d8eaff}
.mode-radio.active .mrd-dot::after{transform:scale(1)}
.mrd-lbl{
  font-size:0.7em;font-weight:600;color:#999;
  letter-spacing:0.5px;line-height:1.1;
  transition:color .15s,font-weight .15s;
}
.mode-radio.active .mrd-lbl{color:#111;font-weight:800}
.mode-radio:hover .mrd-lbl{color:#444}
.mode-radio.disabled{pointer-events:none;cursor:default;opacity:0.28}
/* OFF mode: blank the OLED content area */
.oled.blank-mode .rdr-bar,
.oled.blank-mode .oled-mode,
.oled.blank-mode .oled-data{visibility:hidden}

/* ── Ship's wheel ── */
.wheel-section{
  display:flex;
  flex-direction:column;
  align-items:center;
  gap:5px;
  /* Moved up by the height of the former OLED title row (22px) — the space freed
     by moving the name to the bottom edge.  The wheel's round top clears the
     STOP button and radios.  Below this, wheel / footer / .remote-id are spaced
     evenly by the remote's 13px flex gap. */
  margin-top:-22px;
}
.wheel-wrap{
  width:210px;
  height:210px;
  cursor:grab;
  touch-action:none;
  filter:saturate(0.3) brightness(0.5);
  transition:filter .35s;
}
.wheel-wrap.active{
  filter:saturate(1) brightness(1);
}
.wheel-wrap.active:active{cursor:grabbing}
#wheel-svg{width:100%;height:100%;display:block;
  /* Same 0.2 s linear glide as .rdr-marker, so the wheel follows the rudder
     telemetry smoothly and in step with the bar. */
  transition:transform 0.2s linear}
/* REMOTE (MANUAL) mode: the wheel follows the skipper's finger/mouse and the
   jog buttons — it must track instantly, so no glide while active. */
.wheel-wrap.active #wheel-svg{transition:none}

/* ── Nudge buttons (port/stbd, flank the helm wheel) ── */
.wheel-nudge-row{
  display:flex;
  align-items:center;
  gap:10px;
}
.nudge-btn{
  width:52px;height:52px;
  border-radius:10px;
  background:#12192e;
  border:2px solid #2e5490;
  color:#5bb8ff;
  font-size:1.5em;
  line-height:1;
  cursor:pointer;
  touch-action:manipulation;
  flex-shrink:0;
  transition:background .12s,opacity .2s,border-color .2s;
  -webkit-user-select:none;user-select:none;
}
.nudge-btn:active{background:#0d2a50;border-color:#5bb8ff}
.nudge-btn:disabled{
  opacity:0.22;
  cursor:not-allowed;
  border-color:#2a2a2a;
  color:#444;
}

/* ── "No bridge" overlay ── */
.no-bridge-overlay{
  position:fixed;
  inset:0;
  background:rgba(6,8,28,.88);
  display:flex;
  flex-direction:column;
  align-items:center;
  justify-content:center;
  gap:14px;
  z-index:200;
  pointer-events:none;
  -webkit-backdrop-filter:blur(5px);
  backdrop-filter:blur(5px);
}
.no-bridge-overlay h2{
  font-size:1.5em;
  color:#ff4040;
  letter-spacing:3px;
  text-align:center;
  max-width:300px;     /* keep the text inside the remote's width (design rule 1);
                          the longer plain-English heading wraps to two lines */
}
.no-bridge-overlay p{color:#aaa;font-size:.9em}
.no-bridge-overlay.hidden{display:none}

@media(max-width:350px){
  .remote{width:100vw;border-radius:0;padding:10px 8px 16px}
}

/* ── Gear / settings button ─────────────────────────────────────────── */
.settings-footer{display:flex;justify-content:flex-start;align-items:center;padding:0 4px 2px;gap:8px}
.gear-btn{
  width:38px;height:38px;border-radius:50%;
  background:#111;border:1.5px solid #333;
  color:#fff;font-size:1.3em;line-height:1;
  cursor:pointer;display:flex;align-items:center;justify-content:center;
  box-shadow:0 3px 8px rgba(0,0,0,.55),inset 0 1px 0 rgba(255,255,255,.07);
  transition:transform .1s,background .15s,border-color .15s;
  touch-action:manipulation;
}
.gear-btn:active{transform:scale(.88)}
.gear-btn.settings-open{
  background:#0d2a40;border-color:#00bfff;color:#00d4ff;
  box-shadow:0 0 8px rgba(0,191,255,.45),0 3px 8px rgba(0,0,0,.4);
}

/* ── Settings overlay panel ─────────────────────────────────────────── */
.sov{
  position:fixed;inset:0;background:rgba(4,6,22,.92);
  display:flex;align-items:center;justify-content:center;
  z-index:400;
  -webkit-backdrop-filter:blur(4px);backdrop-filter:blur(4px);
}
.sov.hidden{display:none}
.spanel{
  background:linear-gradient(170deg,#0e1226,#080b18);
  border:1px solid #1e2a50;border-radius:13px;
  box-shadow:0 24px 70px rgba(0,0,0,.85),0 0 0 1px rgba(0,191,255,.08);
  width:318px;max-width:96vw;max-height:88vh;
  display:flex;flex-direction:column;overflow:hidden;
}
.shdr{
  background:linear-gradient(90deg,#0c1830,#101e40);
  border-bottom:1px solid #1a2840;
  padding:9px 14px 7px;flex-shrink:0;
}
.shdr-title{
  color:#00d4ff;font-size:1.0em;font-weight:700;
  letter-spacing:3px;text-shadow:0 0 10px rgba(0,191,255,.4);
  display:block;
}
.shdr-hint{
  color:#354860;font-size:.62em;font-family:'Courier New',monospace;
  letter-spacing:.5px;margin-top:2px;display:block;
}
/* Status/feedback line shown below the header hint while loading/saving settings */
.shdr-status{font-size:.67em;font-family:'Courier New',monospace;margin-top:3px;
  min-height:1em;transition:color .2s;display:block;}
.shdr-status.s-ok  {color:#00cc50;}
.shdr-status.s-warn{color:#f0a000;}
.shdr-status.s-err {color:#cc3030;}
.shdr-status.s-pend{color:#6090b0;}
.sbody{overflow-y:auto;padding:6px 12px 10px;flex:1;overscroll-behavior:contain}
.ss-title{
  color:#3090b8;font-size:.68em;font-weight:700;letter-spacing:2px;
  margin:12px 0 4px;padding-bottom:3px;border-bottom:1px solid #152030;
}
.ss-title:first-child{margin-top:4px}
/* Top-level groups: SETUP WIZARDS (always shown) and ADVANCED SETTINGS
   (every individual setting; collapsed each time the panel opens). */
.sg-title{
  color:#00d4ff;font-size:.74em;font-weight:700;letter-spacing:2.5px;
  margin:14px 0 4px;padding:4px 5px;border-radius:4px;
  background:rgba(0,191,255,.06);border-left:3px solid #00bfff;
}
.sg-title:first-child{margin-top:4px}
.sf-adv.hidden{display:none}
/* Wizard rows not yet built: shown so the structure is visible, not selectable */
.sf-bb.sf-soon{cursor:default;opacity:.45;filter:grayscale(1)}
/* Dead setting: stored and saved, but nothing on the Pi or Nano acts on it yet.
   Shown greyed out and locked until it is wired up or removed (see TODO.md). */
.sf-row.sf-dead{opacity:.4;filter:grayscale(1)}
.sf-row.sf-dead *{pointer-events:none}
.sf-dead-tag{color:#607080;font-size:.78em;letter-spacing:.5px;margin-left:4px}
.sf-row{
  display:flex;align-items:center;justify-content:space-between;
  padding:5px 5px;border-radius:5px;border:1px solid transparent;gap:6px;
  transition:border-color .13s,background .13s;
}
.sf-row.focused{
  background:rgba(0,80,160,.20);border-color:#0080c0;
  box-shadow:0 0 7px rgba(0,128,192,.28);
}
.sf-row.sf-hidden{display:none}
.sf-lbl{color:#90a8c0;font-size:.76em;min-width:108px;flex-shrink:0}
.sf-eval{
  color:#00d4ff;font-size:.8em;font-family:'Courier New',monospace;
  font-weight:700;min-width:64px;text-align:right;
}
.sf-inp{
  background:#080f20;border:1px solid #1e3450;border-radius:4px;
  color:#00d4ff;font-family:'Courier New',monospace;font-size:.79em;
  padding:3px 6px;width:130px;outline:none;
}
.sf-inp:focus{border-color:#0090d0;box-shadow:0 0 5px rgba(0,144,208,.35)}
.sf-bool{display:flex;gap:4px}
.sf-bb{
  padding:3px 9px;border-radius:4px;border:1px solid #1e3450;
  background:#080f20;color:#4a6a80;font-size:.72em;font-weight:700;
  cursor:pointer;touch-action:manipulation;font-family:'Courier New',monospace;
  transition:background .1s,color .1s,border-color .1s;
}
.sf-bb.bb-on {background:#082010;border-color:#00a030;color:#00cc50}
.sf-bb.bb-off{background:#200808;border-color:#a02020;color:#cc3030}
.sftr{border-top:1px solid #152030;padding:7px 12px;display:flex;gap:8px;flex-shrink:0}
.sftr-btn{
  flex:1;padding:7px 0;border-radius:6px;border:none;
  font-size:.8em;font-weight:700;cursor:pointer;letter-spacing:1.5px;
  touch-action:manipulation;
}
.sftr-btn.sv {background:linear-gradient(180deg,#0d4020,#061808);color:#00cc50;border:1px solid #0a4020}
.sftr-btn.cx {background:linear-gradient(180deg,#280c0c,#140404);color:#cc3030;border:1px solid #3a1010}

/* ── DEBUG toggle button (oval pill, replaces old circular Test button) ── */
.dbg-btn{
  height:38px;padding:0 14px;border-radius:19px;
  background:#111;border:1.5px solid #333;
  color:#e8a020;font-size:.72em;font-weight:700;line-height:1;
  cursor:pointer;display:flex;align-items:center;justify-content:center;
  box-shadow:0 3px 8px rgba(0,0,0,.55),inset 0 1px 0 rgba(255,255,255,.07);
  transition:transform .1s,background .15s,border-color .15s;
  touch-action:manipulation;letter-spacing:.5px;white-space:nowrap;
}
.dbg-btn:active{transform:scale(.88)}
.dbg-btn.dbg-active{
  background:#1a0a00;border-color:#e8a020;color:#f0c040;
  box-shadow:0 0 8px rgba(232,160,32,.45),0 3px 8px rgba(0,0,0,.4);
  animation:dbg-flash 1s ease-in-out infinite;
}
@keyframes dbg-flash{0%,100%{opacity:1}50%{opacity:.35}}

/* ── TEST overlay ────────────────────────────────────────────────────── */
.tov{
  position:fixed;inset:0;background:rgba(4,6,22,.92);
  display:flex;align-items:center;justify-content:center;
  z-index:400;
  -webkit-backdrop-filter:blur(4px);backdrop-filter:blur(4px);
}
.tov.hidden{display:none}
.tpanel{
  background:linear-gradient(170deg,#0e1226,#080b18);
  border:1px solid #2a1a00;border-radius:13px;
  box-shadow:0 24px 70px rgba(0,0,0,.85),0 0 0 1px rgba(232,160,32,.08);
  width:318px;max-width:96vw;max-height:88vh;
  display:flex;flex-direction:column;overflow:hidden;
}
.thdr{
  background:linear-gradient(90deg,#1a1000,#201800);
  border-bottom:1px solid #2a1a00;
  padding:9px 14px 7px;flex-shrink:0;
}
.thdr-title{
  color:#e8a020;font-size:1.0em;font-weight:700;
  letter-spacing:3px;text-shadow:0 0 10px rgba(232,160,32,.4);
  display:block;
}
.thdr-hint{
  color:#504030;font-size:.62em;font-family:'Courier New',monospace;
  letter-spacing:.5px;margin-top:2px;display:block;
}
.tbody{overflow-y:auto;padding:6px 12px 10px;flex:1;overscroll-behavior:contain}

/* Catalogue list */
.tcat-item{
  display:flex;align-items:center;gap:8px;
  padding:7px 6px;border-radius:6px;border:1px solid #1a1200;
  margin-bottom:4px;cursor:pointer;touch-action:manipulation;
  transition:background .12s,border-color .12s;
}
.tcat-item:active,.tcat-item:hover{background:rgba(232,160,32,.08);border-color:#604010}
.tcat-num{
  background:#1a1200;color:#e8a020;font-size:.7em;font-weight:700;
  font-family:'Courier New',monospace;border-radius:4px;
  padding:3px 6px;min-width:22px;text-align:center;flex-shrink:0;
}
.tcat-name{color:#c0a060;font-size:.76em;line-height:1.35;flex:1}
.tcat-arrow{color:#504030;font-size:1.0em;flex-shrink:0}
/* Unavailable test (needs bench firmware): greyed out, not selectable */
.tcat-item.tcat-off{cursor:default;opacity:.45;filter:grayscale(1)}
.tcat-item.tcat-off:active,.tcat-item.tcat-off:hover{background:none;border-color:#1a1200}
.tcat-na{color:#605848;font-size:.6em;letter-spacing:.5px;flex-shrink:0;text-align:right;line-height:1.3}

/* Detail view */
.tdet-view{display:none}
.tdet-view.active{display:block}
.tcat-view.hidden{display:none}
.tdet-name{
  color:#e8a020;font-size:.88em;font-weight:700;letter-spacing:.5px;
  margin-bottom:8px;line-height:1.3;
}
.tdet-section{
  color:#6080a0;font-size:.6em;font-weight:700;letter-spacing:2px;
  margin:8px 0 3px;text-transform:uppercase;
}
.tdet-text{color:#90a8b8;font-size:.72em;line-height:1.55;margin-bottom:4px;white-space:pre-wrap}
.tdet-fw{
  background:#0d0f1e;border:1px solid #1a1200;border-radius:4px;
  color:#e8a020;font-family:'Courier New',monospace;font-size:.67em;
  padding:4px 8px;margin-bottom:6px;white-space:pre-wrap;word-break:break-all;
}
.tdet-confirm{
  display:flex;gap:8px;margin-top:10px;
}
.tdet-btn{
  flex:1;padding:8px 0;border-radius:6px;border:none;
  font-size:.78em;font-weight:700;cursor:pointer;letter-spacing:1.5px;
  touch-action:manipulation;
}
.tdet-btn.yes{background:linear-gradient(180deg,#0d4020,#061808);color:#00cc50;border:1px solid #0a4020}
.tdet-btn.no {background:linear-gradient(180deg,#280c0c,#140404);color:#cc3030;border:1px solid #3a1010}

/* Results view */
.tres-view{display:none}
.tres-view.active{display:block}
.tres-name{color:#e8a020;font-size:.85em;font-weight:700;margin-bottom:6px;line-height:1.3}
.tres-log{
  background:#06081a;border-radius:6px;border:1px solid #0a0e24;
  padding:7px 8px;height:220px;overflow-y:auto;
  font-family:'Courier New',monospace;font-size:.67em;color:#00cc80;
  line-height:1.5;white-space:pre-wrap;word-break:break-all;
}
.tres-status{
  color:#e8a020;font-size:.7em;text-align:center;
  margin-top:5px;font-family:'Courier New',monospace;letter-spacing:1px;
}
.tres-b3{
  display:none;width:100%;margin-top:6px;
  padding:8px 0;border-radius:6px;border:1px solid #0a4020;
  background:linear-gradient(180deg,#0d4020,#061808);color:#00cc50;
  font-size:.78em;font-weight:700;cursor:pointer;letter-spacing:1.5px;
  touch-action:manipulation;
}
.tres-b3.visible{display:block}

/* Dock-Side Wizard (reuses the TEST overlay panel) */
.wz-rud{font-family:'Courier New',monospace;color:#00d4ff;font-size:1.5em;text-align:center;
  padding:4px 0;letter-spacing:1px}
.wz-stat{font-size:.72em;border-radius:5px;padding:5px 8px;margin:4px 0;line-height:1.45;white-space:pre-wrap}
.wz-stat.ok {background:rgba(0,204,80,.08);border:1px solid #0a4020;color:#00cc50}
.wz-stat.bad{background:rgba(204,48,48,.08);border:1px solid #3a1010;color:#e06060}
.wz-row{display:flex;align-items:center;gap:8px;padding:4px 0}
.wz-inp{width:58px;background:#080f20;border:1px solid #1e3450;border-radius:4px;color:#00d4ff;
  font-family:'Courier New',monospace;font-size:.95em;padding:4px 6px;outline:none;text-align:center}
.wz-lbl{color:#90a8c0;font-size:.74em;flex:1;line-height:1.35}
.wz-btn{padding:6px 10px;border-radius:6px;font-size:.72em;font-weight:700;letter-spacing:1px;
  cursor:pointer;touch-action:manipulation;border:1px solid #1e3450;
  background:linear-gradient(180deg,#0e2038,#08121f);color:#00d4ff;min-width:84px}
.wz-btn:disabled{opacity:.4;cursor:default}
.wz-btn.done{border-color:#0a4020;color:#00cc50}
.wz-msg{font-family:'Courier New',monospace;font-size:.66em;color:#e8a020;min-height:1.2em;
  margin-top:6px;white-space:pre-wrap}
.wz-next{color:#506070;font-size:.68em;line-height:1.6}

/* Shared footer */
.tftr{border-top:1px solid #1a1200;padding:7px 12px;display:flex;gap:8px;flex-shrink:0}
.tftr-btn{
  flex:1;padding:7px 0;border-radius:6px;border:none;
  font-size:.78em;font-weight:700;cursor:pointer;letter-spacing:1.5px;
  touch-action:manipulation;
}
.tftr-btn.back{background:linear-gradient(180deg,#1a1000,#0d0800);color:#a07020;border:1px solid #2a1800}
.tftr-btn.close{background:linear-gradient(180deg,#280c0c,#140404);color:#cc3030;border:1px solid #3a1010}

/* ── Alert panel (footer, right of Debug button; inside the remote body) ──
   The ONE place for warnings, errors and system info (the OLED above is for
   steering command/control only).  A miniature of the main .oled screen: same
   near-black ground, Courier text and ringed bezel.  Rows: cyan = info/debug,
   cyan = warning (like CMD/Head), red blinking = critical.  The bezel rings extend outside the
   box, so the margins keep them clear of the Debug button and the remote's edge. */
#alert-oled{
  flex:1;min-width:0;height:46px;box-sizing:border-box;
  margin:3px 5px 3px 6px;padding:3px 6px;
  background:#06081a;border-radius:7px;
  box-shadow:inset 0 2px 6px rgba(0,0,0,.9),
             0 0 0 2px #1e2040,0 0 0 3px #2e3060;
  display:flex;flex-direction:column;justify-content:center;
  /* Same face, weight and colour as the OLED CMD/Head readout (.oled-data).
     Size is smaller than CMD/Head's 1.2em so 3 rows x ALERT_COLS fit the panel. */
  font-family:'Courier New',monospace;font-weight:700;font-size:.7em;line-height:1.2;
  color:#00d4ff;white-space:nowrap;overflow:hidden;
}
#alert-oled div{overflow:hidden;text-overflow:ellipsis}
/* "All Services Nominal": two centred lines at the full CMD/Head size.
   1.2em of the remote = (1.2/.7)em of this panel.  line-height:1 so both
   lines fit the 46px panel. */
#alert-oled .a-nominal{font-size:calc(1.2em / .7);line-height:1;text-align:center}
/* Warnings use the panel's OLED cyan (same as CMD/Head); only criticals stand out
   in red and blink. */
#alert-oled .a-warn{color:#00d4ff}
#alert-oled .a-crit{color:#ff3030;text-shadow:0 0 6px rgba(255,48,48,.5);
  animation:blink .45s step-end infinite}

/* ── Name + version, printed in black on the bottom edge of the remote body ── */
.remote-id{display:flex;justify-content:space-between;align-items:baseline;
  padding:0 8px;column-gap:8px;color:#000;font-weight:700;letter-spacing:1px;line-height:1.2;
  white-space:nowrap}
/* Name matches the OLED "Head"/"CMD" size (.oled-data, 1.2em); version stays small */
.remote-id .rid-name{font-size:1.2em;letter-spacing:.5px}
.remote-id .rid-ver{font-size:.72em}

/* ── Boat-name setup modal ──────────────────────────────────────────────── */
.bnm-overlay{position:fixed;inset:0;background:rgba(0,0,0,.80);display:none;
  align-items:center;justify-content:center;z-index:2000}
.bnm-overlay.visible{display:flex}
.bnm-box{background:#1a1a2e;border:1px solid #0090d0;border-radius:10px;
  padding:28px 24px;max-width:320px;width:90%;text-align:center}
.bnm-title{font-size:1.1em;font-weight:bold;color:#0090d0;margin-bottom:10px}
.bnm-body{font-size:0.82em;color:#aaa;margin-bottom:18px;line-height:1.4}
.bnm-inp{width:100%;box-sizing:border-box;padding:9px 10px;background:#0d1117;
  border:1px solid #444;border-radius:5px;color:#e0e0e0;font-size:1em;
  margin-bottom:8px;outline:none}
.bnm-inp:focus{border-color:#0090d0}
.bnm-err{color:#e05050;font-size:0.78em;min-height:1.1em;margin-bottom:10px}
.bnm-btn{background:#0090d0;color:#fff;border:none;border-radius:5px;
  padding:9px 28px;font-size:0.95em;cursor:pointer;font-weight:bold}
.bnm-btn:active{opacity:.75}
/* ── Software update modal ──────────────────────────────────────────────── */
.upd-overlay{position:fixed;inset:0;background:rgba(0,0,0,.80);display:none;
  align-items:center;justify-content:center;z-index:2001}
.upd-overlay.visible{display:flex}
.upd-box{background:#1a1a2e;border:1px solid #0090d0;border-radius:10px;
  padding:24px 22px;max-width:380px;width:92%;text-align:left}
.upd-title{font-size:1.1em;font-weight:bold;color:#0090d0;margin-bottom:12px;text-align:center}
.upd-body{font-size:0.80em;color:#ccc;margin-bottom:16px;line-height:1.5;
  max-height:200px;overflow-y:auto;white-space:pre-wrap;font-family:monospace}
.upd-actions{display:flex;gap:10px;justify-content:center}
.upd-btn{border:none;border-radius:5px;padding:8px 22px;font-size:0.92em;
  cursor:pointer;font-weight:bold}
.upd-install{background:#0090d0;color:#fff}
.upd-close{background:#444;color:#ccc}
.upd-btn:active{opacity:.75}
/* Terminal log pane inside the update modal */
.upd-box.terminal{max-width:540px}
#upd-log{display:none;background:#0a0a0a;color:#00e000;font-family:'Courier New',monospace;
  font-size:0.70em;padding:10px;border-radius:5px;max-height:320px;overflow-y:auto;
  white-space:pre-wrap;word-break:break-all;margin-bottom:12px;min-height:80px}
</style>
</head>
<body>

<!-- Disconnected overlay (visible until SSE delivers connected=true) -->
<div class="no-bridge-overlay" id="overlay">
  <h2>AUTO PILOT: CONNECTION LOST</h2>
  <p>Trying to reconnect\u2026</p>
  <p id="dots">\u25cf</p>
</div>

<div class="remote">

  <!-- OLED display panel -->
  <div class="oled">
    <!-- The product name + version moved out of the OLED to the bottom edge of the
         remote (.remote-id), so this screen carries steering info only. -->

    <!-- Rudder position bar -->
    <div class="rdr-bar">
      <div class="rdr-track">
        <div class="rdr-center-tick"></div>
        <div class="rdr-marker" id="rdr-marker"></div>
        <div class="rdr-cmd-arrow port" id="rdr-arrow-port"></div>
        <div class="rdr-cmd-arrow stbd" id="rdr-arrow-stbd"></div>
      </div>
    </div>

    <div class="oled-data">
      <div class="od-col"><span>Command</span><span><span id="o-cmd">---</span>&deg;</span></div>
      <div class="od-col"><span>Heading</span><span><span id="o-hdg">---</span>&deg;</span></div>
    </div>

    <div class="oled-mode" id="oled-mode-row"><b id="o-mode">IDLE</b></div>

    <!-- Warnings, errors and system info are NOT shown here: this screen is for the
         skipper's steering command/control only.  See #alert-oled (bottom right). -->

  </div>

  <!-- Physical button row -->
  <div class="btn-row">
    <button class="hw-btn b1" data-cmd="BTN -10">&laquo;</button>
    <button class="hw-btn b2" data-cmd="BTN -1">&lsaquo;</button>
    <button class="hw-btn b3" data-cmd="BTN TOGGLE">|</button>
    <button class="hw-btn b4" data-cmd="BTN +1">&rsaquo;</button>
    <button class="hw-btn b5" data-cmd="BTN +10">&raquo;</button>
  </div>

  <!-- STOP button + 3-position mode toggle -->
  <div class="action-row">
    <div class="stop-wrap">
      <div class="stop-ring"></div>
      <button class="stop-btn" id="stop-btn">STOP</button>
    </div>

    <div class="mode-radio-group" id="mode-radio-group">
      <div class="mode-radio" data-action="auto">
        <span class="mrd-dot"></span><span class="mrd-lbl">AUTO</span>
      </div>
      <div class="mode-radio disabled" data-action="remote">
        <span class="mrd-dot"></span><span class="mrd-lbl">REMOTE</span>
      </div>
      <div class="mode-radio active" data-action="on">
        <span class="mrd-dot"></span><span class="mrd-lbl">ON</span>
      </div>
      <div class="mode-radio" data-action="off">
        <span class="mrd-dot"></span><span class="mrd-lbl">OFF</span>
      </div>
    </div>
  </div>

  <!-- Ship's wheel (rotatable, active in MANUAL mode) -->
  <!-- Nudge buttons (port/stbd) flank the wheel; active in AUTO mode only -->
  <div class="wheel-section">
    <div class="wheel-nudge-row">
      <button class="nudge-btn" id="nudge-port" title="Port nudge — hold to extend (min 500 ms)" disabled>&#9664;</button>
      <div class="wheel-wrap" id="wheel-wrap">
        <svg id="wheel-svg" viewBox="0 0 200 200" xmlns="http://www.w3.org/2000/svg">
          $$WHEEL_SVG$$
        </svg>
      </div>
      <button class="nudge-btn" id="nudge-stbd" title="Stbd nudge — hold to extend (min 500 ms)" disabled>&#9654;</button>
    </div>
  </div>

  <!-- Settings gear button — only active while toggle is in OFF position -->
  <!-- DEBUG toggle button -->
  <div class="settings-footer">
    <button class="gear-btn" id="gear-btn" title="Settings (OFF mode only)">&#9881;</button>
    <button class="dbg-btn" id="dbg-btn" title="Toggle bridge debug logging">Debug</button>
    <!-- Alert panel: every warning / error / system message (plain wording).  Quiet when
         all is well.  Debug mode adds live link numbers and the software version. -->
    <div id="alert-oled"></div>
  </div>

  <!-- Product name (left) and software version (right), in black on the bottom edge -->
  <div class="remote-id">
    <span class="rid-name">Inno-Web-Remote</span>
    <span class="rid-ver" id="remote-ver">$$VERSION$$</span>
  </div>

</div><!-- .remote -->

<!-- Settings overlay -->
<div class="sov hidden" id="sov">
  <div class="spanel">
    <div class="shdr">
      <span class="shdr-title">&#9881; SETTINGS</span>
      <span class="shdr-hint">Tap a field to edit &nbsp;&bull;&nbsp; SAVE to apply</span>
      <span class="shdr-status" id="sov-status"></span>
    </div>
    <div class="sbody" id="sbody">

      <!-- Group 1: guided setup.  Dock-Side has its first step (rudder limits);
           Startup and Sea Trial are placeholders so the menu structure is in place. -->
      <div class="sg-title">SETUP WIZARDS</div>
      <div class="sf-row">
        <span class="sf-lbl" title="First-time setup: boat name and type, on-board Wi-Fi, and which sensors and options are fitted.">Startup Wizard &#9432;</span>
        <button class="sf-bb sf-soon" id="sf-wiz-start" style="padding:3px 10px" disabled>COMING SOON</button>
      </div>
      <div class="sf-row">
        <span class="sf-lbl" title="Done alongside the dock: rudder sensor and limits, motor power and speed, compass and gyro checks.">Dock-Side Wizard &#9432;</span>
        <button class="sf-bb" id="sf-wiz-dock" style="padding:3px 10px">OPEN</button>
      </div>
      <div class="sf-row">
        <span class="sf-lbl" title="Done under way: compass calibration and alignment, steering gains, off-course alarm.">Sea Trial Wizard &#9432;</span>
        <button class="sf-bb sf-soon" id="sf-wiz-sea" style="padding:3px 10px" disabled>COMING SOON</button>
      </div>

      <!-- Group 2: every individual setting, collapsed by default.
           Collapsing only hides rows; SAVE still collects and sends all fields. -->
      <div class="sg-title">ADVANCED SETTINGS</div>
      <div class="sf-row">
        <span class="sf-lbl">All Settings</span>
        <button class="sf-bb" id="sf-adv-toggle" style="padding:3px 14px">SHOW &#9662;</button>
      </div>
      <div class="sf-adv hidden" id="sf-adv">

      <div class="ss-title">NETWORK</div>
      <div class="sf-row" data-sfid="ip_mode">
        <span class="sf-lbl">IP Mode</span>
        <span class="sf-eval" id="sf-ip_mode">DHCP</span>
      </div>
      <div class="sf-row sf-hidden" data-sfid="ip">
        <span class="sf-lbl">IP Address</span>
        <input class="sf-inp" type="text" id="sf-ip" placeholder="192.168.x.x">
      </div>
      <div class="sf-row sf-hidden" data-sfid="mask">
        <span class="sf-lbl">Subnet Mask</span>
        <input class="sf-inp" type="text" id="sf-mask" placeholder="255.255.255.0">
      </div>
      <div class="sf-row sf-hidden" data-sfid="gateway">
        <span class="sf-lbl">Gateway</span>
        <input class="sf-inp" type="text" id="sf-gateway" placeholder="192.168.x.1">
      </div>
      <div class="sf-row sf-hidden" data-sfid="dns1">
        <span class="sf-lbl">DNS 1</span>
        <input class="sf-inp" type="text" id="sf-dns1" placeholder="8.8.8.8">
      </div>
      <div class="sf-row sf-hidden" data-sfid="dns2">
        <span class="sf-lbl">DNS 2</span>
        <input class="sf-inp" type="text" id="sf-dns2" placeholder="8.8.4.4">
      </div>

      <div class="ss-title">WI-FI</div>
      <div class="sf-row" data-sfid="ssid">
        <span class="sf-lbl">SSID</span>
        <input class="sf-inp" type="text" id="sf-ssid" placeholder="Network name">
      </div>
      <div class="sf-row" data-sfid="key">
        <span class="sf-lbl">Password</span>
        <input class="sf-inp" type="password" id="sf-key" placeholder="Wi-Fi key">
      </div>

      <div class="ss-title">VESSEL</div>
      <div class="sf-row" data-sfid="name">
        <span class="sf-lbl">Boat Name</span>
        <input class="sf-inp" type="text" id="sf-name" placeholder="My Boat">
      </div>
      <div class="sf-row" data-sfid="type">
        <span class="sf-lbl">Vessel Type</span>
        <span class="sf-eval" id="sf-type">SAIL</span>
      </div>
      <div class="sf-row" data-sfid="rudder_range_deg">
        <span class="sf-lbl">Rudder Range (&#176;)</span>
        <input class="sf-inp" type="number" id="sf-rudder_range_deg" min="10" max="100" step="1">
      </div>

      <div class="ss-title">CONNECTIONS &amp; FEATURES</div>
      <div class="sf-row" data-sfid="limit_switches">
        <span class="sf-lbl">Limit Switches</span>
        <div class="sf-bool">
          <button class="sf-bb" data-boolid="limit_switches" data-bval="true">ON</button>
          <button class="sf-bb" data-boolid="limit_switches" data-bval="false">OFF</button>
        </div>
      </div>
      <div class="sf-row" data-sfid="temp_sensor">
        <span class="sf-lbl">Temp Sensor</span>
        <div class="sf-bool">
          <button class="sf-bb" data-boolid="temp_sensor" data-bval="true">ON</button>
          <button class="sf-bb" data-boolid="temp_sensor" data-bval="false">OFF</button>
        </div>
      </div>
      <div class="sf-row" data-sfid="pi_voltage_sensor">
        <span class="sf-lbl">Pi Voltage</span>
        <div class="sf-bool">
          <button class="sf-bb" data-boolid="pi_voltage_sensor" data-bval="true">ON</button>
          <button class="sf-bb" data-boolid="pi_voltage_sensor" data-bval="false">OFF</button>
        </div>
      </div>
      <div class="sf-row" data-sfid="battery_voltage_sensor">
        <span class="sf-lbl">Battery Voltage</span>
        <div class="sf-bool">
          <button class="sf-bb" data-boolid="battery_voltage_sensor" data-bval="true">ON</button>
          <button class="sf-bb" data-boolid="battery_voltage_sensor" data-bval="false">OFF</button>
        </div>
      </div>
      <div class="sf-row" data-sfid="current_sensor">
        <span class="sf-lbl">Current Sensor</span>
        <div class="sf-bool">
          <button class="sf-bb" data-boolid="current_sensor" data-bval="true">ON</button>
          <button class="sf-bb" data-boolid="current_sensor" data-bval="false">OFF</button>
        </div>
      </div>
      <div class="sf-row" data-sfid="on_board_buttons">
        <span class="sf-lbl">On-Board Buttons</span>
        <div class="sf-bool">
          <button class="sf-bb" data-boolid="on_board_buttons" data-bval="true">ON</button>
          <button class="sf-bb" data-boolid="on_board_buttons" data-bval="false">OFF</button>
        </div>
      </div>
      <div class="sf-row" data-sfid="oled_sh1106">
        <span class="sf-lbl" title="Enable if the left-most column of pixels appears on the right edge of the screen. This switches the OLED driver from SSD1306 to SH1106 mode, which corrects the 2-pixel column offset used by some 1.3&quot; OLED modules.">OLED SH1106 Mode &#9432;</span>
        <div class="sf-bool">
          <button class="sf-bb" data-boolid="oled_sh1106" data-bval="true">ON</button>
          <button class="sf-bb" data-boolid="oled_sh1106" data-bval="false">OFF</button>
        </div>
      </div>
      <div class="sf-row" data-sfid="invert_clutch">
        <span class="sf-lbl" title="Enable if the clutch engages and disengages in reverse. This inverts the Nano pin 11 output level for builds where the clutch relay is wired active-LOW instead of active-HIGH.">Invert Clutch Signal &#9432;</span>
        <div class="sf-bool">
          <button class="sf-bb" data-boolid="invert_clutch" data-bval="true">ON</button>
          <button class="sf-bb" data-boolid="invert_clutch" data-bval="false">OFF</button>
        </div>
      </div>
      <div class="sf-row" data-sfid="invert_motor">
        <span class="sf-lbl" title="Enable if the rudder moves in the wrong direction. This will invert the H-bridge drive signals so port and starboard are swapped in hardware.">Invert Motor Direction &#9432;</span>
        <div class="sf-bool">
          <button class="sf-bb" data-boolid="invert_motor" data-bval="true">ON</button>
          <button class="sf-bb" data-boolid="invert_motor" data-bval="false">OFF</button>
        </div>
      </div>
      <div class="sf-row" data-sfid="remote_helm">
        <span class="sf-lbl" title="Allow the web remote to directly steer the rudder via the REMOTE button. Default OFF — enable only when actively helming from this screen.">Remote Helm Control &#9432;</span>
        <div class="sf-bool">
          <button class="sf-bb" data-boolid="remote_helm" data-bval="true">ON</button>
          <button class="sf-bb" data-boolid="remote_helm" data-bval="false">OFF</button>
        </div>
      </div>
      <div class="sf-row" data-sfid="helm_wheel_deg">
        <span class="sf-lbl" title="How far the on-screen helm wheel turns each way for full rudder. Smaller: less wheel turn per degree of rudder (less play, coarser). Larger: finer, but more wheel play. Default 90.">Helm Wheel Turn (&#177;&#176;) &#9432;</span>
        <input class="sf-inp" type="number" id="sf-helm_wheel_deg" min="30" max="360" step="10">
      </div>

      <div class="ss-title">AUTOPILOT</div>
      <div class="sf-row" data-sfid="deadband_pct">
        <span class="sf-lbl">Deadband (%)</span>
        <input class="sf-inp" type="number" id="sf-deadband_pct" min="0.5" max="20" step="0.5">
      </div>
      <div class="sf-row" data-sfid="pgain">
        <span class="sf-lbl">P-Gain</span>
        <input class="sf-inp" type="number" id="sf-pgain" min="0.1" max="5.0" step="0.1">
      </div>
      <div class="sf-row" data-sfid="off_course_alarm_deg">
        <span class="sf-lbl">Off-Course Alarm (&#176;)</span>
        <input class="sf-inp" type="number" id="sf-off_course_alarm_deg" min="5" max="90" step="1">
      </div>
      <div class="sf-row" data-sfid="rudder_limit_port_pct">
        <span class="sf-lbl">Port Limit (%)</span>
        <input class="sf-inp" type="number" id="sf-rudder_limit_port_pct" min="55" max="100" step="1">
      </div>
      <div class="sf-row" data-sfid="rudder_limit_stbd_pct">
        <span class="sf-lbl">Stbd Limit (%)</span>
        <input class="sf-inp" type="number" id="sf-rudder_limit_stbd_pct" min="0" max="45" step="1">
      </div>

      <div class="ss-title">SAFETY</div>
      <div class="sf-row" data-sfid="auto_disengage_on_fault">
        <span class="sf-lbl">Auto-Disengage</span>
        <div class="sf-bool">
          <button class="sf-bb" data-boolid="auto_disengage_on_fault" data-bval="true">ON</button>
          <button class="sf-bb" data-boolid="auto_disengage_on_fault" data-bval="false">OFF</button>
        </div>
      </div>
      <div class="sf-row" data-sfid="comms_warn_threshold_pct">
        <span class="sf-lbl">Comms WARN (%)</span>
        <input class="sf-inp" type="number" id="sf-comms_warn_threshold_pct" min="1" max="50" step="1">
      </div>
      <div class="sf-row" data-sfid="comms_crit_threshold_pct">
        <span class="sf-lbl">Comms CRIT (%)</span>
        <input class="sf-inp" type="number" id="sf-comms_crit_threshold_pct" min="5" max="90" step="1">
      </div>

      <div class="ss-title">NOTIFICATIONS</div>
      <div class="sf-row" data-sfid="health_interval_min">
        <span class="sf-lbl" title="0 = one health report at boot only. Set minutes for repeated reports with stats accumulated over the period.">Health Report (min) &#9432;</span>
        <input class="sf-inp" type="number" id="sf-health_interval_min" min="0" max="1440" step="5">
      </div>
      <div class="sf-row" data-sfid="ping_interval_s">
        <span class="sf-lbl" title="Seconds between Pi-to-router pings (1-30, standard 1). Automatically 0.5 while Debug is on. Increase if router rate-limits ICMP.">Ping Interval (s) &#9432;</span>
        <input class="sf-inp" type="number" id="sf-ping_interval_s" min="1" max="30" step="1">
      </div>

      <div class="ss-title">TESTS</div>
      <div class="sf-row">
        <span class="sf-lbl">Hardware Tests</span>
        <button class="sf-bb" id="settings-open-tests" style="padding:3px 14px">OPEN &#8250;</button>
      </div>

      <div class="ss-title">SYSTEM</div>
      <div class="sf-row">
        <span class="sf-lbl" title="Check GitHub for new commits and optionally install.">Software Update &#9432;</span>
        <button class="sf-bb" id="sf-check-update" style="padding:3px 14px">CHECK &#8250;</button>
      </div>

      </div><!-- #sf-adv -->

    </div><!-- .sbody -->
    <div class="sftr">
      <button class="sftr-btn sv"  id="sov-save">SAVE</button>
      <button class="sftr-btn cx" id="sov-cancel">CANCEL</button>
    </div>
  </div><!-- .spanel -->
</div><!-- .sov -->

<!-- TEST overlay -->
<div class="tov hidden" id="tov">
  <div class="tpanel">
    <div class="thdr">
      <span class="thdr-title" id="tov-title">&#x2697; HARDWARE TESTS</span>
      <span class="thdr-hint" id="tov-hint">Select a test to view description</span>
    </div>
    <div class="tbody" id="tbody">

      <!-- View 1: Test catalogue list (populated by JS) -->
      <div class="tcat-view" id="tcat-view"></div>

      <!-- View 2: Test detail + YES/NO confirm -->
      <div class="tdet-view" id="tdet-view">
        <div class="tdet-name"    id="tdet-name"></div>
        <div class="tdet-section">Description</div>
        <div class="tdet-text"    id="tdet-desc"></div>
        <div class="tdet-section">Purpose</div>
        <div class="tdet-text"    id="tdet-purpose"></div>
        <div class="tdet-section">Expected Output</div>
        <div class="tdet-text"    id="tdet-output"></div>
        <div class="tdet-section">Required Firmware</div>
        <div class="tdet-fw"      id="tdet-fw"></div>
        <div class="tdet-confirm">
          <button class="tdet-btn yes" id="tdet-yes">YES &mdash; RUN</button>
          <button class="tdet-btn no"  id="tdet-no">NO &mdash; BACK</button>
        </div>
      </div>

      <!-- View 2b: Rudder Sweep (RAM test) config -->
      <div class="tdet-view" id="tram-view">
        <div class="tdet-name">1. Rudder Sweep (commissioning)</div>
        <div class="tdet-section">What it does</div>
        <div class="tdet-text">Sweeps the rudder left and right between &#177;N&#176; of centre for a few cycles and measures how the steering responds. Uses the standard motor_simple firmware &#8212; no reflashing needed.</div>
        <div class="tdet-section">You must hold the button</div>
        <div class="tdet-text">After PROCEED, press and <b>HOLD</b> the B3 button on the remote for the whole run. Let go, drop the phone or lose the connection and the rudder stops where it is. The test cannot run unattended. Keep clear of the steering gear.</div>
        <div class="tdet-section">Sweep amplitude</div>
        <div style="display:flex;align-items:center;gap:10px;padding:6px 0 4px">
          <input type="number" id="ram-deg-inp" min="5" max="35" value="20"
                 style="width:64px;background:#080f20;border:1px solid #1e3450;border-radius:4px;color:#00d4ff;font-family:'Courier New',monospace;font-size:.95em;padding:4px 6px;outline:none;text-align:center">
          <span style="color:#90a8c0;font-size:.78em">degrees each side of centre<br><span id="ram-deg-hint" style="color:#354860"></span></span>
        </div>
        <div class="tdet-section">Cycles</div>
        <div style="display:flex;align-items:center;gap:10px;padding:6px 0 10px">
          <input type="number" id="ram-cyc-inp" min="1" max="10" value="3"
                 style="width:64px;background:#080f20;border:1px solid #1e3450;border-radius:4px;color:#00d4ff;font-family:'Courier New',monospace;font-size:.95em;padding:4px 6px;outline:none;text-align:center">
          <span style="color:#90a8c0;font-size:.78em">full port + stbd cycles (1&#8211;10)</span>
        </div>
        <div class="tdet-confirm">
          <button class="tdet-btn yes" id="tram-yes">PROCEED</button>
          <button class="tdet-btn no"  id="tram-no">BACK</button>
        </div>
      </div>

      <!-- View 3: Results / output streaming -->
      <div class="tres-view" id="tres-view">
        <div class="tres-name"   id="tres-name"></div>
        <div class="tres-log"    id="tres-log"></div>
        <div class="tres-status" id="tres-status">WAITING&hellip;</div>
        <button class="tres-b3"  id="tres-b3">SEND B3 (TRIGGER)</button>
      </div>

    </div><!-- .tbody -->
    <div class="tftr">
      <button class="tftr-btn back"  id="tov-back"  style="display:none">&#8592; BACK</button>
      <button class="tftr-btn close" id="tov-close">CLOSE</button>
    </div>
  </div><!-- .tpanel -->
</div><!-- .tov -->

<!-- Dock-Side Wizard overlay.  Step 1 (rudder sensor + limits by hand) is built;
     later steps are listed as coming soon.  Nothing on this page moves the rudder. -->
<div class="tov hidden" id="wov">
  <div class="tpanel">
    <div class="thdr">
      <span class="thdr-title">&#9875; DOCK-SIDE WIZARD</span>
      <span class="thdr-hint">Step 1: rudder sensor &amp; limits &mdash; by hand</span>
    </div>
    <div class="tbody">
      <div class="wz-rud" id="wz-rud">Rudder --</div>
      <div class="wz-stat bad" id="wz-stat">Limits: unknown</div>

      <div class="tdet-section">Before you start</div>
      <div class="tdet-text">Autopilot in standby. Release the clutch (or open the bypass valve) so you can turn the wheel or tiller by hand. Nothing in this step moves the rudder. Until the limits are set, the autopilot, REMOTE steering, jog and sweep are all refused.</div>

      <div class="tdet-section">1. Rudder angle at the stops</div>
      <div class="wz-row">
        <input class="wz-inp" type="number" id="wz-range" min="10" max="100" step="1">
        <span class="wz-lbl">degrees each side. Measure it if you can; this is what the stops will read.</span>
        <button class="wz-btn" id="wz-range-set" style="min-width:56px">SET</button>
      </div>

      <div class="tdet-section">2. Capture &mdash; hold the rudder still for 1 s</div>
      <div class="wz-row"><span class="wz-lbl">Rudder straight (centre)</span>
        <button class="wz-btn" id="wz-cap-CENTRE">CENTRE</button></div>
      <div class="wz-row"><span class="wz-lbl">Hard against the PORT stop</span>
        <button class="wz-btn" id="wz-cap-PORT">PORT STOP</button></div>
      <div class="wz-row"><span class="wz-lbl">Hard against the STARBOARD stop</span>
        <button class="wz-btn" id="wz-cap-STBD">STBD STOP</button></div>

      <div class="tdet-section">3. Check</div>
      <div class="tdet-text">Turn the wheel a little to port: the reading above must show P and grow. Centre must read close to 0. If not, capture again.</div>

      <div class="tdet-section">4. Soft limits (inside the stops)</div>
      <div class="wz-row">
        <span class="wz-lbl">Port</span><input class="wz-inp" type="number" id="wz-lim-port" step="0.5">
        <span class="wz-lbl">Stbd</span><input class="wz-inp" type="number" id="wz-lim-stbd" step="0.5">
      </div>
      <div class="tdet-confirm"><button class="tdet-btn yes" id="wz-save">SAVE LIMITS</button></div>
      <div class="wz-msg" id="wz-msg"></div>

      <div class="tdet-section">Coming next</div>
      <div class="wz-next">Motor direction &amp; clutch &bull; Minimum motor power &bull; Coast &amp; rudder speed &bull; Motor current &bull; Steering tolerance (sweep) &bull; Compass &amp; gyro checks &bull; Remote range &bull; STOP from every source</div>
    </div>
    <div class="tftr">
      <button class="tftr-btn close" id="wov-close">CLOSE</button>
    </div>
  </div>
</div>

<!-- Software update modal -->
<div id="upd-overlay" class="upd-overlay">
  <div class="upd-box" id="upd-box">
    <div class="upd-title">Software Update</div>
    <div id="upd-body" class="upd-body">Checking...</div>
    <pre id="upd-log"></pre>
    <div class="upd-actions">
      <button class="upd-btn upd-install" id="upd-install">INSTALL</button>
      <button class="upd-btn upd-close"   id="upd-close">CLOSE</button>
    </div>
  </div>
</div>

<!-- Boat-name setup modal: shown on load when vessel.name is not configured -->
<div id="bnm-overlay" class="bnm-overlay">
  <div class="bnm-box">
    <div class="bnm-title">Welcome to Inno-Pilot</div>
    <div class="bnm-body">Enter your boat name to continue.<br>
      This identifies your vessel in all notifications.</div>
    <input class="bnm-inp" type="text" id="bnm-input"
           placeholder="e.g. Windseeker" maxlength="32" autocomplete="off">
    <div class="bnm-err" id="bnm-err"></div>
    <button class="bnm-btn" id="bnm-save">SAVE</button>
  </div>
</div>

<script>
'use strict';

// ── Shared state ──────────────────────────────────────────────────────────
var gMode      = 'IDLE';
var gConnected = false;
var gApOn      = false;      // true when AP is actually engaged (d.ap === 1)
var gTogglePos = 'on';       // mode radio position: 'auto' | 'remote' | 'on' | 'off'
var gHdg       = null;       // latest heading from bridge telemetry (degrees)
var gCmd       = null;       // latest AP heading command from bridge telemetry (degrees)
var wheelAngle = 0;      // accumulated rotation in degrees, clamped to ±MAX_DEG
var isDragging = false;
var prevPtrAngle = null;
var lastRudSend  = 0;
var lastRudSentPct = null;  // last RUD value actually sent
var rudTrailTimer  = null;  // pending trailing send (A: never drop the final position)
var MAX_DEG = 90;        // ±MAX_DEG of wheel maps 0..100% rudder; set from the
                         // "Helm Wheel Turn" setting (features.helm_wheel_deg)
var HELM_WHEEL_DEFAULT = 90, HELM_WHEEL_MIN = 30, HELM_WHEEL_MAX = 360;
var gManualRudPct = 50.0;  // commanded rudder % in MANUAL mode (0–100%)
var gRdrPct       = null;  // latest rdr_pct from bridge telemetry
var gJogTimer     = null;  // setInterval handle for hold-jog repeat
var gHdgLastSeen  = Date.now();  // timestamp of last non-null HDG from bridge (grace period on load)
var gJogHoldTimer = null;  // setTimeout handle for jog hold-delay
var gSettings     = {};    // settings loaded from /settings endpoint
var gDebugActive  = false; // true when bridge is in DEBUG log level
var gProgressES   = null;  // EventSource for /update/progress SSE stream
var gSettingsOpen = false; // true while settings panel is visible
var gTestOpen     = false; // true while test modal is visible
var gSelectedTest = null;  // id of test currently shown in detail/results view
var gTestRunning  = false; // true while a test is streaming results
var gRamTestDeg   = 20;    // last configured rudder sweep amplitude (degrees)
var gRamCycles    = 3;     // last configured rudder sweep cycle count
var gRamHoldTimer = null;  // dead-man heartbeat interval while B3 is held

// ── Command sender ────────────────────────────────────────────────────────
function sendCmd(cmd) {
  return fetch('/command', {
    method: 'POST',
    headers: {'Content-Type': 'application/json'},
    body: JSON.stringify({cmd: cmd})
  }).then(function(resp) {
    return resp.json().catch(function() { return {}; }).then(function(body) {
      return {ok: resp.ok, status: resp.status, body: body};
    });
  }).catch(function() {
    return {ok: false, status: 0, body: {}};
  });
}


// ── Hardware test catalogue ───────────────────────────────────────────────
// Only entries with available:true can be selected and run.  Tests 2-9 need
// the bench firmware pwm_test.ino, which has no run-time "TEST <id>" dispatcher
// and never emits TEST_LINE/TEST_DONE, so on the boat (motor_simple flashed)
// they could never run.  They stay listed, greyed out, as a reference until
// the bench-firmware integration is built (see TODO.md).
var TESTS = [
  { id: 1,
    available: true,
    name: 'Rudder Sweep (commissioning)',
    desc: 'Sweeps the rudder between \u00b1N\u00b0 of centre for a few cycles while you HOLD the B3 button. Let go and it stops. Runs on the standard motor_simple firmware \u2014 no reflashing needed.',
    purpose: 'Check the steering is fit for autopilot use, and measure it: rudder speed each way, reversal lag, overshoot and end position, motor current (if a sensor is fitted).',
    output: 'Results table at the end: speed and est. hard-over time per side, lag, overshoot, end error, current, port/stbd speed difference. PASS / CHECK / STOPPED.',
    fw: 'motor_simple.ino (standard firmware \u2014 already flashed)',
    trigger: 'Hold B3 for the whole run (dead-man)'
  },
  { id: 2,
    name: 'Binary Search \u2014 Min Starting PWM',
    desc: 'Bisects the PWM range (0\u2013255) in both STBD and PORT directions to find the lowest duty cycle that actually moves the rudder from standstill.',
    purpose: 'Establish the motor deadband floor. Below this PWM the hydraulic valve does not crack open. Required before any closed-loop control tuning.',
    output: 'MIN_STBD and MIN_PORT PWM thresholds with motor current at each threshold. Example: MIN_STBD=118  MIN_PORT=122  CURRENT=0.8A',
    fw: 'pwm_test.ino  (default compile \u2014 no extra #define)',
    trigger: 'Automatic on power-up'
  },
  { id: 3,
    name: 'Speed Sweep',
    desc: 'Drives the rudder at fixed PWM steps (100 \u2192 255, \u223c15 per step) for 600 ms each. Records counts/second and motor current at each step.',
    purpose: 'Map motor speed as a function of PWM. Used to build the braking-time lookup table and characterise the full actuator range.',
    output: 'Table with \u223c10 rows: PWM | cps (counts/s) | amps.',
    fw: 'pwm_test.ino  (default compile \u2014 no extra #define)',
    trigger: 'Automatic'
  },
  { id: 4,
    name: 'Coast / Ramp-Down Test',
    desc: 'For PWM 150, 190, and 255: (A) hard-cuts the motor at a trigger point and measures overshoot; (B) applies a proportional ramp-down and measures the improvement side-by-side.',
    purpose: 'Quantify overshoot from hard-cut versus speed-proportional ramp braking. Determines whether ramp braking is worth implementing for this vessel.',
    output: '3 rows: PWM | coast_counts | hard_error | ramp_error. Side-by-side comparison for each speed.',
    fw: 'pwm_test.ino  (default compile \u2014 no extra #define)',
    trigger: 'Automatic'
  },
  { id: 5,
    name: 'Comprehensive Characterisation Table',
    desc: 'For each of 15 PWM levels (120 \u2192 255): measures coast count on hard-cut, minimum pulse width (binary search), speed (cps), and reverse-brake ms needed for dead-stop.',
    purpose: 'Produce the master reference table. This is the single most important calibration run \u2014 its output feeds all control algorithm parameters.',
    output: '15-row table: PWM | coast_ms | min_pulse_ms | cps | brake_ms. Full hydraulic characterisation for this vessel.',
    fw: 'pwm_test.ino  (default compile \u2014 no extra #define)',
    trigger: 'Automatic'
  },
  { id: 6,
    name: 'Interactive Target Test',
    desc: 'Drives 450-count runs alternating STBD/PORT (6 total). B3 triggers each run. Two algorithms: ALG 0 = hard-cut baseline; ALG 1 = speed-aware braking (replica of motor_simple B5). Reports overshoot, drive time, speed at brake trigger, brake ms used.',
    purpose: 'Validate the closed-loop stopping algorithm against a fixed target under realistic conditions. Directly measures real-world overshoot.',
    output: '6 rows: dir | target | actual | overshoot | drive_ms | brake_ms | speed@trigger.',
    fw: 'pwm_test.ino  #define RUN_INTERACTIVE_TEST',
    trigger: 'B3 button to start each run'
  },
  { id: 7,
    name: 'Burst Sweep Test',
    desc: '24 burst durations (10\u2013600 ms) \xd7 2 directions = 48 fully automatic runs after one B3 press. PWM=255, hard-cut. Records ADC start/final and net counts per burst.',
    purpose: 'Map the hydraulic cracking threshold \u2014 below what pulse duration does the rudder not move? Reveals burst duration vs. displacement relationship.',
    output: '48 rows: dir | duration_ms | start_adc | final_adc | net_counts. Identifies minimum effective pulse width.',
    fw: 'pwm_test.ino  #define RUN_BURST_SWEEP_TEST',
    trigger: 'B3 once to start \u2014 then fully automatic'
  },
  { id: 8,
    name: 'Fine Burst Test',
    desc: 'Steps 15\u201325 ms in 1 ms increments, 10 reps per step, both directions. PWM=255, hard-cut. Characterises fine-pulse resolution at the low end of burst duration.',
    purpose: 'Find the minimum repeatable pulse that moves the rudder by at least 1 ADC count. Critical for precision micro-corrections in closed-loop control.',
    output: '220 rows (10 reps \xd7 11 steps \xd7 2 dirs): dir | duration_ms | counts_moved. Statistical view of fine-pulse repeatability.',
    fw: 'pwm_test.ino  #define RUN_FINE_BURST_TEST',
    trigger: 'B3 once to start \u2014 then fully automatic'
  },
  { id: 9,
    name: 'Remote Control Test (RCT)',
    desc: 'Bridge-integrated positioning trial with 3 sub-modes: ADJUST (B2/B4 scroll settings, B1/B5 change value, B3 save); TEST (bridge sends TGT <pct>, Nano chases target using 7 RCT settings); RATIFY (real-time remote steering). Settings persist to EEPROM.',
    purpose: 'End-to-end validation of the full closed-loop positioning system from web remote through bridge to Nano, including EEPROM-persisted tuning parameters.',
    output: 'Real-time telemetry: TGT | RDR_PCT | overshoot | PWM. EEPROM parameter dump on ADJUST save. B3 cycles: ADJUST \u2192 TEST \u2192 RATIFY.',
    fw: 'pwm_test.ino  #define RUN_REMOTE_CONTROL_TEST  (bridge-integrated \u2014 full TCP protocol)',
    trigger: 'B3 cycles modes; B1/B2/B4/B5 adjust parameters'
  }
];

// ── Debug toggle ──────────────────────────────────────────────────────────

function setDebugState(active) {
  gDebugActive = !!active;
  var btn = document.getElementById('dbg-btn');
  btn.textContent = gDebugActive ? 'Debugging' : 'Debug';
  btn.classList.toggle('dbg-active', gDebugActive);
  if (typeof linkRender === 'function') linkRender();
}

function toggleDebug() {
  fetch('/debug', { method: 'POST' })
    .then(function(r) { return r.json(); })
    .then(function(d) { if (d.debug !== undefined) setDebugState(d.debug); })
    .catch(function() {});  // silently ignore network errors
}

// ── Test modal functions ──────────────────────────────────────────────────

function openTestMenu() {
  gTestOpen = true;
  document.getElementById('tov').classList.remove('hidden');
  showTestCatalogue();
}

function closeTestMenu() {
  gTestOpen     = false;
  gTestRunning  = false;
  gSelectedTest = null;
  document.getElementById('tov').classList.add('hidden');
  document.getElementById('tram-view').classList.remove('active');
}

function showTestCatalogue() {
  document.getElementById('tov-title').textContent = '\u2697 HARDWARE TESTS';
  document.getElementById('tov-hint').textContent  = 'Select a test to view description';
  document.getElementById('tram-view').classList.remove('active');
  // Populate catalogue list on first call (idempotent)
  var catView = document.getElementById('tcat-view');
  catView.innerHTML = '';
  TESTS.forEach(function(t) {
    var item = document.createElement('div');
    if (!t.available) {
      // Greyed out: shown for reference only, no click/touch handlers.
      item.className = 'tcat-item tcat-off';
      item.innerHTML =
        '<span class="tcat-num">' + t.id + '</span>' +
        '<span class="tcat-name">' + t.name + '</span>' +
        '<span class="tcat-na">BENCH FIRMWARE<br>NOT AVAILABLE</span>';
      catView.appendChild(item);
      return;
    }
    item.className = 'tcat-item';
    item.innerHTML =
      '<span class="tcat-num">' + t.id + '</span>' +
      '<span class="tcat-name">' + t.name + '</span>' +
      '<span class="tcat-arrow">\u203a</span>';
    item.addEventListener('click', function() { selectTest(t.id); });
    item.addEventListener('touchstart', function(e) {
      e.preventDefault(); selectTest(t.id);
    }, {passive: false});
    catView.appendChild(item);
  });
  catView.classList.remove('hidden');
  document.getElementById('tdet-view').classList.remove('active');
  document.getElementById('tres-view').classList.remove('active');
  document.getElementById('tov-back').style.display = 'none';
}

function showRamTestConfig() {
  gSelectedTest = 1;
  var rng = (gSettings && gSettings.vessel && gSettings.vessel.rudder_range_deg)
            ? gSettings.vessel.rudder_range_deg : 35;
  document.getElementById('ram-deg-inp').max   = rng;
  document.getElementById('ram-deg-inp').value = Math.min(gRamTestDeg, rng);
  document.getElementById('ram-cyc-inp').value = gRamCycles;
  document.getElementById('ram-deg-hint').textContent = 'min 5°, max ' + rng + '° (travel limit)';
  document.getElementById('tov-title').textContent = 'Rudder Sweep';
  document.getElementById('tov-hint').textContent  = 'Set amplitude and cycles, then PROCEED';
  document.getElementById('tcat-view').classList.add('hidden');
  document.getElementById('tdet-view').classList.remove('active');
  document.getElementById('tres-view').classList.remove('active');
  document.getElementById('tram-view').classList.add('active');
  document.getElementById('tov-back').style.display = '';
}

function selectTest(id) {
  if (id === 1) { showRamTestConfig(); return; }
  var t = TESTS.find(function(x) { return x.id === id; });
  if (!t || !t.available) return;   // greyed-out tests cannot be opened
  gSelectedTest = id;
  document.getElementById('tdet-name').textContent    = t.id + '.  ' + t.name;
  document.getElementById('tdet-desc').textContent    = t.desc;
  document.getElementById('tdet-purpose').textContent = t.purpose;
  document.getElementById('tdet-output').textContent  = t.output;
  document.getElementById('tdet-fw').textContent      = t.fw;
  document.getElementById('tov-title').textContent    = 'TEST ' + t.id;
  document.getElementById('tov-hint').textContent     = 'Trigger: ' + t.trigger;
  document.getElementById('tcat-view').classList.add('hidden');
  document.getElementById('tdet-view').classList.add('active');
  document.getElementById('tres-view').classList.remove('active');
  document.getElementById('tov-back').style.display = '';
}

function runTest(id) {
  var t = TESTS.find(function(x) { return x.id === id; });
  if (!t || !t.available) return;   // never send TEST <id> for an unavailable test
  gTestRunning = true;
  document.getElementById('tres-name').textContent   = t.id + '.  ' + t.name;
  document.getElementById('tres-log').textContent    = '';
  document.getElementById('tres-status').textContent = 'Sending TEST ' + id + ' to Nano\u2026';
  // Show B3 button for tests that require it (ids 6-8 after renumber)
  var needsB3 = (id >= 6);
  document.getElementById('tres-b3').classList.toggle('visible', needsB3);
  document.getElementById('tdet-view').classList.remove('active');
  document.getElementById('tres-view').classList.add('active');
  document.getElementById('tov-back').style.display = 'none';
  // Forward TEST command through bridge to Nano
  sendCmd('TEST ' + id);
}

function appendTestLine(line) {
  if (!gTestOpen) return;
  var log = document.getElementById('tres-log');
  if (!log) return;
  log.textContent += line + '\\n';
  log.scrollTop = log.scrollHeight;
  document.getElementById('tres-status').textContent = 'RUNNING\u2026';
}

function testDone() {
  gTestRunning = false;
  var status = document.getElementById('tres-status');
  if (status) status.textContent = 'TEST COMPLETE';
  document.getElementById('tres-b3').classList.remove('visible');
  document.getElementById('tov-back').style.display = '';
}

// ── Rudder sweep (RAM test): dead-man hold + results ─────────────────────
// While B3 is held in a sweep mode the browser sends "RAM HOLD" every 200 ms.
// The bridge stops the sweep if no HOLD arrives for 1 s, so ANY way the
// heartbeat stops (finger lifted, phone dropped/locked, tab hidden, page
// closed, WiFi lost) ends the test.  RAM RELEASE just makes a clean lift-off
// stop immediately instead of after the timeout.  The heartbeat must come from
// the browser: the web remote server stays connected to the bridge even when
// the phone is gone, so the bridge connection alone cannot detect that.
var RAM_HOLD_PERIOD_MS = 200;

function isRamMode() { return gMode === 'RAM_OFF' || gMode === 'RAM_ON'; }

function ramHoldStart() {
  if (gRamHoldTimer !== null) return;          // already holding
  sendCmd('RAM HOLD');
  gRamHoldTimer = setInterval(function() {
    if (!isRamMode()) { ramHoldStop(); return; }  // sweep ended on the bridge
    sendCmd('RAM HOLD');
  }, RAM_HOLD_PERIOD_MS);
}

function ramHoldStop() {
  if (gRamHoldTimer === null) return;
  clearInterval(gRamHoldTimer);
  gRamHoldTimer = null;
  sendCmd('RAM RELEASE');
}

// Losing the page's attention is the same as letting go.
document.addEventListener('visibilitychange', function() {
  if (document.hidden) ramHoldStop();
});
window.addEventListener('pagehide', ramHoldStop);
window.addEventListener('blur', ramHoldStop);

// ── REMOTE steering dead-man (2026-10-15) ───────────────────────────────────
// While the bridge is in REMOTE steering (mode MANUAL) the page sends "ALIVE"
// every 400 ms.  The bridge stops REMOTE steering, raises STEER_LOSS and sounds
// the Nano's warning if no ALIVE arrives for 1.5 s.  Like RAM HOLD, the
// heartbeat must come from the browser: the web remote server stays connected
// to the bridge when the phone is gone.
// A hidden page (screen auto-lock, app switch, tab closed) deliberately stops
// the heartbeat rather than sending a clean MODE AUTO: nobody is watching the
// wheel, and a screen that timed out on its own must ALERT the skipper that
// steering stopped, not stop it silently.  Coming back within 1.5 s (a quick
// glance at another app) keeps REMOTE steering without interruption.
// Exception since v3.3.2: touches on the wheel send "ALIVE T" whatever the
// hidden flag says (aliveFromTouch below) — a finger on the wheel is a skipper.
// blur is NOT treated as loss here (unlike RAM HOLD / NUDGE): the page is still
// visible and its timers keep running, so the heartbeat continues.
// Only the page that SELECTED REMOTE sends it (gRemoteOwner): every open page
// sees mode MANUAL, and a second phone lying in the cabin must not keep REMOTE
// alive after the helmsman's phone has gone.  Reloading the page gives up
// ownership (= leaving REMOTE).  Ownership lapses once the bridge has left
// MANUAL; the 3 s grace covers the gap between the click and the first
// telemetry showing MANUAL.
var REMOTE_ALIVE_PERIOD_MS = 400;
var gRemoteOwner      = false;
var gRemoteOwnerSince = 0;
var gLastAliveSent    = 0;   // Date.now() of the last ALIVE sent (timer or touch)
var gAliveTickLast    = 0;   // Date.now() of the previous heartbeat timer tick
var gLastTouchMs      = 0;   // Date.now() of the last touch/drag event on the wheel
function claimRemote() { gRemoteOwner = true; gRemoteOwnerSince = Date.now(); }
setInterval(function() {
  var now = Date.now();
  // v3.3.2: a heartbeat tick that comes far too late means the browser paused
  // this page; report it (see pageEvent) while REMOTE is in use.
  var late = gAliveTickLast ? now - gAliveTickLast - REMOTE_ALIVE_PERIOD_MS : 0;
  gAliveTickLast = now;
  if (late > 600 && gMode === 'MANUAL' && gRemoteOwner) pageEvent('timer_late', {late_ms: late});
  if (gMode !== 'MANUAL') {
    if (gRemoteOwner && now - gRemoteOwnerSince > 3000) gRemoteOwner = false;
    return;
  }
  if (gRemoteOwner && !document.hidden) { sendCmd('ALIVE'); gLastAliveSent = now; }
}, REMOTE_ALIVE_PERIOD_MS);

// ── Touch heartbeat (v3.3.2) ───────────────────────────────────────────────
// 2026-10-21, Samsung S20 + Chrome: while the skipper held the wheel for several
// seconds, Chrome paused this page's timers (~1.5 s) and then reported the page
// hidden although it stayed on screen, so the timer heartbeat stopped and REMOTE
// ended with STEER LOSS.  A touch on the wheel is direct proof that the skipper is
// there, so wheel touches send "ALIVE T" as well — even if Chrome claims the page
// is hidden (user decision 2026-10-21).  A locked or unattended screen produces
// no touches, so the 1.5 s dead-man still catches it.  Only kicks in when the
// timer has not sent one for a while, so a healthy page sends no extra traffic.
function aliveFromTouch() {
  gLastTouchMs = Date.now();
  if (gMode !== 'MANUAL' || !gRemoteOwner) return;
  if (gLastTouchMs - gLastAliveSent < REMOTE_ALIVE_PERIOD_MS + 100) return;
  gLastAliveSent = gLastTouchMs;
  sendCmd('ALIVE T');
}

// ── Page lifecycle log (v3.3.2) ─────────────────────────────────────────────
// Reports what the browser does to this page (hidden/visible, frozen/resumed,
// focus lost, late timers) to the Pi's journal (POST /pageevent), so the next
// unexplained STEER LOSS names its cause.  sendBeacon still delivers while the
// page is being hidden.  Focus changes are only reported while in REMOTE.
function pageEvent(kind, extra) {
  var d = {ev: kind, vis: document.visibilityState, focus: document.hasFocus(),
           mode: gMode, owner: gRemoteOwner, drag: isDragging,
           touch_ms: gLastTouchMs ? Date.now() - gLastTouchMs : -1};
  if (extra) for (var k in extra) d[k] = extra[k];
  var body = JSON.stringify(d);
  try {
    if (navigator.sendBeacon &&
        navigator.sendBeacon('/pageevent', new Blob([body], {type: 'application/json'}))) return;
  } catch (e) {}
  fetch('/pageevent', {method: 'POST', headers: {'Content-Type': 'application/json'},
                       body: body, keepalive: true}).catch(function() {});
}
document.addEventListener('visibilitychange', function() { pageEvent('visibility'); });
document.addEventListener('freeze', function() { pageEvent('freeze'); });
document.addEventListener('resume', function() { pageEvent('resume'); });
window.addEventListener('pagehide', function() { pageEvent('pagehide'); });
window.addEventListener('pageshow', function() { pageEvent('pageshow'); });
window.addEventListener('blur',  function() { if (gMode === 'MANUAL') pageEvent('blur'); });
window.addEventListener('focus', function() { if (gMode === 'MANUAL') pageEvent('focus'); });

function ramFmt(v, unit) { return (v === null || v === undefined) ? '  --' : String(v) + (unit || ''); }

function showRamResult(r) {
  ramHoldStop();
  var lines = [];
  var res = r.result || '?';
  if (res === 'REFUSED' || res === 'DISARMED') {
    lines.push((res === 'REFUSED' ? 'Not started: ' : 'Disarmed: ') + (r.reason || ''));
  } else {
    var P = (r.dirs && r.dirs.port) || {}, S = (r.dirs && r.dirs.stbd) || {};
    var pad = function(t, n) { t = String(t); while (t.length < n) t = ' ' + t; return t; };
    var row = function(lbl, k, unit) {
      var l = lbl; while (l.length < 14) l += ' ';
      return l + pad(ramFmt(P[k], unit), 9) + pad(ramFmt(S[k], unit), 9);
    };
    var finished = (res === 'PASS' || res === 'CHECK');
    lines.push((finished ? 'Finished: ' : 'Stopped because: ') + (r.reason || '?'));
    lines.push('Sweep \u00b1' + r.deg + '\u00b0 of \u00b1' + r.range_deg + '\u00b0  strokes ' +
               r.strokes + '/' + r.strokes_req);
    lines.push('');
    lines.push('              TO PORT  TO STBD');
    lines.push(row('Speed \u00b0/s',    'speed_dps'));
    lines.push(row('Hard-over s',   'hard_over_s'));
    lines.push(row('Lag ms',        'lag_ms'));
    lines.push(row('Overshoot \u00b0',  'overshoot_max_deg'));
    lines.push(row('End error \u00b0',  'end_err_deg'));
    lines.push(row('Settle t/o',    'settle_timeouts'));
    if (P.i_peak_a !== null && P.i_peak_a !== undefined) {
      lines.push(row('Current pk A', 'i_peak_a'));
      lines.push(row('Current avg A','i_mean_a'));
    }
    lines.push('');
    lines.push('Port/stbd speed difference: ' + ramFmt(r.speed_asym_pct, '%'));
    if (r.nano_angle) lines.push('Nano steered on: ' + r.nano_angle + ' rudder angle');
    if (r.nano_deadband_deg !== undefined) {
      lines.push('Steering deadband: \u00b1' + r.nano_deadband_deg + '\u00b0 (rudder stops anywhere');
      lines.push('  within it of the target \u2014 shows as End error)');
    }
    lines.push('');
    lines.push('Hard-over = est. full lock-to-lock time at the measured speed.');
    lines.push('Overshoot = worst travel past the end target.');
    lines.push('End error = average final position vs target (- = short).');
  }
  gTestOpen = true;
  gTestRunning = false;
  document.getElementById('tov').classList.remove('hidden');
  document.getElementById('tov-title').textContent = 'Rudder Sweep';
  document.getElementById('tov-hint').textContent  = 'Results (also written to the event log)';
  document.getElementById('tcat-view').classList.add('hidden');
  document.getElementById('tdet-view').classList.remove('active');
  document.getElementById('tram-view').classList.remove('active');
  document.getElementById('tres-view').classList.add('active');
  document.getElementById('tres-b3').classList.remove('visible');
  document.getElementById('tres-name').textContent = '1.  Rudder Sweep (commissioning)';
  document.getElementById('tres-log').textContent = lines.join('\\n');
  document.getElementById('tres-status').textContent = res;
  document.getElementById('tov-back').style.display = '';
}

// Test button and modal event wiring
document.getElementById('dbg-btn').addEventListener('click', toggleDebug);
document.getElementById('dbg-btn').addEventListener('touchstart', function(e) {
  e.preventDefault(); toggleDebug();
}, {passive: false});
document.getElementById('tov-close').addEventListener('click', closeTestMenu);
document.getElementById('tov-back').addEventListener('click', function() {
  // Back always returns to catalogue (from detail or results)
  showTestCatalogue();
});
document.getElementById('tdet-yes').addEventListener('click', function() {
  if (gSelectedTest) runTest(gSelectedTest);
});
document.getElementById('tdet-no').addEventListener('click', showTestCatalogue);
document.getElementById('tram-no').addEventListener('click', showTestCatalogue);
document.getElementById('tram-yes').addEventListener('click', function() {
  var rng = (gSettings && gSettings.vessel && gSettings.vessel.rudder_range_deg)
            ? gSettings.vessel.rudder_range_deg : 35;
  var deg = parseInt(document.getElementById('ram-deg-inp').value, 10) || 20;
  deg = Math.max(5, Math.min(deg, rng));
  var cyc = parseInt(document.getElementById('ram-cyc-inp').value, 10) || 3;
  cyc = Math.max(1, Math.min(cyc, 10));
  gRamTestDeg = deg;
  gRamCycles  = cyc;
  closeTestMenu();
  // Switch toggle to auto (reconnects if Settings left us OFF).  RAM_SETUP is
  // chained AFTER MODE AUTO: two parallel fetches may arrive in either order,
  // and a MODE command reaching the bridge after arming would disarm it.
  var arm = function() { sendCmd('RAM_SETUP ' + deg + ' ' + cyc); };
  if (gTogglePos !== 'auto') {
    Promise.resolve(handleToggleAction('auto')).then(arm);
  } else {
    arm();
  }
});
document.getElementById('tres-b3').addEventListener('click', function() {
  // Send B3 (BTN TOGGLE) — trigger for tests 5, 6, 7
  sendCmd('BTN TOGGLE');
});

// ── Dock-Side Wizard, step 1: rudder sensor + limits by hand ──────────────
// Sends LIMITS RANGE / CAPTURE / SET; the bridge does every check and reports
// back in the LIMITS telemetry (d.limits).  The page only displays.
var gWizOpen = false;
var gWizFilled = false;     // inputs pre-filled once per opening (do not fight typing)

function openDockWizard() {
  _doClosePanel();                 // leave Settings without saving
  gWizOpen = true;
  gWizFilled = false;
  document.getElementById('wz-msg').textContent = '';
  document.getElementById('wov').classList.remove('hidden');
  // Observer mode: connected for live readings, nothing steering.
  handleToggleAction('on');
  setToggle('on');
}

function closeDockWizard() {
  gWizOpen = false;
  document.getElementById('wov').classList.add('hidden');
}

function wizRender(d) {
  var L = d.limits;
  var rud = document.getElementById('wz-rud');
  if (d.rdr === null || d.rdr === undefined || !d.connected) {
    rud.textContent = 'Rudder --';
  } else {
    var side = d.rdr > 0.05 ? 'P ' : (d.rdr < -0.05 ? 'S ' : '');
    rud.textContent = 'Rudder ' + side + Math.abs(d.rdr).toFixed(1) + '\u00b0';
  }
  var st = document.getElementById('wz-stat');
  if (!L) {
    st.className = 'wz-stat bad';
    st.textContent = d.connected ? 'Limits: waiting for the autopilot\u2026' : 'Not connected to the autopilot';
    return;
  }
  if (L.ok) {
    st.className = 'wz-stat ok';
    st.textContent = 'Limits SET: port ' + L.port_deg + '\u00b0, starboard ' + L.stbd_deg +
                     '\u00b0 (stops \u00b1' + Math.round(L.range) + '\u00b0)';
  } else {
    st.className = 'wz-stat bad';
    st.textContent = 'Limits NOT SET: ' + L.reason + (L.cal_problem ? '\\nCalibration: ' + L.cal_problem : '');
  }
  ['CENTRE', 'PORT', 'STBD'].forEach(function(p) {
    var b = document.getElementById('wz-cap-' + p);
    var done = (L.done || []).indexOf(p) >= 0;
    b.classList.toggle('done', done);
    b.disabled = !!L.capturing;
    b.textContent = (L.capturing === p ? 'HOLD STILL\u2026'
                     : {CENTRE: 'CENTRE', PORT: 'PORT STOP', STBD: 'STBD STOP'}[p] + (done ? ' \u2713' : ''));
  });
  if (!gWizFilled && L.range) {
    gWizFilled = true;
    document.getElementById('wz-range').value = Math.round(L.range);
    var dflt = Math.max(5, L.range - (L.margin || 3));
    document.getElementById('wz-lim-port').value = L.port_deg != null ? L.port_deg : dflt;
    document.getElementById('wz-lim-stbd').value = L.stbd_deg != null ? L.stbd_deg : dflt;
  }
  document.getElementById('wz-msg').textContent = L.msg || '';
}

document.getElementById('sf-wiz-dock').addEventListener('click', openDockWizard);
document.getElementById('wov-close').addEventListener('click', closeDockWizard);
document.getElementById('wz-range-set').addEventListener('click', function() {
  var v = parseFloat(document.getElementById('wz-range').value);
  if (!(v >= 10 && v <= 100)) { document.getElementById('wz-msg').textContent = 'Enter 10-100 degrees'; return; }
  sendCmd('LIMITS RANGE ' + v);
  // New range -> propose new soft limits on the next status
  gWizFilled = false;
});
['CENTRE', 'PORT', 'STBD'].forEach(function(p) {
  document.getElementById('wz-cap-' + p).addEventListener('click', function() {
    sendCmd('LIMITS CAPTURE ' + p);
  });
});
document.getElementById('wz-save').addEventListener('click', function() {
  var pv = parseFloat(document.getElementById('wz-lim-port').value);
  var sv = parseFloat(document.getElementById('wz-lim-stbd').value);
  if (isNaN(pv) || isNaN(sv)) { document.getElementById('wz-msg').textContent = 'Enter both limits'; return; }
  sendCmd('LIMITS SET ' + pv + ' ' + sv);
});

// ── SSE subscription ──────────────────────────────────────────────────────
var es = new EventSource('/events');
es.onmessage = function(e) { updateUI(JSON.parse(e.data)); };
es.onerror   = function()  { setConnected(false); };

// ── Link-quality probe ────────────────────────────────────────────────────
// Measures the path the remote actually uses (this browser -> Pi over WiFi),
// which the Pi-side gateway ping in inno_health_notify.py cannot see: it pings
// OUTWARD, so a Pi receive-path problem looks healthy from there.
// Fetches the tiny /health endpoint once a second; a probe with no reply in
// LP_TIMEOUT_MS counts as lost. Keeps a rolling LP_WINDOW_MS of samples.
// Design rules: loss <= 2% is acceptable for autopilot control (LP_BREACH_PCT);
// numbers are shown ONLY in Debug mode; in normal mode a breach shows just a
// quiet "WiFi weak" in the footer status area; every breach/clear transition
// is POSTed to /linkevent so it lands in the event log (journal).
var LP_PERIOD_MS = 1000, LP_TIMEOUT_MS = 2000, LP_WINDOW_MS = 60000;
var LP_BREACH_PCT = 2.0, LP_MIN_SAMPLES = 10;
var gLpSamples  = [];     // [{t: ms timestamp, rtt: ms or null when lost}]
var gLpBreach   = false;  // current breach state
var gLpReported = false;  // last breach state the server acknowledged
var gLpStats    = null;   // latest {pct, avg, max, n}
function linkProbe() {
  var t0 = performance.now();
  var ctrl = new AbortController();
  var timer = setTimeout(function() { ctrl.abort(); }, LP_TIMEOUT_MS);
  fetch('/health', {cache: 'no-store', signal: ctrl.signal})
    .then(function(r) { return r.ok ? r.text() : Promise.reject(); })
    .then(function() { linkProbeDone(performance.now() - t0); })
    .catch(function()  { linkProbeDone(null); })
    .then(function()   { clearTimeout(timer); });
}
function linkProbeDone(rtt) {
  var now = Date.now();
  gLpSamples.push({t: now, rtt: rtt});
  while (gLpSamples.length && now - gLpSamples[0].t > LP_WINDOW_MS) gLpSamples.shift();
  var lost = 0, sum = 0, n = 0, max = 0;
  gLpSamples.forEach(function(s) {
    if (s.rtt === null) { lost++; return; }
    sum += s.rtt; n++; if (s.rtt > max) max = s.rtt;
  });
  gLpStats = {pct: lost * 100 / gLpSamples.length, avg: n ? sum / n : null, max: max, n: gLpSamples.length};
  // Don't judge on fewer than LP_MIN_SAMPLES so one early miss isn't a "breach".
  if (gLpStats.n >= LP_MIN_SAMPLES) gLpBreach = gLpStats.pct > LP_BREACH_PCT;
  linkReportBreach();
  linkRender();
}
// Tell the server about breach/clear transitions. If the POST fails (which is
// likely exactly when the link is bad) gLpReported stays put and we retry on
// the next probe, so the event is not lost.
function linkReportBreach() {
  if (gLpBreach === gLpReported || !gLpStats) return;
  var want = gLpBreach;
  fetch('/linkevent', {method: 'POST', headers: {'Content-Type': 'application/json'},
    body: JSON.stringify({state: want ? 'breach' : 'clear',
      loss_pct: Math.round(gLpStats.pct * 10) / 10,
      avg_ms: gLpStats.avg === null ? null : Math.round(gLpStats.avg),
      max_ms: Math.round(gLpStats.max), samples: gLpStats.n})})
    .then(function(r) { if (r.ok) gLpReported = want; })
    .catch(function() {});
}
// ── Alert panel ───────────────────────────────────────────────────────────
// Single alerting area (bottom right of the remote).  Sources, highest priority first:
//   0 transient message for something the skipper just did (showWarning)
//   1-5 autopilot/steering faults from the bridge (computed in updateAlertsFromState)
//   6-7 WiFi links: AUTOPILOT WIFI (Pi -> router, measured by inno-health-notify,
//       gNetPi) and REMOTE WIFI (this browser -> Pi, measured here, gLpBreach)
// Normal mode: shows only active alerts (max 3 rows), "All Services Nominal" when all is well.
// Debug mode: live link numbers, plus the top alert or else the software version.
var gNetPi = null;        // {state:'OK'|'WARN', loss_pct, avg_ms} from SSE, or null if unknown
var gStateAlerts = [];    // [{p, text, cls}] derived from the latest SSE state
var gToast = null;        // {rows:[text], until: ms} transient message
var gVersion = '---';
var ALERT_COLS = 21;      // characters that fit a panel row

function updateAlertsFromState(d) {
  var a = [];
  var comms = (d.comms || 'OK').toUpperCase();
  // Bridge-raised alerts (telemetry WARN <code>): steering stopped for safety.
  if (d.connected && d.warn === 'STEER_LOSS')         a.push({p:0, text:'REMOTE STEER: STOPPED', cls:'a-crit'});
  if (d.connected && d.warn === 'AP_LOST')            a.push({p:0, text:'AUTOPILOT: STOPPED',    cls:'a-crit'});
  if (d.connected && d.rudder_stall)                  a.push({p:1, text:'RUDDER: NOT MOVING',    cls:'a-crit'});
  // No rudder motion before limits: steering is refused until the Dock-Side Wizard
  // has set them.  Red when the bridge just refused or stopped something.
  if (d.connected && d.limits && !d.limits.ok)
    a.push({p:1, text:'RUDDER LIMITS: NOT SET', cls: d.warn === 'LIMITS_UNSET' ? 'a-crit' : 'a-warn'});
  if (!d.connected && gTogglePos !== 'off')           a.push({p:2, text:'AUTOPILOT: LOST',       cls:'a-crit'});
  if (d.connected && comms === 'CRIT')                a.push({p:3, text:'STEER MOTOR: FAULT',    cls:'a-crit'});
  if (d.connected && d.pypilot_ok === false)          a.push({p:4, text:'COMPASS: NO HEADING',   cls:'a-warn'});
  if (d.connected && comms === 'WARN')                a.push({p:5, text:'MOTOR LINK: POOR',      cls:'a-warn'});
  gStateAlerts = a;
  gVersion = d.bridge_ver || d.version || '---';
}

// Word-wrap a message to panel rows (max 3), upper-cased like an OLED.
function alertWrap(msg) {
  var words = String(msg).toUpperCase().split(/\\s+/), rows = [], cur = '';
  words.forEach(function(w) {
    if (cur && (cur + ' ' + w).length > ALERT_COLS) { rows.push(cur); cur = w; }
    else cur = cur ? cur + ' ' + w : w;
  });
  if (cur) rows.push(cur);
  return rows.slice(0, 3);
}

function linkRender() {
  var el = document.getElementById('alert-oled');
  if (!el) return;
  var alerts = gStateAlerts.slice();
  if (gNetPi && gNetPi.state === 'WARN') alerts.push({p:6, text:'AUTOPILOT WIFI: WEAK', cls:'a-warn'});
  if (gLpBreach)                         alerts.push({p:7, text:'REMOTE WIFI: WEAK',    cls:'a-warn'});
  alerts.sort(function(x, y) { return x.p - y.p; });
  var rows = [];   // [{text, cls}]
  if (gToast && Date.now() < gToast.until) {
    gToast.rows.forEach(function(t) { rows.push({text: t, cls: 'a-warn'}); });
  } else {
    gToast = null;
  }
  if (gDebugActive) {
    var pi = 'PI>RTR ';
    if (gNetPi && gNetPi.loss_pct != null) {
      pi += gNetPi.loss_pct.toFixed(gNetPi.loss_pct < 10 ? 1 : 0) + '%';
      if (gNetPi.avg_ms != null) pi += ' ' + Math.round(gNetPi.avg_ms) + 'ms';
    } else pi += '--';
    var rm = 'REM>PI ';
    if (gLpStats) {
      rm += gLpStats.pct.toFixed(gLpStats.pct < 10 ? 1 : 0) + '%';
      if (gLpStats.avg !== null) rm += ' ' + Math.round(gLpStats.avg) + '/' + Math.round(gLpStats.max) + 'ms';
    } else rm += '--';
    rows = rows.slice(0, 1).concat([{text: pi, cls: ''}, {text: rm, cls: ''}]);
    rows.push(alerts.length ? {text: alerts[0].text, cls: alerts[0].cls} : {text: 'VER ' + gVersion, cls: ''});
    rows = rows.slice(-3);   // keep the newest three (stats + top alert/version)
  } else {
    alerts.forEach(function(a) { rows.push({text: a.text, cls: a.cls}); });
    if (rows.length > 3) {   // never hide alerts silently: last row says how many more
      rows = rows.slice(0, 2).concat([{text: '+' + (rows.length - 2) + ' MORE', cls: 'a-warn'}]);
    }
    if (!rows.length) {   // all is well: two centred lines at full CMD/Head size
      rows.push({text: 'All Services', cls: 'a-nominal'});
      rows.push({text: 'Nominal',      cls: 'a-nominal'});
    }
  }
  el.textContent = '';
  rows.forEach(function(r) {
    var d = document.createElement('div');
    d.textContent = r.text;
    if (r.cls) d.className = r.cls;
    el.appendChild(d);
  });
}
setInterval(linkProbe, LP_PERIOD_MS);
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
