aviljoenn/inno-pilot/inno-remote/firmware/inno_remote/main/ota_update.c

#include "ota_update.h"

#include "esp_log.h"
#include "esp_ota_ops.h"
#include "esp_http_client.h"
#include "esp_https_ota.h"

static const char *TAG = "OTA";

esp_err_t ota_update_from_url(const char *url)
{
    ESP_LOGI(TAG, "Starting OTA from %s", url);

    esp_http_client_config_t http_cfg = {
        .url = url,
        .timeout_ms = 30000,
    };

    esp_https_ota_config_t ota_cfg = {
        .http_config = &http_cfg,
    };

    esp_err_t ret = esp_https_ota(&ota_cfg);
    if (ret == ESP_OK) {
        ESP_LOGI(TAG, "OTA succeeded, rebooting...");
        esp_restart();
        // unreachable
    }

    ESP_LOGE(TAG, "OTA failed: %s", esp_err_to_name(ret));
    return ret;
}
