aviljoenn/inno-pilot/servo_motor_control/arduino/pwm_test/pwm_test.ino

// pwm_test.ino
// Binary-search for the minimum PWM duty that reliably starts the motor
// from standstill on the IBT-2 H-bridge.
//
// ---- Test mode ----
// RUN_INTERACTIVE_TEST (default): manual remote-target test with OLED + B3 button.
//   - Centre rudder, display a pre-set ADC target on OLED, wait for B3 (GO).
//   - Drive at 255 PWM, hard-cut at target, measure coast overshoot.
//   - Repeat for 3 targets × 3 reps × 2 directions = 18 runs.
// Comment out RUN_INTERACTIVE_TEST to run the automated comprehensive table instead.
//
// Usage (either mode):
//   1. Stop inno-pilot-bridge, pypilot services on the Pi.
//   2. Upload this sketch (arduino-cli compile/upload with arduino:avr:nano).
//   3. Open Serial monitor at 115200 baud — results print automatically.
//   4. Rudder should be near mid-travel before starting (see [INIT] message).
//   5. When done, re-flash motor_simple.ino.
//
// Pin wiring (same as motor_simple.ino):
//   ADS1115 A0 (I2C 0x48) = rudder pot (position feedback) — replaces Nano A2
//   A1  = current sensor (IBT-2 analog output)
//   D2  = HBRIDGE_RPWM (direction)
//   D3  = HBRIDGE_LPWM (direction)
//   D9  = HBRIDGE_EN   (R_EN + L_EN tied — PWM speed)
//   D11 = Clutch (HIGH = engaged)
//   A6  = Button ladder (B3 = GO / next, same resistor divider as motor_simple.ino)

// ---- Test mode selector ----
// Define exactly one of the modes:
//   RUN_REMOTE_CONTROL_TEST — bridge-integrated positioning test (adjust mode + test mode)
//   RUN_FINE_BURST_TEST     — 10–30 ms × 1 ms steps, 3 reps each, both dirs
//   RUN_BURST_SWEEP_TEST    — 24-step coarse burst-duration sweep
//   RUN_INTERACTIVE_TEST    — manual target test with B3 GO button
//   (neither)               — automated comprehensive table
//
// NOTE: RUN_REMOTE_CONTROL_TEST uses 38400 baud (bridge-compatible).
//       All other modes use 115200 baud (serial monitor).
#define RUN_REMOTE_CONTROL_TEST
//#define RUN_FINE_BURST_TEST
//#define RUN_BURST_SWEEP_TEST
//#define RUN_INTERACTIVE_TEST

#include <Arduino.h>

// OLED + button hardware used by all interactive modes
#if defined(RUN_INTERACTIVE_TEST) || defined(RUN_BURST_SWEEP_TEST) || defined(RUN_FINE_BURST_TEST) || defined(RUN_REMOTE_CONTROL_TEST)
#include <Wire.h>
#include <Adafruit_ADS1X15.h>
#include <Adafruit_GFX.h>
#include <Adafruit_SSD1306.h>
#endif

// ---- Pin map (must match motor_simple.ino exactly) ----
// RUDDER_PIN (A2) retired — rudder feedback now read from ADS1115 A0 (I2C 0x48).
const uint8_t PIN_CURRENT      = A1;
const uint8_t HBRIDGE_RPWM_PIN = 2;
const uint8_t HBRIDGE_LPWM_PIN = 3;
const uint8_t HBRIDGE_PWM_PIN  = 9;   // EN: R_EN + L_EN tied together
const uint8_t CLUTCH_PIN       = 11;

// ---- ADS1115 rudder ADC (I2C 0x48, channel A0, continuous mode) ----
// GAIN_TWOTHIRDS = ±6.144 V, LSB = 0.1875 mV.  5 V pot → ~26666 counts.
// Continuous mode at 860 SPS keeps hot-loop reads fast (no per-read wait).
Adafruit_ADS1115 ads;
static const int16_t ADS_5V_COUNT = 26666;  // raw counts at 5.000 V

// ---- Hard rudder limits (from motor_simple.ino) ----
const int RUDDER_PORT_END  = 1;
const int RUDDER_STBD_END  = 1022;

// ---- Test tuning ----
// Increase DWELL_MS if the motor is slow to start or load is heavy.
// Decrease MOVE_THRESHOLD if the pot moves very little even at full power.
const uint16_t DWELL_MS           = 1000;  // motor-on time per binary step (ms)
const uint16_t RETURN_TIMEOUT_MS  = 5000;  // max time to return to start position (ms)
const int      MOVE_THRESHOLD     = 8;     // ADC delta (counts) to count as "moved"
const int      LIMIT_MARGIN       = 60;    // safety margin from hard ends (ADC counts)
const int      MIN_TRAVEL_NEEDED  = 250;   // minimum counts of free travel before testing

// ---- Current sensor ----
// From motor_simple.ino calibration: ADC=430 @ 0 A, decreases ~1.3 counts/A.
const int   CURR_ZERO_ADC = 430;
const float CURR_SLOPE    = 1.31f;  // ADC counts per amp (approx)

// ---- Coasting / ramp-down test constants ----
const int  COAST_TRAVEL    = 150;  // counts to drive before cut/ramp trigger
const uint16_t COAST_SETTLE_MS = 350;  // position stable for this long = stopped

// ---- Speed measurement ----
const uint16_t SPEED_DWELL_MS  = 600;  // ms to drive while measuring counts/s

// ---- Reverse-braking test ----
const uint8_t  BRAKE_THRESHOLD = 5;    // counts: "dead stop" tolerance (±5 counts)
const uint16_t BRAKE_MAX_MS    = 250;  // max reverse braking duration to try (ms)

const int PULSE_MOVE = 3;   // counts: threshold for "rudder moved" in pulse test

// ---- Per-run result for interactive test (defined unconditionally so the
//      Arduino preprocessor can resolve it when generating function prototypes)
struct TargetRunResult {
  int           start_adc;
  int           target_adc;
  int           final_adc;
  int           overshoot;       // +ve = overshot past target, -ve = undershot
  unsigned long drive_ms;        // time from motor-on to settled/cut
  int16_t       speed_at_brake;  // cps when brake was triggered (0 = no brake / hard-cut)
  unsigned long brake_ms_used;   // ms of reverse brake applied  (0 = no brake / hard-cut)
};

// Per-burst result for RUN_BURST_SWEEP_TEST (defined unconditionally so Arduino
// preprocessor can resolve it when generating function prototypes)
struct BurstResult {
  uint16_t burst_ms;    // programmed burst duration (ms)
  int8_t   dir;         // +1 = STBD, -1 = PORT
  int      start_adc;   // ADC at burst start
  int      final_adc;   // ADC after hard-cut + hydraulic settle
  int      counts_moved;// signed net displacement (final - start); includes coast
};

// RCT (Remote Control Test) types — defined unconditionally for preprocessor.
// Seven settings that the Pi stores in JSON and pushes to the Nano on startup.
// Stored in Nano EEPROM as fallback when Pi is unavailable.
struct RctSettings {
  uint8_t pwm_max;          // full-power drive PWM (0-255)
  uint8_t coast_count_max;  // ADC counts before target to trigger hard-stop and coast
  uint8_t pwm_min;          // fine-pulse PWM (0-255)
  uint8_t coast_count_min;  // reserved for future use (coast at pwm_min)
  uint8_t pulse_ms;         // duration of each fine pulse (ms)
  uint8_t deadband;         // +/- ADC counts around target that counts as "arrived"
  uint8_t pulse_delay_ms;   // inter-pulse delay (ms)
};

// Result of one RCT positioning trial
struct RctTestResult {
  int     first_stop_adc;  // rudder ADC after full-power coast settles
  uint8_t pulse_count;     // number of fine pulses used
  int     final_adc;       // final rudder ADC (inside or nearest to deadband)
  bool    in_deadband;     // true if final_adc is within deadband of target
};

// Button IDs — used by RCT mode (same resistor ladder as motor_simple.ino)
enum ButtonID : uint8_t {
  BTN_NONE = 0,
  BTN_B1,    // value down  / left-most
  BTN_B2,    // scroll left
  BTN_B3,    // enter (short press) / mode cycle (long press >=3 s)
  BTN_B4,    // scroll right
  BTN_B5,    // value up / right-most
};

// Long B3 cycles: TEST <-> ADJUST.
// RATIFY entered by remote MANUAL switch (MANUAL_MODE_CODE=1); exited by AUTO switch (=0).
enum RctModeID : uint8_t {
  RCT_MODE_TEST = 0,   // set target with remote POT, press B3 to run once
  RCT_MODE_ADJUST,     // configure settings via button ladder
  RCT_MODE_RATIFY,     // real-time remote steering; OLED off, fast pulse-per-loop
};

// Set by serial drain when MANUAL_MODE_CODE=1 received; allows rct_adjust_mode to
// notice a mode-switch request even while blocked in rct_wait_button.
static bool rct_ratify_requested = false;

// ====================================================================
// OLED + button — shared by all interactive test modes
// ====================================================================
#if defined(RUN_INTERACTIVE_TEST) || defined(RUN_BURST_SWEEP_TEST) || defined(RUN_FINE_BURST_TEST) || defined(RUN_REMOTE_CONTROL_TEST)

#define SCREEN_WIDTH  128
#define SCREEN_HEIGHT  64
#define OLED_RESET     -1
#define OLED_ADDR    0x3C
static Adafruit_SSD1306 oled(SCREEN_WIDTH, SCREEN_HEIGHT, &Wire, OLED_RESET);
static bool oled_ok = false;

// ---- Button (A6 resistor ladder, same thresholds as motor_simple.ino) ----
const uint8_t  BUTTON_ADC_PIN  = A6;
const unsigned long BTN_DEBOUNCE_MS = 60UL;

// B3 ADC window: > 257 and <= 419 (from motor_simple.ino decode_button_from_adc)
static bool is_btn3() {
  int v = analogRead(BUTTON_ADC_PIN);
  return (v > 257 && v <= 419);
}

// Block until B3 is pressed and released (debounced).
static void wait_for_btn3() {
  // Wait for press
  while (true) {
    if (is_btn3()) {
      delay(BTN_DEBOUNCE_MS);
      if (is_btn3()) break;
    }
    delay(20);
  }
  // Wait for release
  while (is_btn3()) { delay(20); }
  delay(BTN_DEBOUNCE_MS);
}

#ifdef RUN_INTERACTIVE_TEST
// ---- Algorithm selector ----
// 0 = hard-cut: motor off the instant target ADC is crossed (worst-case baseline)
// 1 = speed-aware braking: motor_simple.ino B5 state machine (RM_DRIVING/BRAKING/SETTLED)
#define TEST_ALGORITHM  1

// ---- Interactive test parameters ----
// 6 runs total (3 STBD + 3 PORT), direction toggles after each run.
// Each run starts from wherever the rudder stopped after the previous run.
// Travel distance is fixed at TRAVEL_COUNTS; must exceed MIN_TRAVEL_COUNTS
// (40% of usable ADC range 61..962 = 901 counts → 360 counts minimum).
#define N_RUNS  6
const int TRAVEL_COUNTS     = 450;  // 50% of usable range per run (~enough to show coast clearly)
const int MIN_TRAVEL_COUNTS = 360;  // 40% floor — warn user if less is available
#endif  // RUN_INTERACTIVE_TEST (constants only)

#endif  // RUN_INTERACTIVE_TEST || RUN_BURST_SWEEP_TEST

// ====================================================================
// Low-level helpers
// ====================================================================
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
