aviljoenn/inno-pilot/(commit log)

2025-11-10 Add system diagram for autopilot wiring
2026-01-06 Flatten servo motor control arduino folder
2026-01-08 Update rudder limit polarity and display
2026-01-08 Fix rudder limit sign consistency
    [inno_pilot_bridge.py]
2026-01-08 Fix rudder direction and limit alignment
    [motor_simple.ino]
2026-01-08 Align manual jog limits with pilot rudder limits
2026-01-08 Adjust rudder ADC safety endpoints
2026-01-08 Fix rudder limit sign and range updates
    [inno_pilot_bridge.py]
2026-01-09 Report serial read failures in bridge
    [inno_pilot_bridge.py]
2026-01-09 Add framed bridge protocol and Nano handshake
2026-01-09 Add retry delay for Nano probe
2026-01-10 Reduce serial probing resets
    [inno_pilot_bridge.py]
2026-01-22 Fix STOP/log view state handling
    [inno_remote.c]
2026-03-20 Switch from AGENTS.md to CLAUDE.md for Claude Code
    Replace OpenAI Codex AGENTS.md convention with Claude Code's CLAUDE.md
    in both the repo root and compute_module/glue/. Update README references
    accordingly.
2026-03-20 Note arduino-cli install on Pi Zero in CLAUDE.md
    Documents that arduino-cli v1.4.0 is installed on the Pi Zero (192.168.6.13)
    with the arduino:avr core, and the exact flash commands for the Nano.
2026-03-20 Fix Nano showing Offline: send BRIDGE_HELLO periodically from main loop
    BRIDGE_HELLO_CODE was only sent during probe_nano_port(), which is bypassed
    when NANO_PORT already exists. The Nano never received the handshake so it
    stayed Offline. Now sends BRIDGE_HELLO every 5s in the main loop, independent
    of pypilot state, so the Nano comes Online immediately and recovers from reboots.
    [inno_pilot_bridge.py]
2026-03-20 Reduce BRIDGE_HELLO period from 5s to 1s to fix Nano staying Offline
    Nano requires 3 consecutive valid frames before processing (in_sync_count
    guard), and times out to Offline after 5s without a frame. With 5s hello
    period the Nano could take 15s to come online and then immediately time out.
    1s period brings it online within ~3s and keeps it well within the timeout.
    [inno_pilot_bridge.py]
2026-03-20 Fix OLED reinitialization resilience: init first in setup()
    Move oled_try_init() to the very start of setup() — before Serial,
    pinMode, tempSensors — mirroring the Hello World sketch pattern so the
    display reinitializes correctly after any previously-flashed sketch
    without requiring a power cycle.
    Also add Wire.end()/delay(10) to the loop() retry path to reset a stuck
    I2C bus before reattempting display.begin().
    [motor_simple.ino]
2026-03-20 Fix OLED init: use static buffer to avoid malloc failure on Nano
    Adafruit_SSD1306::begin() calls malloc(1024) at runtime for its pixel
    buffer. With 804 bytes of static globals, avr-libc's allocator refused
    the allocation when the stack was deep enough at boot time (safety
    margin < 32 bytes), causing begin() to return false and the display to
    stay on whatever the previous sketch left.
    Fix: thin subclass pre-sets the protected `buffer` pointer to a static
    member array before begin() runs. begin() sees buffer != NULL and skips
    malloc. Runtime memory footprint is identical (1024 bytes) but is now
    deterministic and never races with stack depth.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
    [motor_simple.ino]
2026-03-20 Add buzzer feedback for clutch engage/disengage
    Clutch engage: 3 × quick beeps (100 ms on / 100 ms off)
    Clutch disengage: 1 × long beep (500 ms on)
    Non-blocking state machine in buzzer_service(); alarm always pre-empts
    the clutch sequence. Refactored the existing inline alarm buzzer into
    the same service function for a single buzzer owner.
    [motor_simple.ino]
2026-03-20 Fix clutch buzzer: watch pin 11 directly instead of internal logic
    Replaced complex clutch_should/pi_fault-dependent trigger with a simple
    digitalRead(CLUTCH_PIN) edge detect in loop(). If pin 11 goes HIGH →
    3 quick beeps; if it goes LOW → 1 long beep. No dependency on AP state,
    pi_fault, or any other internal condition.
    [motor_simple.ino]
2026-03-21 Restore motor_simple.ino to pre-2026-03-20 stable state (162e895)
    Reverting all changes made on 2026-03-20 to establish a known-good
    baseline before reapplying changes selectively.
    [motor_simple.ino]
2026-03-24 Add OTA partition table, OTA module, and TCP client (A4 + B1)
    - Dual OTA partition table (ota_0 + ota_1, 1.75MB each) for over-the-air updates
    - OTA update module (ota_update.c) using esp_https_ota with HTTP allowed
    - sdkconfig.defaults: ESP32-C3 target, 4MB flash, custom partitions
    - TCP client task: connects to bridge on port 8555, PING keepalive every 2s,
    auto-reconnect, line-based RX with callback, thread-safe send API
    - Version label moved from title bar to bottom-left corner (overlap fix)
    - TCP client only starts in normal mode (not demo)
    [partitions_ota.csv]
2026-03-24 Add TCP remote server and version string to bridge (Steps 1-3)
    - INNOPILOT_VERSION = "v0.2.0_B" (must match Nano + remote)
    - TCP server on port 8555: single client, 6s timeout, non-blocking
    - Command parsing: PING→PONG, BTN (TOGGLE/±1/±10), ESTOP
    - Telemetry push: AP/HDG/CMD/RDR at 5Hz to connected remote
    - Fixed duplicate constants and triple telemetry send from original
    - Added select()-based main loop for concurrent serial + TCP handling
    [inno_pilot_bridge.py]
2026-03-24 Fix bridge main loop blocking on pypilotClient flush()
    pypilotClient.connection.flush() blocks indefinitely when the pypilot
    TCP write buffer is full, preventing the bridge from accepting TCP
    connections or processing serial data. Set a 100ms socket timeout on
    the pypilot connection each loop iteration, and wrap receive() in
    try/except so a timeout doesn't crash the bridge.
    [inno_pilot_bridge.py]
2026-03-24 Revert bridge socket timeout fix — probe phase needs time, not a workaround
    The pypilotClient zeroconf probe takes time after boot. The blocking
    observed was normal startup behavior, not a bug.
    [inno_pilot_bridge.py]
2026-03-24 Add build number convention (B4) and show versions on Nano OLED during boot
    - Version convention: v0.2.0_B4 with incrementing build number across all 3 components
    - New frame code BRIDGE_VERSION_CODE (0xF2): bridge sends build number to Nano
    - Nano OLED boot countdown now shows both Nano and Bridge versions centred on screen
    - Bridge version shows "waiting..." until first BRIDGE_VERSION_CODE received
2026-03-24 v0.2.0_B5: OLED layout overhaul, Vin fault detection
    - Rows 4-7 (was 3-6): AP/Clutch, Cmd/Head, Rud, V/A/T — freed rows 2-3
    - Rows 2-3: large 2X flashing fault display (!OVERTEMP!, !PiV HIGH/LOW!, !Vin HIGH/LOW!)
    - Row 1: Pi Online/Offline + bridge build number (always visible)
    - Row 0: heading shows name + version only (no Online/Offline text)
    - New: Vin < 10.9V → !Vin LOW!, Vin > 15.1V → !Vin HIGH! faults
    - Fault buzzer: STOP button silences all fault types; resets when all faults clear
    - AP/Clutch ON/OFF now always uppercase
    - Cmd shown before Head on telemetry row
    - Splash screen version position corrected (moved left to fit screen)
    - All three components bumped to v0.2.0_B5
    Co-Au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
    [inno_pilot_bridge.py, inno_remote.c, motor_simple.ino]
2026-03-24 Thread pypilotClient to fix main-loop stall (Pi: Offline flicker)
    pypilotClient.receive() internally calls flush() which uses pselect6 with a
    NULL timeout, blocking the entire bridge main loop. This caused HELLO frames
    to stall, making the Nano flash "Pi: Offline" every few seconds.
    Move all pypilotClient interaction into a daemon thread (pypilot_worker).
    - Thread: receive(), set(), watch() — blocks on pselect without affecting main loop
    - Main loop: Nano serial, TCP remote, HELLO keepalive — runs freely at 100 Hz
    - Shared state via PypilotState dataclass + threading.Lock
    - Outbound set() calls via queue.Queue (posted by main loop, drained by thread)
    - Auto-reconnect in thread on conne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
    [inno_pilot_bridge.py]
2026-03-24 Fix pypilot thread CPU spin starving main loop on Pi Zero
    receive(0) returns immediately when pypilot has data buffered, causing
    the worker thread to spin at ~92% CPU on the single-core Pi Zero.
    This starved the main thread, so HELLO frames rarely reached the Nano
    and the Nano showed 'Pi: Offline' permanently.
    Add time.sleep(0.01) in the worker loop to yield CPU back to the main
    thread, matching the 10ms tick of the main loop.
    [inno_pilot_bridge.py]
2026-03-24 Bump version to v0.2.0_B6 across all components
    Covers two bridge changes since B5:
    - Thread pypilotClient (fixes Pi: Offline flicker)
    - Add sleep in pypilot worker thread (fixes 92% CPU spin on Pi Zero)
    [inno_pilot_bridge.py, inno_remote.c, motor_simple.ino]
2026-03-24 Add B7: bridge mode state machine, MANUAL steering, warnings, buzzer reporting
    What
    - Bridge: mode state machine (IDLE/AP/MANUAL), handle_remote_disconnect(),
    process_remote_line() with MODE/RUD/BTN/ESTOP; FLAGS + BUZZER_STATE_CODE
    parsing; RDR_PCT telemetry; MANUAL_MODE_CODE=0xE9 (was 0xE7 — conflict fix)
    - Nano: MANUAL_MODE_CODE/MANUAL_RUD_TARGET_CODE/WARNING_CODE/BUZZER_STATE_CODE;
    two-press STOP (silence alarm first, full stop second); steer-loss + ap-warn
    OLED display; bang-bang remote manual motor drive; MAN: ON row 4 display
    - Remote: on_bridge_rx TCP callback; mode transition sends (MODE MANUAL/AUTO);
    BTN TOGGLE/±1/±10/ESTOP sends; RUD % sends from pot in MANUAL; bridge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
    [inno_pilot_bridge.py, inno_remote.c, motor_simple.ino]
2026-03-25 Update documentation for v0.2.0_B7 remote integration
    - CHANGELOG: add v0.2.0_B7 entry with all new features, changes, fixes
    - README: update architecture diagram with remote, add Future Enhancements
    section (commercial autopilot feature research)
    - PROTOCOL: add B7 serial frame codes (0xE8–0xEB) and full TCP protocol spec
    - ARCHITECTURE: add wireless remote component, update data flow and safety model
    - compute_module/glue/README: document TCP server and mode state machine
    - inno-remote/README: update status to reflect full B7 integration
2026-03-25 Add structured logging with SIGUSR1 debug toggle to bridge
    Replace all print() calls with Python logging module (INFO/WARNING/ERROR/DEBUG).
    Toggle DEBUG at runtime with: kill -USR1 $(pgrep -f inno_pilot_bridge)
    No protocol or version change — pure internal improvement.
    [inno_pilot_bridge.py]
2026-03-25 Add Rx diagnostic counters to Nano OLED and bridge debug logging
    Nano (motor_simple.ino):
    - Add Rx/Er/Age counters: good frames, CRC errors, seconds since last frame
    - Display on OLED row 3 (online) or row 4 (offline) for live diagnostics
    - Counters increment in serial parser, zero cost when not displayed
    Bridge (inno_pilot_bridge.py):
    - Add DEBUG-level logs for HELLO and telemetry sends to Nano
    - Enables correlation between bridge sends and Nano Rx counter
    [inno_pilot_bridge.py, motor_simple.ino]
2026-03-25 Add B8: CRC-validated pypilot relay to fix Nano error frame flood
    The bridge was blindly chopping pypilot PTY data into 4-byte chunks
    and forwarding to the Nano. Any alignment drift (extra byte, partial
    frame) caused permanent CRC failures on the Nano, producing an ~87%
    error rate (e.g. Rx:1208 Er:8046).
    The relay now validates CRC before forwarding. On mismatch it drops
    one byte and rescans, self-aligning to the next valid frame boundary.
    Added relay_good/relay_drop counters logged every 30 s at INFO level.
    [inno_pilot_bridge.py, motor_simple.ino]
2026-03-25 Add B9: detailed DEBUG capture for pypilot relay diagnostics
    At DEBUG level (SIGUSR1 toggle) the bridge now logs:
    - pilot RX: raw hex of every chunk received from pypilot PTY
    - pilot->nano RELAY: code, raw frame, wrapped hex for every forwarded frame
    - pilot relay DROP: dropped byte + 4-byte candidate + got/expected CRC
    - nano TX: code, value, full hex for every frame sent to Nano
    Enables side-by-side comparison of what pypilot sends vs what
    reaches the Nano to diagnose persistent CRC error flood.
    [inno_pilot_bridge.py, motor_simple.ino]
2026-03-25 Add B10: Nano RX debug logging for full bidirectional capture
    Adds DEBUG-level logging for:
    - nano RX: raw hex of every chunk received from the Nano
    - nano->pilot RELAY: code, value, hex for every frame forwarded to pypilot
    Combined with B9 pilot RX / nano TX logging, this gives a complete
    four-way view of serial traffic to diagnose the CRC error flood.
    [inno_pilot_bridge.py, motor_simple.ino]
2026-03-26 B11: Fix HUPCL — disable DTR-drop on serial close to prevent Nano reset
    Every time any process closed /dev/ttyUSB0 the Linux kernel dropped DTR
    (HUPCL = hang-up on close), which triggered the Nano reset circuit.
    The bridge would then open the port with dtr=False, but the Nano was
    already in its 3-second startup splash and couldn't receive or transmit
    frames — causing the Rx=0 / 100% CRC-error symptom.
    Fix: after ser.open(), call termios.tcgetattr/tcsetattr to clear the
    HUPCL flag on the live fd. The previous close no longer drops DTR, so
    the Nano stays running across bridge restarts.
    [inno_pilot_bridge.py]
2026-03-26 docs: Document Nano HUPCL reset gotcha in CLAUDE.md files
    Explains the root cause (DTR drop on fd close triggers reset circuit),
    symptoms (zero Rx bytes, CRC error flood), the fix already in place
    (termios HUPCL clear in open_serial_no_reset), and what to do if any
    future tool opens /dev/ttyUSB0.
2026-03-26 B14: Remove AP_ENABLED_CODE — infer AP state from pypilot relay frames
    **What**
    - Bridge: drop ap.enabled subscription from pypilot worker thread; remove
    AP_ENABLED_CODE send logic; infer AP engaged/disengaged from COMMAND_CODE
    and DISENGAGE_CODE as they pass through the PTY relay
    - Nano: remove AP_ENABLED_CODE handler; set ap_enabled_remote=true on first
    COMMAND_CODE, clear it on DISENGAGE_CODE
    - Bridge: use send_nano_frame() in probe_nano_port() for consistency
    **Why**
    - AP engage/disengage already flows through the PTY relay as pypilot's native
    motor frames — the separate AP_ENABLED_CODE path was redundant
    - Removes a subscription, a periodic send, and a state variable from t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
2026-03-27 B15: Comms-fault detection — sliding-window CRC rate monitor, auto-disengage, OLED/buzzer alarm
    - Nano: 10-second sliding-window CRC error rate monitor (10 x 1-second buckets, ~25 bytes RAM)
    - Nano: WARN at >=5 errors/10s; CRITICAL at >=15/10s held for 3 consecutive seconds
    - Nano: autonomous AP disengage on CRITICAL (ap_enabled_remote=false, clutch off, motor neutral)
    - Nano: 1 Hz (500ms) buzzer slot between hw_alarm and ap_warn; PTM silences; OLED !COMMS ERR!
    - Nano: COMMS_DIAG_CODE (0xEC) telemetry at 1 Hz (err_window_sum | crit_consec_s<<8)
    - Bridge: extract_wrapped_frames() now validates Nano->bridge CRC; corrupt frames dropped
    - Bridge: FLAGS_CODE handler parses COMMS_WARN/CRIT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
    [inno_pilot_bridge.py, motor_simple.ino]
2026-03-27 docs: Update CHANGELOG and glue README for B8–B15
    - CHANGELOG: add entries for B8–B11 (serial reliability + HUPCL fix),
    B12–B14 (AP_ENABLED_CODE removal + relay-based mode sync + probe refactor),
    and B15 (comms-fault detection safety system)
    - glue/README: document CRC validation on Nano→bridge and comms-fault monitor
2026-03-27 B16: Comms error diagnostic logging — Nano error detail frame + volatile bridge log
    Nano sends COMMS_ERR_DETAIL_CODE (0xED) on CRC error with the corrupt frame's
    CODE byte and received CRC, rate-limited to 5/s (200ms throttle, latest-wins).
    Bridge logs to /tmp/inno_pilot_comms_diag.log (256KB rotating, ms-precision
    timestamps, does not survive reboot). Both directions of CRC errors captured.
    [inno_pilot_bridge.py, motor_simple.ino]
2026-03-27 TEST: Disable oled_draw() to test OLED-blocking RX overflow hypothesis
    Temporary change — if CRC errors drop to near-zero, confirms that the
    OLED I2C draw is blocking loop() long enough to overflow the 64-byte
    Arduino serial RX buffer during telemetry bursts.
    [motor_simple.ino]
2026-03-27 B17: Fix CRC errors — 128-byte RX buffer, 1s OLED refresh, partial update
    Root cause: OLED I2C draw blocked loop() ~100ms, overflowing the 64-byte
    Arduino serial RX buffer during 5 Hz telemetry bursts (30 bytes/burst).
    Fixes:
    - Compile with -DSERIAL_RX_BUFFER_SIZE=128 (doubles RX headroom)
    - OLED refresh 200ms → 1000ms (eliminates burst/draw overlap)
    - Rows 0-1 skip I2C when content unchanged (saves ~25% draw time)
    [inno_pilot_bridge.py, motor_simple.ino]
2026-03-27 B18: OLED simplification — non-blocking splash, Helm field, 3-digit HDG, graphical rudder bar
2026-03-27 B19: Remote safety — TCP indicator, COMMS display, buzzer, WDT, version handshake
    Remote (ESP32-C3):
    - No-bridge connecting screen: TCP not connected → show "NO BRIDGE / Connecting..."
    instead of simulated instrument values; simulation is demo-mode only
    - COMMS WARN/CRIT display: mode line shows "MODE: AUTO [W]" / "!COMMS FAULT!"
    - Buzzer drive (GPIO8): ESTOP double-beep, bridge-lost triple-pulse, COMMS CRIT slow beep
    - Task watchdog: self-contained init (esp_task_wdt_init fallback), 10 s timeout
    - VERSION handshake: sends HELLO on every new TCP connection; logs mismatch
    - tcp_client: add tcp_client_set_connect_callback() API
    Bridge: HELLO command handler + version bump B18→B19
    Nano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
    [inno_pilot_bridge.py, inno_remote.c, motor_simple.ino, tcp_client.c, tcp_client.h]
2026-03-27 B20: OLED layout compaction — remove Rx diagnostics row, move Helm/Cmd/Rudder up
    Removes the Rx:N Er:N A:N.N diagnostics line (was row 3).
    Helm moves to row 3 (guarded by row3_taken for 2X fault messages).
    Cmd/HDG moves to row 4; rudder bar moves to row 5 with '-' track fill.
    Row 6 always cleared. Offline path clears rows 3-6 with no text.
    Bridge bumped to B20 to match Nano.
2026-03-27 v1.2.0_B1: OTA update pipeline + version reset
    - Remote: OTA firmware update on HELLO version mismatch — downloads from
    bridge HTTP server, flashes inactive OTA partition, reboots; OLED shows
    progress and failure; WDT unregistered during transfer
    - Bridge: OTA HTTP server on port 8556 serving inno_remote.bin from
    /var/lib/inno-pilot/ota/; sends OTA <url> to remote on version mismatch
    - Deploy: script copies ota/inno_remote.bin from repo to Pi serve directory
    - Repo: ota/ directory tracked; .gitignore exception for OTA binary
    - Version: all three components reset to v1.2.0_B1 (build counter restarts at 1)
    [inno_pilot_bridge.py, inno_remote.c, motor_simple.ino]
2026-03-27 Nano OLED: display raw A2 ADC value on row 6 (centre-justified)
    - oled_draw() row 6: was cleared; now shows "A2:NNN" (0-1023)
    from analogRead(RUDDER_PIN) on each 1 s draw cycle
    - Centre-justified using same SCREEN_WIDTH pixel calc as other rows
    - No version bump (cosmetic diagnostic display only)
2026-03-27 B22: Rudder ADC — discard-read on channel switch + 16-sample accumulator
    Replaces three separate bare analogRead(A2) calls with a single
    service_rudder_adc() called once per loop. A dummy read discards the
    first conversion after any channel switch (A6/A0/A1/A3 all precede this
    point); 16 settled samples are averaged before publishing.
    - rudder_adc_smoothed: inverted average used by motor/limit logic
    - rudder_adc_raw_disp: non-inverted average used by OLED debug row
    - read_rudder_adc() now returns pre-computed average (no analogRead)
    - Noise floor: √16 improvement (~4×); latency ≤ ~48 ms (fine for rudder)
    - Flash delta: +118 bytes; RAM delta: +9 bytes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
    [motor_simple.ino]
2026-03-27 B23: Rudder ADC hardening — trimmed mean + IIR on Nano and ESP32-C3
    - 2 dummy reads (up from 1) before each real A2 sample
    - 16-sample batch, discard min and max, average 14 (trimmed mean)
    - EMA IIR α=0.35 on top of trimmed mean (~38 ms τ at ~16 ms publish rate)
    - New state: rdr_acc_min, rdr_acc_max, rudder_iir, rudder_iir_init
    ESP32-C3 (inno_remote.c):
    - New adc_read_trimmed(): 2 dummy reads, 16 samples, discard min+max, mean of 14
    - Pot read upgraded from single adc_read_raw to adc_read_trimmed(ADC_CH_POT, 16)
    - IIR tightened from α=0.35 to α=0.25 (~72 ms τ at 20 ms loop)
    - Ladder read unchanged (threshold decode, does not need high accuracy)
    All three com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
    [inno_pilot_bridge.py, inno_remote.c, motor_simple.ino]
2026-03-27 B23: Update OTA binary for ESP32-C3 remote (v1.2.0_B3)
    Replaces the committed inno_remote.bin with the freshly built B3 image
    so the OTA pipeline can deliver the trimmed-mean + IIR ADC improvements
    to the remote over-the-air.
2026-03-27 B24: Rudder ADC — two-stage filter (burst trimmed mean + FIFO moving average)
    Replaces the distributed-accumulator + IIR approach with a cleaner two-stage
    pipeline on both the Nano and the ESP32-C3 remote.
    Stage 1 (per loop, synchronous burst):
    8 reads total: 2 dummy (S/H settle) + 6 real.
    Drop highest and lowest of the 6; integer-average the remaining 4.
    Cost: 8 × 104 µs = ~832 µs/loop (Nano); 8 × ~50 µs ≈ 400 µs/loop (ESP32).
    Stage 2 (FIFO moving average, O(1) running sum):
    Nano: 16-slot FIFO → σ/(√4×√16) = σ/8, ~32 ms window
    ESP32: 8-slot FIFO → σ/(√4×√8) = σ/5.7, ~160 ms window (~40 ms lag)
    Pre-fill on first read for instant valid output;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
    [inno_pilot_bridge.py, inno_remote.c, motor_simple.ino]
2026-03-27 Add pwm_test: binary-search for min motor starting PWM
    Standalone test sketch for IBT-2 H-bridge + hydraulic motor.
    Binary search (8 steps per direction, ~30 s total) finds the
    minimum PWM duty that reliably starts the motor from standstill.
    Reports ADC delta and estimated current per step via Serial @115200.
    Upload, run, then re-flash motor_simple.ino.
2026-03-27 pwm_test: tighten limit guards in dwell loop and return path
    - Dwell loop: replaced 150ms-interval position poll with per-iteration
    check (~416µs/loop: dummy+real on A2, dummy+real on A1). A fast motor
    can no longer overshoot the limit between polls.
    - return_to_start(): added limit guard for the return direction so the
    function cannot drive the rudder past the far hard end while recovering.
    [pwm_test.ino]
2026-03-27 pwm_test: fix read_rudder() sign convention (invert ADC to match motor_simple)
    motor_simple.ino returns (1023 - raw_adc) from read_rudder_adc() so that
    STBD = increasing ADC value. Test sketch was returning raw ADC causing
    every delta to be negative and the binary search to run in the wrong
    direction, declaring "no move" at every step.
    [pwm_test.ino]
2026-03-28 pwm_test: fix return_to_start to drive toward target regardless of drift
    The previous version always drove in the pre-set return direction, so if
    the rudder drifted past the start position while the pump was stopped, the
    function chased it in the wrong direction and hit the limit guard.
    Now return_to_start() determines drive direction each iteration from actual
    current vs target position, so it correctly recovers from either side.
    Also reduced return duty from 255 to 220 (RETURN_DUTY) to reduce overshoot.
    [pwm_test.ino]
2026-03-28 pwm_test: add auto-centering step before each direction test
    Drives rudder to ADC=512 at RETURN_DUTY before each binary search so
    the test is self-contained regardless of starting position. Removes the
    need for manual rudder positioning between tests.
2026-03-28 pwm_test: add speed sweep (counts/s vs PWM) after threshold search
    Drives at 11 fixed PWM steps (100-255) in each direction and reports
    counts/second and current per step, giving a full speed profile.
    [pwm_test.ino]
2026-03-28 pwm_test: add coast/ramp-down test
    Measures hydraulic coasting distance at 3 speeds (150/190/255 PWM)
    then validates a proportional ramp-down (duty ∝ distance-to-target)
    against a hard cut. Reports coast counts, hard overshoot, ramp error
    and improvement per speed step.
    [pwm_test.ino]
2026-03-28 pwm_test: comprehensive coast + min-pulse table (PWM 120-255 step 10)
    Adds run_comprehensive_table() measuring for each PWM step:
    - coast counts after hard cut at fixed travel distance
    - minimum pulse duration (ms) that produces any rudder movement
    - rudder delta induced by that minimum pulse
    Skips threshold/sweep/ramp tests in this run (data already collected).
    [pwm_test.ino]
2026-03-28 pwm_test: add speed_cps and brake_ms columns to characterisation table
    Adds measure_speed(), measure_brake_overshoot(), find_brake_ms() to
    support two new table columns: measured counts/s at each PWM value,
    and minimum ms of full-reverse braking needed to dead-stop within 5
    counts of the cut point via binary search.
    [pwm_test.ino]
2026-03-28 docs: add PWM hydraulic characterisation document
    Records all test methodology, code overview, full results table, key
    findings (two regimes, 55ms cracking lag, brake_ms linear fit), and
    the run-on-demand calibration script design for future implementation.
2026-03-29 motor_simple: add speed-aware reverse braking to remote manual mode
    Replace the old bang-bang controller (PWM 0 or 255, 15-count deadband)
    with a 3-state machine (DRIVING/BRAKING/SETTLED) that uses a timed
    reverse pulse to stop the rudder near the target centre.
    Brake duration is computed from measured rudder speed via a linear fit
    to characterisation data: brake_ms = 0.54 * speed_cps + 72.
    Deadband widened from 15 to 21 ADC counts to absorb residual error.
    Below 60 cps the system coasts (within deadband).
    [motor_simple.ino]
2026-03-30 pwm_test: add interactive hard-cut target test mode
    New RUN_INTERACTIVE_TEST mode: OLED + B3 button driven test that drives
    to pre-set ADC targets at 255 PWM (hard cut), records coast overshoot per
    run, and waits for B3 confirmation between runs.
    Targets: 662/812/912 (STBD) and 362/212/112 (PORT), 3 reps each = 18 runs.
    Serial output: TSV with run/dir/start/target/final/overshoot/drive_ms columns.
    The original automated comprehensive table is preserved and selectable by
    commenting out #define RUN_INTERACTIVE_TEST at the top of the file.
    [pwm_test.ino]
2026-03-30 pwm_test: fix TargetRunResult visibility for Arduino preprocessor
    Move struct definition outside #ifdef so auto-generated function
    prototypes can resolve the type before the conditional block.
    [pwm_test.ino]
2026-03-30 pwm_test: rework interactive test — alternating direction, no auto-centre
    - Direction toggles STBD/PORT after each run (6 runs = 3 per direction)
    - Each run starts from wherever the rudder stopped (no return-to-centre)
    - Target computed dynamically: current_pos + dir × 450 cts, clamped to limits
    - Travel ≥ 40% of usable range (360/901 cts); OLED warns if short
    - OLED waiting screen now shows From/To/Dist before each run
    [pwm_test.ino]
2026-03-30 pwm_test: add speed-aware braking algorithm (motor_simple.ino B5)
    - Add TEST_ALGORITHM selector: 0=hard-cut, 1=speed-aware braking
    - Port RM_DRIVING/BRAKING/SETTLED state machine from motor_simple.ino B5
    verbatim into drive_to_target_speed_brake() blocking function
    - Extend TargetRunResult with speed_at_brake and brake_ms_used fields
    - TSV output gains speed_cps and brake_ms columns for both algorithms
    - OLED result screen shows brake telemetry when active, drive_ms otherwise
2026-03-30 pwm_test: fix RM_DRIVING exit — remove erroneous deadband check
    drive_to_target_speed_brake() had an extra `abs_error <= REMOTE_DEADBAND`
    condition in the RM_DRIVING exit, which does not exist in motor_simple.ino.
    This caused a hard cut ~21 counts early, before brake_dist could trigger,
    so the speed-aware brake never fired (speed_cps=0 in results).
    Fix: match motor_simple.ino exactly — RM_DRIVING only exits on dir==0.
    [pwm_test.ino]
2026-03-30 pwm_test: add RUN_BURST_SWEEP_TEST mode — 24-step burst duration sweep
    Automated hard-cut test: PWM=255, burst durations from 10 ms to 600 ms,
    both STBD and PORT for each step (48 runs total). Fine 5 ms steps around
    the ~55 ms hydraulic cracking threshold; coarser steps below and above.
    Single B3 press to start, fully automatic thereafter.
    Returns rudder to ADC=512 between every burst. Table columns:
    burst_ms, dir, start, final, counts_moved (includes hydraulic coast).
    OLED + button code refactored into shared guard so both interactive modes
    can use the display and B3 button.
    [pwm_test.ino]
2026-03-30 pwm_test: add RUN_FINE_BURST_TEST — 10-30ms x 1ms steps, 3 reps, both dirs
    Tests short burst durations to find the hydraulic cracking threshold with
    1 ms resolution. STBD direction starts from PORT limit; PORT direction
    starts from STBD limit. 3 reps per step, individual counts and avg printed.
    800 ms settle + wait_for_stop(2000) between reps. Single B3 press, fully auto.
    [pwm_test.ino]
2026-03-30 pwm_test: fix missing RUN_FINE_BURST_TEST in oled_show_centering_screen guard
    [pwm_test.ino]
2026-03-30 pwm_test: fine burst test — 15-25ms range, 10 reps per step
    Zoom in on the stochastic transition zone with 10x more samples per step.
2026-03-30 pwm_test: fine burst — consecutive reps, no reposition between bursts
    Reposition to limit once per burst_ms group only. The 10 reps within each
    group fire consecutively so hydraulic slack and line pressure stay primed
    in that direction throughout — giving consistent scatter data.
2026-03-30 pwm_test: fine burst — reposition once per direction, not per burst_ms group
    Single return_to_start at the top of run_fine_direction only. All 110 bursts
    (11 steps x 10 reps) fire consecutively in one direction with zero
    repositioning, keeping hydraulics primed throughout the entire direction run.
2026-03-30 pwm_test: fine burst — return to limit between groups, 100ms between reps
    Each burst_ms group returns to start limit once before its 10 reps.
    Within reps: motor_stop + delay(100) + read_rudder — no wait_for_stop,
    keeps hydraulics primed. After 10 reps: wait_for_stop(2000) before return.
    OLED updates each rep showing ms/dir/rep.
2026-03-30 pwm_test: fine burst — increase inter-rep delay 100ms → 250ms
2026-03-30 feat: add remote_control_test mode to pwm_test.ino + bridge RCT support
    - New RUN_REMOTE_CONTROL_TEST mode in pwm_test.ino: bridge-integrated
    positioning test with on-Nano ADJUST mode and TEST mode.
    - Bridge: new RCT frame codes, settings JSON persistence, TGT command,
    result logging, settings push on startup.
    - Characterise hydraulic rudder positioning accuracy using the actual
    production control path (bridge + remote) rather than serial-only.
    **How**
    - Nano runs at 38400 baud (bridge-compatible) in RCT mode; binary frames only.
    - 7 settings (pwm_max, coast_count_max, pwm_min, coast_count_min, pulse_ms,
    deadband, pulse_delay_ms) stored in Pi JSON (/etc/inno-pilot/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
2026-03-30 fix: add RUN_REMOTE_CONTROL_TEST to OLED #include guard (missed in initial commit)
    [pwm_test.ino]
2026-03-30 fix: forward RUD command also as RCT_TARGET_CODE to Nano
    Remote sends RUD in manual mode; test sketch expects RCT_TARGET_CODE.
    Now both are sent so the test sketch sees live target from remote stick.
    [inno_pilot_bridge.py]
2026-03-30 bridge: forward RCT_TARGET_CODE before mode gate in RUD handler
    Previously RUD bailed out immediately if not in MANUAL mode, so the
    Nano never received an RCT_TARGET_CODE frame after a bridge restart
    (before the remote re-sent MODE MANUAL), causing the Nano OLED to
    show "No target received" indefinitely.
    Fix: move the mode gate to after the RCT_TARGET_CODE send. The Nano
    always gets the live POT position from the remote; MANUAL_RUD_TARGET_CODE
    is still gated on MODE_MANUAL as before.
    [inno_pilot_bridge.py]
2026-03-30 rct: allow pulse_ms=0 for continuous fine-approach drive
    Lower bound of 'Pulse ms' setting changed from 5 to 0.
    When pulse_ms=0 the fine-pulse loop drives the motor continuously
    (no motor_stop between iterations) and stops only when inside the
    deadband or the 30-pulse cap is hit. motor_stop() is called
    unconditionally after the loop so the motor is never left running.
2026-03-30 rct: wait for hydraulic settle after each fine pulse, not flat delay
    Replacing delay(pulse_delay_ms) with wait_for_stop(pulse_delay_ms+400, 80)
    so position is only read once the rudder has actually stopped drifting.
    The flat delay caused premature re-pulses while the hydraulic tail was
    still moving, producing direction flips and oscillation around the
    deadband on small corrections.
    [pwm_test.ino]
2026-03-30 rct: fix final_adc noise + revert wrong hydraulic-settle change
    Two fixes:
    1. Save cur into final_adc at the deadband break instead of doing a
    fresh read_rudder() afterwards. The fresh read can differ by ±1-2
    ADC counts (noise), making the result display look like the rudder
    stopped just outside the deadband when it actually reached it.
    2. Revert wait_for_stop() back to flat delay(pulse_delay_ms). The
    hydraulic ram holds position solid after motor stop — no drift.
    The settle wait was based on a wrong assumption and added 400 ms
    of unnecessary latency per pulse.
    [pwm_test.ino]
2026-03-30 rct: add RATIFY mode — continuous real-time target chasing
    Long B3 now cycles three modes: TEST → ADJUST → RATIFY → TEST.
    RATIFY mode: the Nano continuously chases the remote POT position in
    real-time using the same algorithm and settings as TEST mode. The OLED
    shows live position vs target and "[ OK ]" when inside deadband.
    Results (stop/pulses/final) are sent to the bridge for logging.
    Long B3 in RATIFY returns to TEST mode.
    Also extracts the test loop into rct_test_mode() and adjusts OLED hint
    strings to show the next mode in the cycle.
2026-03-30 rct: display loop Hz in bottom-right corner of OLED screens
    Adds rct_tick_hz() — counts loop iterations per second, updated every
    1 s with static state shared across modes. Displayed right-aligned on
    the bottom row (y=56) of TEST and RATIFY idle/chasing screens.
    Useful for diagnosing slowdowns: normal idle rate is ~20 Hz (delay(50)
    bound); drops to near 0 Hz during a rct_run_test() blocking call.
2026-03-30 ratify: replace blocking rct_run_test with fast pulse-per-loop real-time steering
    RATIFY mode is now entered/exited by the remote AUTO/MANUAL switch
    (MANUAL_MODE_CODE=1/0) rather than a long B3 press.
    New rct_ratify_mode() loop:
    - OLED blanked on entry — no display overhead in the critical path
    - Three-zone control per iteration (no blocking waits):
    Zone 1 |err| <= deadband : motor_stop()
    Zone 2 |err| <= coast_count_max : 10 ms pulse at pwm_min
    Zone 3 |err| > coast_count_max : 10 ms pulse at pwm_max
    - Back-to-back 10 ms pulses give ~83% duty continuous motion when chasing
    - Direction re-evaluated after each pulse — overshoot self-corrects immediately
    - MANUAL_MODE_CODE=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
    [pwm_test.ino]
2026-03-30 read_rudder: reduce to 2 dummy + 2 real reads, average both
    Halves ADC read time (~0.8 ms -> ~0.4 ms per call) to tighten the
    ratify real-time control loop. 2-sample average is sufficient for
    control purposes in this sketch.
    [pwm_test.ino]
2026-03-30 pwm_test: activate RUN_REMOTE_CONTROL_TEST mode (was left on RUN_FINE_BURST_TEST)
2026-03-30 ratify: stream live rudder position and loop Hz back to remote (v1.2.0_B6)
    Nano → Bridge (new frame codes):
    RCT_RDR_PCT_CODE (0xF7): rudder position pct×10, every loop iteration
    RCT_HZ_CODE (0xF8): ratify loop Hz, once per second when value changes
    Bridge → Remote:
    RDR_PCT <pct> forwarded from RCT_RDR_PCT_CODE — drives existing rudder bar graphic
    HZ <value> forwarded from RCT_HZ_CODE — new message type
    Remote (inno_remote.c):
    g_bridge_hz global stores latest Hz
    HZ handler in on_bridge_rx()
    MODE handler clears g_bridge_hz when leaving MANUAL
    MODE line: "MODE: MANUAL 85Hz" when in_manual && g_bridge_hz > 0
    Deadband path throttled with delay(pulse_ms) to ke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
2026-03-30 ratify: OLED splash on entry + bridge RDR_PCT throttle to 20 Hz
    Nano: replace blank OLED with "REMOTE / CONTROLLED" splash screen on
    ratify entry (border, large title, divider, hint). OLED not touched again
    while ratify runs — static display for zero loop overhead.
    Bridge: throttle RDR_PCT forwarding to remote to 50 ms / 20 Hz. Prevents
    TCP send-buffer flooding when Nano ratify loop exceeds remote's 50 Hz
    refresh rate (e.g. at pulse_ms=1 the Nano sends ~640 frames/sec).
    [inno_pilot_bridge.py, pwm_test.ino]
2026-03-30 ratify: add B3 emergency exit + bridge startup MANUAL_MODE_CODE=0 safety send
    Two independent escape hatches for a stuck ratify mode:
    1. Bridge sends MANUAL_MODE_CODE=0 on startup (clears any ratify the Nano
    was left in from a previous session, before settings are pushed).
    2. B3 long-press (>=3s) exits ratify immediately regardless of serial state
    — hardware fallback when the remote switch cannot reach the bridge.
    [inno_pilot_bridge.py, pwm_test.ino]
2026-03-31 pwm_test: switch rudder ADC from Nano A2 to ADS1115 A0 (I2C 0x48)
2026-04-01 docs: add INSTALL.md — fresh Pi Zero 2W install guide
    Step-by-step guide covering OS selection, base packages, cloning
    the single inno-pilot repo (which contains full pypilot history),
    glue deploy, Nano firmware flash, and ESP32 remote firmware notes.
    Key correction: no separate pypilot clone needed — inno-pilot IS
    the fork; setup.py at repo root installs everything.
2026-04-01 feat: add browser-based web remote UI (port 8888)
    inno_web_remote.py — stdlib-only HTTP+SSE server that connects to
    inno-pilot-bridge on port 8555 as a TCP remote client and serves a
    single-page Inno-Remote UI at http://192.168.6.13:8888/.
    UI mirrors the physical remote: OLED panel, 5 heading buttons (±1°/±10°),
    STOP button, 3-position toggle (AUTO/OFF/MANUAL), draggable ship's wheel
    for manual rudder control. Works on phones, tablets, and desktop browsers.
    Also adds inno-pilot-web-remote.service, updates deploy script, INSTALL.md,
    and README.md.
2026-04-01 fix: bump Nano version string B5 -> B6 to match bridge
    INNOPILOT_VERSION and INNOPILOT_BUILD_NUM were not updated when the
    bridge moved to B6. Aligns all three components at v1.2.0_B6.
    [motor_simple.ino]
2026-04-01 web-remote: MODE OFF disconnects TCP bridge slot (v1.2.0_B7)
    - bridge_client(): checks _bridge_active in outer loop (no reconnect when OFF)
    and inner loop (drops live connection when OFF is triggered)
    - _handle_command(): MODE OFF handled locally — clears _bridge_active, drains
    _cmd_q, sets state to OFF, returns without forwarding to bridge; all other
    active commands call _bridge_active.set() to re-enable connection from OFF
    - JS handleToggleAction('off'): sends BTN TOGGLE / MODE AUTO first if needed,
    then MODE OFF after 300 ms to ensure preceding command reaches bridge before
    TCP connection is dropped
    - JS updateUI: suppress NO BRIDGE overlay when mode is OFF (intentional);
    sh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
2026-04-02 fix: bump web remote version to v1.2.0_B7
    Missed in previous commit — INNOPILOT_VERSION constant was still B6.
    [inno_web_remote.py]
2026-04-02 feat: bump Nano version to v1.2.0_B7
    Version bump to reflect revert from 16-bit ADS ADC back to Nano's
    native 10-bit ADC — confirmed no ADS remnants remain.
    [motor_simple.ino]
2026-04-02 fix: stale socket reconnect + B7 OTA binary
    - Bridge: accept reconnect from same IP instead of rejecting with
    "already connected". Fixes ESP32 getting stuck after OTA reboot.
    - OTA binary: rebuild inno_remote.bin at v1.2.0_B7.
    [inno_pilot_bridge.py]
2026-04-02 feat: enlarge toggle switch and swap label/switch sides (v1.2.0_B8)
    - Toggle track doubled in size (22×74 → 38×126 px)
    - Lever doubled (20×20 → 34×34 px)
    - Labels moved to left, switch track to right edge via flex row-reverse
    - Detent marks and lever positions scaled proportionally
    [inno_web_remote.py]
2026-04-02 feat: OLED data row + version/conn layout rework (v1.2.0_B10)
    - oled-data row always shows Head / RDR / CMD left-to-right; no conditional switching
    - Version moved to fixed bottom-left, brightened to #5dd0f0
    - Connection status moved to fixed bottom-centre at 1.5× font size
    - JS simplified: all three metrics updated independently on every telemetry tick
    [inno_web_remote.py]
2026-04-02 Revert "feat: OLED data row + version/conn layout rework (v1.2.0_B10)"
    This reverts commit 62947e677b56ba5b3e355e703c15475da24333ab.
    [inno_web_remote.py]
2026-04-02 feat: metrics row Head/RDR/CMD always visible + ver/conn layout (v1.2.0_B10)
    - oled-data row: always shows Head, RDR, CMD left-to-right; no conditional switching
    - Version (o-ver): fixed bottom-left of screen, bright cyan #6ee0ff
    - Connection status (o-conn): fixed bottom-centre, 1.5x font size (0.945em)
    - Both moved to top-level body elements so fixed positioning is unambiguous
    [inno_web_remote.py]
2026-04-02 fix: ver/conn bottom-bar in normal flow, not fixed (v1.2.0_B11)
    position:fixed caused elements to disappear on mobile. Use a
    bottom-bar flex row inside .remote instead — version left-aligned,
    conn absolutely centred within the bar.
    [inno_web_remote.py]
2026-04-02 fix: oled-status back inside OLED panel, ver left / conn centred (v1.2.0_B12)
    Version and connection status belong on the bottom row of the OLED
    screen area, not outside the remote. Restored oled-status inside the
    .oled div; version is left-aligned bright cyan, conn is absolutely
    centred at 1.5x the previous font size.
    [inno_web_remote.py]
2026-04-02 feat: OLED/button aesthetics (v1.2.0_B13)
    - Reorder metric row: CMD, RDR, Head (left to right)
    - Remove graphical OLED button row from OLED screen area
    - Physical buttons: AUTO=-10/-1/Go/+1/+10, OFF=blank, MANUAL=arrows
2026-04-02 feat: web remote OLED 2× text + AUTO mode AP toggle (v1.2.0_B14)
    - Double all OLED panel font sizes for readability
    - AUTO toggle now enters auto-ready state with AP OFF by default;
    user presses Go (middle button) to engage/disengage AP
    - OLED mode line shows MODE: AP ON / MODE: AP OFF in AUTO mode,
    with "AP" rendered at 1.5× the surrounding text size
    - OFF toggle only sends BTN TOGGLE when AP is actually engaged (gApOn)
2026-04-02 fix: revert OLED font sizes + fix AUTO button labels (v1.2.0_B15)
    - Revert all OLED font sizes back to original (doubled sizes undone)
    - Introduce gTogglePos ('auto'/'off'/'manual') to drive toggle UI
    independently of bridge mode telemetry
    - Button labels now always visible when toggle is in AUTO or MANUAL
    position, regardless of AP engaged state
    [inno_web_remote.py]
2026-04-02 fix: OLED AP OFF→IDLE, bottom-align AP label, sync bridge version (v1.2.0_B16)
    - AUTO mode with AP off now shows MODE: IDLE (not AP OFF);
    only AP ON gets the enlarged AP label treatment
    - AP label vertical-align changed to bottom so all characters
    in MODE: AP ON sit on the same baseline
    - Bridge version bumped from B7 to B15 (was never incremented
    alongside web remote; displayed version now matches)
    - Web remote bumped to B16
    [inno_pilot_bridge.py, inno_web_remote.py]
2026-04-02 fix: stable mode-row height, bold data+status lines (v1.2.0_B18)
    - oled-mode row now uses line-height:1.5 + flex/align-items:flex-end
    to pre-reserve the AP label height; layout no longer shifts when
    AP ON appears or disappears
    - oled-data (CMD/RDR/Head) now bold
    - #o-conn (CONNECTED/OFFLINE/COMMS WARN etc.) now bold
    [inno_web_remote.py]
2026-04-02 fix: suppress NO BRIDGE flash when switching from OFF (v1.2.0_B19)
    The server's optimistic update on MODE AUTO/MANUAL briefly sets
    connected=false + mode=IDLE, which triggered the overlay.
    Suppress the overlay whenever gTogglePos != 'off' so the flash
    is gone while the bridge reconnects.
    [inno_web_remote.py]
2026-04-02 feat: manual-mode jog buttons in web remote (v1.2.0_B20)
    In MANUAL mode the five hw-buttons now jog the rudder via RUD commands:
    - B1 «: press = −10% port jog; hold = continuous −10% every 200 ms
    - B2 ‹: press = −1° port jog; hold = repeat every 500 ms
    - B3 |: press = centre rudder (RUD 50.0)
    - B4 ›: press = +1° stbd jog; hold = repeat every 500 ms
    - B5 »: press = +10% stbd jog; hold = continuous +10% every 200 ms
    Hold repeat starts after a 300 ms delay; repeating stops automatically at
    limits (0% / 100%). Wheel drag and button jogs share gManualRudPct so the
    wheel stays in sync. On entering MANUAL the commanded position initialises
    from actual rdr_pct telemetry (not always mi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
2026-04-02 chore: remove legacy and exploratory sketches
    - motor_IBT2_pypilot.ino (upstream pypilot firmware, never deployed)
    - echo_upper.ino (serial loopback test, purpose complete)
    - measure_rudder_limits.ino (standalone limit finder, superseded by motor_simple)
    - motor_main/motor.ino (legacy bang-bang draft, never used)
2026-04-02 chore: sync all components to v1.2.0_B20
    Bridge was at B15, Nano and ESP32 Remote were at B7. inno_web_remote
    was already at B20. Aligning all four to B20.
2026-04-02 chore: update OTA binary to v1.2.0_B20
    Rebuilt inno_remote.bin from source with version bumped to B20.
    Bridge will serve this to the ESP32 remote on next HELLO mismatch.
2026-04-03 feat: settings menu in web remote (v1.2.0_B21)
    - Add gear-cog settings button (bottom-left of remote, OFF mode only)
    - Settings panel: Network (IP/DHCP), Wi-Fi, Vessel, Features on/off,
    Autopilot tuning, Safety thresholds — saved to /var/lib/inno-pilot/settings.json
    - Physical buttons remap in settings: B1=OFF B2=PREV B3=SET B4=NEXT B5=ON
    - Pressing gear in non-OFF mode flashes amber toast warning
    - Sync all components to v1.2.0_B21 (bridge B21, Nano B21, ESP32 B21, web-remote B21)
2026-04-04 refactor: settings panel — tap-to-edit, remove physical button nav
    Replace B1-B5 keyboard navigation with direct interaction:
    - Tapping a text/number field focuses it (opens device keyboard)
    - Tapping an enum value toggles it between its two states
    - Bool ON/OFF buttons remain click-only as before
    - Remove sfFocus, sfNav, sfToggle, handleSettingsBtn, gSfIdx
    - Remove setToggle/onPress overrides for settings mode
    - Header hint updated to "Tap a field to edit • SAVE to apply"
    [inno_web_remote.py]
2026-04-04 feat: settings integration — bridge owns settings, web-remote delegates
    - Add PILOT_SETTINGS_PATH (/var/lib/inno-pilot/settings.json) with
    default structure: network, wifi, vessel, features, autopilot, safety
    - Load settings at startup; apply deadband + future tuning params
    - Handle SETTINGS GET — reply with full settings as compact single-line JSON
    - Handle SETTINGS SET <json> — merge, save to file, apply, reply SETTINGS OK/ERR
    - Send DB <pct> to remote on HELLO connect (from live settings)
    - Move import json/copy to module level
    Web-remote (inno_web_remote.py):
    - GET /settings: send SETTINGS GET via TCP, wait up to 4s for bridge reply;
    fall back to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
2026-04-04 feat: CONNECTIONS & FEATURES gates — bridge sends FEATURES_CODE to Nano; Nano conditionally enables sensors and alarms (v1.2.0_B22)
    - New FEATURES_CODE = 0xEF (Bridge->Nano) carries a uint8 bitmask of 5 feature bits
    - Bridge: send_features_to_nano() builds mask from settings.features; called at startup + on SETTINGS SET
    - Nano: feature_flags runtime variable (default 0x00 = all off until bridge configures)
    - Replaces hardcoded LIMIT_SWITCHES_ACTIVE = false constant
    - FEATURES_CODE handler in process_packet() sets feature_flags and configures D7/D8 pins on demand
    - FEATURE_PI_VOLTAGE: guards A3 Pi supply voltage reads and pi_fault/pi_overvolt/pi_undervolt
    - FEATURE_BATTERY_VOLTAGE: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
    [inno_pilot_bridge.py, inno_remote.c, inno_web_remote.py, motor_simple.ino]
2026-04-04 fix: reset stale command on DISENGAGE to prevent motor running with remote OFF
    When AP was disengaged (DISENGAGE_CODE), last_command_val was not reset to
    neutral (1000). For up to 5 s (command_recent window) the delta-based manual-
    jog check in update_motor_from_command() would see the stale non-neutral AP
    command, set manual_jog_active=true, engage the clutch, and drive the motor —
    even though ap_display=false (OLED: "Helm: HAND") and remote_manual_active=false.
    Fix: set last_command_val=1000 and last_command_ms=0 in the DISENGAGE_CODE
    handler so delta=0 and command_recent=false immediately after disengage.
    Bumped all components to v1.2.0_B23.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
    [inno_pilot_bridge.py, inno_remote.c, inno_web_remote.py, motor_simple.ino]
2026-04-04 fix: stop motor immediately on STOP press and BTN AP-off (Helm: HAND guarantee)
    Two cases where ap_display=false (OLED: HAND) but ap_enabled_remote was still
    true, causing the motor to keep driving for up to ~2s until the bridge sent
    DISENGAGE_CODE back:
    1. STOP press: cleared ap_display but not ap_enabled_remote.
    2. BTN_B3 AP toggle-off: flipped ap_display to false but left ap_enabled_remote
    unchanged until remote confirmation.
    Fix: set ap_enabled_remote=false immediately in both cases. The 2s override
    window is kept so the OLED stays on HAND while awaiting bridge round-trip;
    when DISENGAGE arrives, ap_enabled_remote is already false (no-op).
    Invariant: Helm: HAND on OLED => motor ca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
    [inno_pilot_bridge.py, inno_remote.c, inno_web_remote.py, motor_simple.ino]
2026-04-04 Adjust VOLTAGE_SCALE calibration for .12 hardware
2026-04-04 fix: deploy script uses sudo arduino-cli on Pi .12 (root core)
    Pi .12 has the arduino:avr core under /root/.arduino15, not under
    the innopilot user. Auto-detect at runtime: if innopilot's arduino-cli
    can see the arduino:avr core use it directly; otherwise fall back to
    sudo. Prevents arduino-cli from downloading the full core as innopilot,
    which OOM'd the Pi during the first deploy attempt.
2026-04-04 fix: detect arduino core via filesystem, not arduino-cli core list
    arduino-cli core list downloads package indexes on first run, silently
    consuming memory through a pipe (grep swallows all output). On a Pi with
    no ~/.arduino15 this OOM'd the board twice. Replace with a simple
    directory existence check which is instant and causes no downloads.
    Also move function definitions before the detection block so log() is
    defined when called.
2026-04-04 feat: add H-bridge pin-state telemetry to expand debug diagnostics (B25)
    Add PIN_STATE_CODE (0xE1) sent by Nano on every D2/D3/D9 change.
    - New PIN_STATE_CODE = 0xE1 constant (bits: [2]=D9/EN, [1]=D3/LPWM, [0]=D2/RPWM)
    - After each update_motor_from_command(), sample digitalRead() on D2, D3, D9;
    send frame only when state changes (on-change, not periodic)
    - PIN_STATE_CODE constant added alongside BUTTON_EVENT_CODE
    - New handler decodes D2/D3/D9 bits, logs direction (PORT/STBD/STOP) at DEBUG
    With DEBUG logging enabled (SIGUSR1), the bridge now logs every motor start,
    stop, and direction change with exact timing. This lets us determ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
2026-04-04 diag: add MOTOR_REASON_CODE (0xEE) to identify motor activation path (B26)
    When the motor activates unexpectedly with Helm:HAND set, the existing
    PIN_STATE_CODE (B25) confirms D9 goes HIGH but gives no clue which code
    path triggered it. MOTOR_REASON_CODE is sent once when D9 transitions
    LOW→HIGH, encoding:
    bits [3:0]: reason (1=manual_phys, 2=delta_jog, 3=ap, 4=rm_drive, 5=rm_brake)
    bit 4: ap_enabled_remote at activation time
    bit 5: command_recent at activation time
    bit 6: pi_alive at activation time
    bit 7: manual_override (physical button) at activation time
    bits [15:8]: last_command_val >> 3 (≈ 0-250; 125 = neutral 1000)
    Bridge decodes and logs at DEBUG level immediat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
2026-04-04 fix: add explicit forward declarations for ctags-independent builds (B26)
    arduino-cli auto-generates forward declarations via ctags. On aarch64 Pi 5
    after a fresh install the bundled ctags binary is empty, causing compilation
    to fail with "send_frame was not declared". Adding send_frame, show_overlay
    and send_button_event to the manual forward-declarations block makes the
    sketch build correctly without ctags on any host.
    [motor_simple.ino]
2026-04-05 fix: gate button ADC behind FEATURE_ON_BOARD_BUTTONS to prevent false motor activation in HAND mode
    [ads1115_test.ino, ads1115_test.py, inno_pilot_bridge.py, inno_web_remote.py, motor_simple.ino]
2026-04-05 Inno-Web-Remote SETTINGS On-Board Buttons fixed.
    [inno_pilot_bridge.py, inno_web_remote.py, motor_simple.ino]
2026-04-05 Inno-Web-Remote changed to four button version.
2026-04-05 Fix REMOTE takeover alert gating and stale owner lock
    [inno_web_remote.py]
2026-04-05 Fix web-remote OFF mode bridge idle state race
    [inno_web_remote.py]
2026-04-05 feat: add TEST button and hardware test catalogue to web remote (v1.2.0_B30)
    Adds a TEST button next to the gear/settings button in the web remote UI.
    Clicking it opens a full test catalogue of all 8 pwm_test.ino routines with
    descriptions, purpose, expected output, firmware requirements, and a YES/NO
    confirmation before running. Results stream live via SSE when supported.
    Also adds bridge-side TEST command pass-through (writes plain-text TEST <id>
    to Nano serial) and a parallel text-relay loop that forwards TEST_LINE / TEST_DONE
    lines from the Nano back to remote clients when test_mode is active.
    Note: actual test execution requires pwm_test.ino to be flashed with the
    appropriate #define.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
2026-04-05 fix: remove literal newlines from JS string literals in TESTS array
    Python escape sequences \n inside the _HTML triple-quoted string were
    converted to actual newline characters at parse time, producing multi-line
    JS string literals — a JS syntax error that silently broke the entire
    script block and prevented the SSE updateUI from running (overlay stayed).
    Replaced all embedded \n separators in fw/output fields with spaces.
    [inno_web_remote.py]
2026-04-05 Fix web-remote no-bridge overlay recovery behavior
    [inno_web_remote.py]
2026-04-05 Fixing Remote restart issues. Second attempt.
    [inno_web_remote.py]
2026-04-05 Fixing Remote restart issues. Third attempt.
    [inno_web_remote.py]
2026-04-05 Fixing Remote restart issues. Fourth attempt.
    [inno_web_remote.py]
2026-04-05 Fixing Remote restart issues. Fifth attempt.
    [inno_web_remote.py]
2026-04-05 Fixing Remote restart issues. Sixth attempt.
    [inno_web_remote.py]
2026-04-13 Fix for the Build number alignment.
    [inno_pilot_bridge.py]
2026-04-13 Fix OTA_SERVER_HOST hardcoded IP — auto-detect Pi LAN IP at startup
    OTA_SERVER_HOST was hardcoded to 192.168.6.13 (Pi Zero dev boat), which
    caused the bridge on .12 (Pi5) to advertise the wrong OTA download URL
    and attempt pypilot connections to the wrong host.
    Replace with _local_ip() which probes the routing table at startup to
    return the Pi's own LAN IP, making the code work on any installation
    regardless of fixed IP address.
    [inno_pilot_bridge.py]
2026-04-13 Fix Nano UART cold-boot: pulse DTR on bridge startup
    On cold boot, DTR starts LOW. open_serial_no_reset() keeps it LOW so
    no transition occurs, and the CH340 USB-serial chip never triggers the
    Nano's RC-differentiator reset circuit. As a result the Nano's UART TX
    does not drive the line and the bridge receives nothing from the Nano.
    Fix: explicitly pulse DTR HIGH→LOW (150 ms) immediately after opening
    the Nano port. HUPCL is already cleared, so this is the only reset the
    Nano will see during normal bridge operation. Extend the post-open wait
    from 1 s to 2 s to give the Nano comfortable time to complete setup().
    [inno_pilot_bridge.py]
2026-04-13 Docs: document Pi5/Bookworm reinstall findings and three B35 fixes
    - CHANGELOG: add B35 entry covering OTA IP auto-detect, Nano cold-boot
    DTR pulse, and Flask Markup import guard
    - INSTALL.md: add Appendix A (Pi5/Bookworm reinstall guide) covering
    PEP 668 workaround, setup.py vs pip, pypilot_client.conf stale IP fix,
    cold-boot Nano UART note, and Flask 2.3+ note
    - CLAUDE.md (project): add known issues for pypilot_client.conf stale IP,
    PTY EBUSY (unresolved), and Flask Markup (fixed in source)
    - compute_module/glue/CLAUDE.md: add critical section on Nano UART
    cold-boot DTR pulse requirement and the risk of removing it
2026-04-14 Fix EEPROM write timing: flush + delay before Nano reboot
    The bridge was sending EEPROM_WRITE_CODE frames and immediately
    triggering a DTR reboot. The OS serial buffer hadn't fully drained
    to the CH340 USB-serial chip, so the Nano rebooted before receiving
    all EEPROM data. Added nano.flush() + 0.5s delay after the last
    frame to ensure all bytes are transmitted before the reset.
    [inno_pilot_bridge.py]
2026-04-18 Fix Rudder direction sign inconsistencies
    [inno_pilot_bridge.py]
2026-04-18 Add invert clutch logic for oppositely wired relays.
    [inno_pilot_bridge.py, inno_web_remote.py, motor_simple.ino]
2026-04-18 Add invert clutch logic for oppositely wired relays Fix1.
    [inno_web_remote.py]
2026-04-18 Rudder position bug fix when REMOTE mode is selected.
    [inno_web_remote.py]
2026-04-18 Web Remote Helm wheel direction inverted.
    [inno_web_remote.py]
2026-04-19 Revert "Web Remote Helm wheel direction inverted."
    This reverts commit 36352cc2bd040d0b62237c3e09b07ee36a82c53d.
    [inno_web_remote.py]
2026-04-19 Web Remote Helm wheel direction inverted. Try 2 version _B41
    [inno_pilot_bridge.py, inno_web_remote.py, motor_simple.ino]
2026-04-19 Web Remote Helm wheel direction inverted. Try 3 version _B42
    [inno_pilot_bridge.py, inno_web_remote.py, motor_simple.ino]
2026-04-19 Nano B43: fix clutch safe-start — read EEPROM before pin init
    Move eeprom_load_settings() to the very first statement in setup() so
    feature_flags (including FEATURE_INVERT_CLUTCH) is known before any pin
    is configured. Change clutch pin init to the AVR safe-start pattern:
    pre-load the PORT latch with the correct disengaged level, then enable
    OUTPUT mode, so the pin never glitches to the engaged state regardless
    of relay polarity.
    [motor_simple.ino]
2026-04-19 Bump bridge and web-remote to v1.2.0_B43
    Version alignment with motor_simple.ino B43 (clutch safe-start fix).
    [inno_pilot_bridge.py, inno_web_remote.py]
2026-04-19 B44_Add Setting for Motor Direction inversion. Setting activation not implemented yet.
2026-04-19 motor_simple.ino code made direction agnostic using DIRA and DIRB.
2026-04-19 entire feature of the OLED showing B---I---A to be removed from motor_simple.ino.
2026-04-19 Saving of three important Pypilot Rudder Metric Settings.
2026-04-19 Fix REMOTE mode startup conditions
    [inno_pilot_bridge.py, inno_web_remote.py, motor_simple.ino]
2026-04-19 Fix REMOTE mode startup conditions for helm position mirror image
    [inno_pilot_bridge.py, inno_web_remote.py, motor_simple.ino]
2026-04-28 Fix inno_deploy.sh to handle multiple ARM architectures.
2026-04-28 Fix inno_deploy.sh to handle multiple ARM architectures_ Try2.
2026-04-29 Add triangles to inno_web_remote rudder position graphic bar
2026-04-29 Add RAM Test feature: reciprocating rudder sweep test via bridge + web remote
2026-04-29 Fix inno_web_remote.py: strip UTF-8 BOM that broke shebang exec on Pi
    The file was saved with a UTF-8 BOM (\xEF\xBB\xBF) which the Linux kernel
    cannot parse as a valid shebang, causing Exec format error (status=203/EXEC)
    on every service start.
    [inno_web_remote.py]
2026-04-29 inno_deploy.sh: drain serial RX buffer before flash, add upload retry
    When the bridge stops (Step 3) HUPCL resets the Nano, which then runs its
    firmware and fills the kernel serial RX buffer with telemetry frames. Those
    buffered bytes can corrupt avrdude's bootloader dialogue causing
    "programmer is out of sync" during paged_write. Fix: drain the buffer with
    a non-blocking dd read (no DTR/HUPCL side-effect), then retry once on failure.
2026-04-29 Add Jog buttons...
2026-04-30 Fix inverted Pypilot commands to Nano
    [inno_pilot_bridge.py, inno_web_remote.py, motor_simple.ino]
2026-04-30 Fix Go button change to On Off
    [inno_web_remote.py]
2026-04-30 Fix Go button change to On Off_Try2
    [inno_pilot_bridge.py]
2026-05-01 Remove Rudder percetage line below helm wheel
2026-05-01 Test for Rudder stopped responding.
2026-05-02 TEST: hold-to-extend nudge buttons (min 500ms, hold to extend) — B64
    Bump all components to v1.2.0_B64.
    Behaviour change (web UI only):
    - Nudge buttons now send a NUDGE heartbeat immediately on press, then
    every 200 ms while the button is held down.
    - Bridge resets nudge_until to now+500ms on every received NUDGE, so
    the motor jog continues for as long as the button is held.
    - On release (mouseup / touchend / touchcancel) the interval is cleared
    and the nudge expires naturally after at most 500 ms — the minimum.
    - Button tooltips updated to reflect the new behaviour.
    Bridge: comment and log message updated; no logic change required.
    Nano: version bump only.
    Revert: git revert <t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
    [inno_pilot_bridge.py, inno_web_remote.py, motor_simple.ino]
2026-05-02 Add debounce on motor start to prevent BAD Voltage fault
    [inno_pilot_bridge.py, motor_simple.ino]
2026-05-03 Add debounce on jog buttons to eliminate accidental quick presses.
2026-05-03 Increase debounce on voltage sag. Grey out REMOTE button.
    [inno_pilot_bridge.py, inno_web_remote.py, motor_simple.ino]
2026-05-03 Added Debug button to start and stop debugging.
2026-05-04 Added Telegram messages with Debug button presses.
2026-05-05 Fixed NO BRIDGE issue.
    [inno_pilot_bridge.py, inno_web_remote.py, motor_simple.ino]
2026-05-05 Fixed NO BRIDGE issue_Try2.
    [inno_pilot_bridge.py, inno_web_remote.py, motor_simple.ino]
2026-05-05 Fixed NO BRIDGE issue_Try3.
    [inno_pilot_bridge.py, inno_web_remote.py, motor_simple.ino]
2026-05-05 Fixed CHECK for updates issue. Try2
    [inno_pilot_bridge.py, inno_web_remote.py, motor_simple.ino]
2026-05-05 Fixed CHECK for updates issue. Try3
    [inno_web_remote.py]
2026-05-05 Fixed CHECK for updates issue. Try4
    [inno_pilot_bridge.py, inno_web_remote.py, motor_simple.ino]
2026-05-06 Harden dependencies.py for Bookworm / Python 3.12+ (PEP 668)
    - Remove pip_only flag from flask-socketio; use apt python3-flask-socketio instead
    - Fix apt name mapping for python-socketio (was python3-python-socketio)
    - Add apt_remap dict for all packages whose apt name differs from python3-{name}
    - Add _pip_extra_flags() to detect EXTERNALLY-MANAGED and pass
    --break-system-packages to pip as last resort on Bookworm
    - Fix RTIMULIB2_dep.test() to use stdlib importlib.metadata (Python 3.8+)
    with fallback to importlib_metadata pip package
    - Remove importlib_metadata as a separate dependency subsystem (stdlib on 3.8+)
    - Fix INSTALL.md: setup.py path is compute_module/pypilot/, not repo root;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
2026-05-07 Add single-command bootstrap installer (install.sh)
    Runs the full fresh-install sequence on any Raspberry Pi OS Lite
    (Bullseye or Bookworm, any Pi model) from one curl command:
    curl -fsSL https://raw.githubusercontent.com/aviljoenn/inno-pilot/master/install.sh | bash
    Phases:
    1. Detect Pi model, OS codename, Python version
    2. Install correct apt packages for OS (Bullseye vs Bookworm)
    3. Clone or pull repo
    4. sudo python3 setup.py install (pypilot)
    5. Install arduino-cli + arduino:avr core
    6. deploy_inno_pilot_glue.sh
    7. Init pypilot config dir + set servodevice path
    8. Fix pypilot_client.conf on Bookworm
    9. Auto-reboot (10 s countdown, Ctrl-C cancellable)
    Idempotent: sa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
2026-05-07 Fix install.sh: arduino-cli path and trixie OS detection
    - Use BINDIR env var + mktemp to control arduino-cli install location,
    fixing the mv failure when CWD was inside the repo after setup.py
    - Add 'trixie' (Debian 13 / Raspberry Pi OS latest) to the modern-OS
    branch alongside 'bookworm', so PEP 668 / Flask apt packages are
    pre-installed correctly on trixie machines
    - Lowercase VERSION_CODENAME for case-insensitive matching
2026-05-07 Expand README Getting Started with full install guide
    Adds step-by-step instructions from SD card flash through to
    verified running services, covering:
    - Raspberry Pi Imager settings (hostname, SSH, Wi-Fi)
    - Single curl command to kick off the automated installer
    - What the installer does and how long to expect it to take
    - Post-reboot service verification and web remote URL
    - Nano firmware flash commands
    - ESP32 remote note
    - Link to INSTALL.md for detailed reference
2026-05-07 Fix arduino-cli BINDIR pipe bug; fix trans-po.py +x; add DEBIAN_FRONTEND=noninteractive
2026-05-07 Detect and adapt installation for various Arduino types.
2026-05-07 Fix detect_arduino.sh: stderr-only logs, filter PTY candidates
2026-05-07 Consumer-side refactor: bridge/fixlink/deploy/install read board.conf
    [inno_pilot_bridge.py]
2026-05-07 Phase 4: install Arduino libraries (SSD1306Ascii/OneWire/DallasTemperature)
2026-05-08 Fixed OTA address. Linking ESP32 remote back into the ecosystem.
    [inno_pilot_bridge.py, inno_remote.c, inno_web_remote.py, motor_simple.ino]
2026-05-08 Fixed inno_deploy failing due to file ownership conflict.
    [inno_pilot_bridge.py, inno_remote.c, inno_web_remote.py, motor_simple.ino]
2026-09-15 Verify I2C enable actually persists to config.txt in install.sh
    raspi-config nonint do_i2c 0 can exit 0 without writing the dtparam
    line to config.txt. Found on Dyason (Pi Zero unit) on 2026-09-15: its
    boot partition had /boot/firmware/config.txt with i2c_arm still
    commented out, even though its rootfs already had i2c-tools installed
    and the full inno-pilot app stack deployed and running — the silent
    no-op went unnoticed because the script trusted the exit code.
    Root cause is most likely that the card's boot partition was
    re-imaged/customized (e.g. via Raspberry Pi Imager, for a new SSID)
    separately from its rootfs, resetting config.txt to stock defaults
    without re-running install.sh's I2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
2026-09-17 Document I2C verify fix in CHANGELOG
    Adds an Unreleased entry for the raspi-config nonint do_i2c 0 write
    verification added to install.sh/INSTALL.md. Installer-only change,
    no version-synced component (Nano/Bridge/Remote) touched, so no
    INNOPILOT_VERSION bump per the existing changelog policy.
2026-09-17 Disable pypilot's self-announcing zeroconf (mDNS conflict with avahi)
    pypilot's server.py started its own IPv4 mDNS responder (python-zeroconf)
    purely to advertise "_pypilot._tcp.local." for pypilot-client
    auto-discovery. It binds the same UDP 5353 socket as the system
    avahi-daemon, and the two compete to answer mDNS queries -- avahi logs
    "Detected another IPv4 mDNS stack running on this host... makes mDNS
    unreliable" at startup. Diagnosed on Dyason (192.168.6.144) as the cause
    of intermittent "Inno-Pilot.local" resolution failures on the LAN
    (IPv6 mDNS was unaffected since pypilot's responder is V4Only).
    Nothing in Inno-Pilot's bridge/web stack discovers pypilot via zeroconf
    (they connect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
    [server.py]
2026-09-17 CLAUDE.md: firm rule — deployment always via inno_deploy.sh
    Add an explicit rule that no component's own install/build tooling
    (setup.py, arduino-cli upload, pio upload, etc.) should ever be hand-run
    against a live Inno-Pilot instance. inno_deploy.sh on the Pi is the only
    sanctioned deploy path -- it encodes ordering and safety guards (freeing
    /dev/ttyUSB0 before flashing, the pypilot two-pass setup.py workaround,
    service restart sequencing) that get silently skipped if a step is
    reproduced ad hoc, even when that single step is done correctly in
    isolation.
    Prompted by starting to hand-run pypilot's two-pass setup.py install on
    Dyason during PR #68's testing -- caught and corrected before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
2026-09-17 Disable pypilot signalk.py's zeroconf auto-discovery (mDNS conflict, round 2)
    signalk.py's ZeroConfProcess ran its own IPv4 mDNS responder
    (python-zeroconf, scanning for "_http._tcp.local.") to auto-discover a
    SignalK server, competing with avahi-daemon on UDP 5353 -- avahi still
    logged "Detected another IPv4 mDNS stack running on this host" after
    PR #68 disabled server.py's self-announcement, because this was a
    second, independent zeroconf user.
    Unlike the self-announcement, SignalK integration is a real, wanted
    feature -- Inno-Pilot's architecture is one central, known SignalK Pi
    that every instance subscribes to (servo_motor_control/docs/ARCHITECTURE.md),
    not ad hoc LAN discovery. It's t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
2026-09-17 Pin bridge's pypilotClient() to 127.0.0.1 (mDNS conflict, round 3)
    After PR #68 and #70, avahi still logged "Detected another IPv4 mDNS
    stack running on this host" -- the third and final source was our own
    inno_pilot_bridge.py, not the pypilot fork. pypilot_worker() called
    pypilotClient() with no host argument; pypilot's client.py sets
    can_probe = not host, so an empty host makes every (re)connect import
    python-zeroconf and scan for "_pypilot._tcp.local." -- the client-side
    counterpart of the server.py/signalk.py sources already fixed.
    Bridge and pypilot always run co-resident on the same Pi at a fixed
    port, so no discovery was ever needed. Pin the host explicitly:
    pypilotClient('127.0.0.1'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
    [inno_pilot_bridge.py]
2026-09-18 Add Nano loop profiling (B8) and require --clean for Nano builds
    Instruments the Nano main loop to find what blocks it long enough for the
    UART RX buffer to overflow. Every CRC error observed on Dyason fell on a
    ~1.0086 s grid, but both oled_draw() and temp_service() run on a 1000 ms
    period, so timing alone cannot tell them apart — hence per-component
    measurement rather than more inference.
    Nano (v1.3.3_B7 -> B8): 13 metrics on free codes 0xD0-0xDC — per-component
    worst-case durations, loop max/mean, and RX buffer pressure. Emitted one
    frame per loop pass every 5 s so a burst stays inside the 64-byte TX buffer.
    Measurement only; no control behaviour changes.
    Bridge: decodes the new cod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
    [inno_pilot_bridge.py, motor_simple.ino]
2026-09-19 Rescale oled_draw and loop profiling to 4 us units (B9)
    B8's first run on Dyason returned oled_draw pinned at 65535 us on BOTH max
    and mean, so its real duration was invisible — only known to be >= 65.5 ms.
    loop max was pinned for the same reason, since one oled_draw pass dominates
    the iteration it lands in.
    Two causes, both fixed: the max slots were uint16 microseconds, and the mean
    was accumulated through prof_clamp() so every sample was truncated to 65535
    before summing. Accumulators are now 32-bit true microseconds and are scaled
    only at report time.
    oled_draw and loop (0xD0, 0xD1, 0xD6, 0xD7) now report in 4 us units, which
    micros() already quantises to on AVR — so this costs no p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
    [inno_pilot_bridge.py, motor_simple.ino]
2026-09-19 Add I2C bus timeout and raise I2C to 400 kHz (B10)
    Two lines, +40 bytes of flash, addressing one safety defect and the root of
    the RX-buffer overflows.
    SAFETY — I2C bus timeout. The AVR Wire library ships with timeout checking
    disabled; twi.c sets twi_timeout_us = 0 and its own comment says a non-zero
    value "prevents the code from getting stuck in various while loops". With it
    off, endTransmission() blocks forever if SDA or SCL is held low — a stuck
    slave, a loose OLED connector, an EMI transient. There is no watchdog in this
    sketch, so the Nano never recovers; and because it holds the H-bridge pins it
    would freeze the motor in whatever state it was driving. A display fault must
    not be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
    [motor_simple.ino]
2026-09-19 Skip unchanged OLED rows via a row shadow (B11)
    oled_draw() rewrote 7 of 8 rows every second — ~900 bytes of I2C — even though
    rows 1, 2 and 5 are blank in steady state and the rest usually differ by a
    digit or not at all. Every row costs a full ~128 bytes because clearToEOL()
    pads to the end of the line regardless of text length.
    B10 showed a faster bus cannot finish this job. Solving bus + overhead = 184 ms
    (100 kHz) against bus/4 + overhead = 80 ms (400 kHz) puts ~45 ms in fixed
    Wire-library and ADC overhead that does not scale with bus clock. The only
    lever left is sending fewer bytes.
    Rows are now compared as rendered text against an 8x22 shadow and written only
    when they change,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
    [motor_simple.ino]
2026-09-19 Sync bridge and web-remote versions to B11
    The Nano sketch was bumped B7 -> B11 across the profiling and oled_draw work
    without bringing the other versioned components with it, which CLAUDE.md step 6
    requires. That is a live defect, not just untidiness.
    The Nano compares bridge_build_num against its own INNOPILOT_BUILD_NUM and
    flashes "!VER MISMATCH!" / "Pi:B7 Nano:B11" on rows 1-2 when they differ. Two
    consequences:
    1. That warning sits ABOVE comms_warn, rudder-overshoot and ap-pressed in the
    row 1-2 priority chain, so it was masking any genuine warning underneath it.
    2. It forced rows 1-2 down a message path every second, invalidating the B11 row
    shadow for both rows and suppressin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
    [inno_pilot_bridge.py, inno_web_remote.py]
2026-09-19 Document B11 OLED/I2C work: invariants, baseline, protocol, backlog
    Captures what a future session needs to not undo this work, and what is left.
    CLAUDE.md:
    - The OLED row-shadow INVARIANT: any row written outside draw_row() must be
    invalidated, or the stale shadow silently suppresses the next legitimate
    write to it. Because the fault messages on rows 1-2 are drawn directly, this
    is how a "!STEER LOSS" or "!OVERTEMP!" message could fail to appear — a
    safety defect, not a cosmetic one. Lists every current invalidation point.
    - Measured performance baseline so regressions are detectable, plus the two
    dead ends: a faster I2C clock cannot help further (~45 ms of the original
    184 m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
2026-09-28 Fix latent NameError in vendored pypilot gps_filter.py
    gps_filter.py's world-magnetic-model declination path calls
    datetime.date.today().year, but the module never imported datetime.
    Neither `from values import *` nor `from resolv import *` supplies the
    name (values.py imports only os/time/math/pyjson/resolv, resolv.py
    imports nothing, neither defines __all__), so the call would raise
    NameError.
    Dormant on all current installs: the path needs the wmm2020 package
    installed AND gps.filtered.enabled true. On Dyason wmm2020 is absent and
    gps.filtered.enabled=false is persisted, so the line is unreachable.
    If it ever were reached, filter_process() calls f.update(*args) with no
    try/except, so th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
2026-09-29 Web remote: link-quality monitoring and single alert panel
    - Web remote measures the browser->Pi WiFi link (60 s window, breach >2%)
    and logs LINK_LOSS_BREACH/CLEAR via new /linkevent endpoint.
    - inno_health_notify: Pi->router monitor kept, now a single non-blocking
    loop (1 s standard ping, 1-30 s in Settings, 0.5 s only in Debug),
    60 s window / 60 s clear; state published to /dev/shm for the remote.
    - All warnings/errors/system messages moved out of the OLED into an
    OLED-styled alert panel at bottom right, in plain skipper wording.
    NO BRIDGE overlay keeps its look, now "AUTO PILOT: CONNECTION LOST".
    - Removed viewport-fixed net-warn banner and centre-screen toast.
    No bridge/Nano/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
    [inno_health_notify.py, inno_web_remote.py]
2026-09-30 Web remote: name/version footer, centred mode, alert panel font
    - Move "Inno-Web-Remote" from the top OLED to the bottom edge of the remote
    (black, left) with the software version (right).
    - OLED mode line centred, "MODE:" prefix removed.
    - Alert panel uses the OLED CMD/Head font and colour; shows
    "All Services Nominal" when there is nothing to report.
    - Helm controls moved up by the old title's height; wheel, footer and
    name/version row evenly spaced. STOP, radios and nudge buttons untouched.
    No bridge/Nano/ESP32 change; no version bump.
2026-09-30 Web remote: taller rudder bar, two-line Command/Heading readout
    - Rudder position bar heights doubled (bar, track, tick, marker, arrows).
    - "Command" / "Heading" labels with degrees centred beneath each.
2026-09-30 Version sync to v3.0.1; drop _Bxx beta suffix
    - Nano, bridge and web remote all at v3.0.1 (release versions only).
    - INNOPILOT_BUILD_NUM replaced by INNOPILOT_VERSION_CODE
    (major*10000+minor*100+patch = 30001), same uint16 BRIDGE_VERSION_CODE
    frame, so no protocol change.
    - Nano !VER MISMATCH! row and boot screen show decoded versions.
    - ESP32 remote source/OTA binary deliberately untouched (remotes offline).
    [inno_pilot_bridge.py, inno_web_remote.py, motor_simple.ino]
2026-10-01 Web remote: coalesce SSE updates, smooth rudder glide; v3.0.2
    Diagnosed from a Dyason Debug capture (2026-09-30): the page felt slow and
    jerky because every bridge telemetry line pushed a full-state SSE snapshot
    (~48 events/s, ~85% identical, each a full DOM re-render) and the rudder
    bar's 0.12 s ease transition could not bridge the ~200 ms telemetry steps.
    - inno_web_remote.py: parse each bridge burst, publish one snapshot at the
    end of it, and only if state changed. TEST_LINE/TEST_DONE bypass this.
    51 -> 3.4 events/s idle; every rudder step still delivered; command
    round trip unchanged.
    - Rudder marker/arrows 0.2 s linear glide; wheel glides when following
    telemetry, no glide in R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
2026-10-01 TODO: add parked items from the web remote lag investigation
    - [MEDIUM] Rudder display lag via pypilot (~220 ms) — option 2a with guards;
    2b rejected for now.
    - [MEDIUM] Investigate steering motor disturbing the compass (~4 deg swing).
    - [LOW] Nano oled_draw slower while the motor runs (33-44 ms mean).
    - [LOW] Bridge debug log labels motor direction backwards.
    Docs only — no version bump.
2026-10-01 Hardware tests: grey out 2-9; RAM test -> attended rudder sweep; v3.0.3
    Tests 2-9 send TEST <id>, which no Nano sketch implements; RUN latched the
    bridge's text relay (test_mode never cleared). Greyed out in the web remote
    and refused in the bridge behind NANO_TEST_PROTOCOL_SUPPORTED = False.
    RAM test reworked into "Rudder Sweep (commissioning)":
    - dead-man hold: browser sends RAM HOLD every 200 ms while B3 is held;
    bridge stops after 1 s without one; release ends the test
    - single exit path ram_test_abort(): Nano STOP/any helm button (STOP used to
    be overridden within 200 ms), remote STOP/BTN/MODE/RUD/NUDGE/TGT, stall,
    lost rudder angle, stroke timeout, remote disconnect, cycles comp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
    [inno_pilot_bridge.py, inno_web_remote.py, motor_simple.ino]
2026-10-01 Rudder sweep: fix false "rudder not moving" stop; make it deadband-aware
    First boat run on Dyason stopped with a stall while the rudder moved fine.
    Two causes, both from deadband_pct=10 (Nano deadband = 10% of 60 deg span
    = +/-6 deg; reduced-power slow zone = 4x that = 24 deg):
    - the sweep expected the Nano to land within 2 deg of target; the Nano
    stops anywhere inside its deadband, so the stroke never "arrived"
    - the generic stall detector needs 2 deg/s; in the slow zone a healthy
    rudder moves slower than that
    Fix (bridge only): arrival band = Nano deadband + 1 deg; own jam check
    (< 0.5 deg progress in 2 s while driving); generic stall no longer covers
    the sweep; speed timed over the t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
    [inno_pilot_bridge.py, inno_web_remote.py]
2026-10-02 Nano: motor never started near target (digitalRead killed PWM); full duty
    Dyason's second sweep stopped "stuck" without the rudder moving at all.
    Remote-manual mode drove at analogWrite(D9, 160) within 4x deadband of the
    target (24 deg on Dyason), but the pin-state telemetry called digitalRead(D9)
    every loop, and AVR digitalRead() calls turnOffPWM() — the duty never reached
    the motor. Also affects REMOTE steering for small moves.
    - motor_pwm(): every EN write goes through it and records g_motor_duty;
    telemetry reports EN from that, no digitalRead(D9)
    - RM_SLOW_PWM 160 -> 255: the pump is on/off (AP path is 255-only and the
    firmware notes any PWM needs >= 180); stopping stays with brak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
    [inno_pilot_bridge.py, inno_web_remote.py, motor_simple.ino]
2026-10-02 REMOTE helm play: final position (A), local angle (B), seed (C), gearing (D)
    A (web): RUD was rate-limited to 5 Hz with in-window moves dropped and
    nothing sent on release; now a trailing send + final send on finger lift.
    B (Nano + bridge): the remote-manual position loop steered on pypilot's
    angle, ~0.3 s stale (5 Hz out, ~220 ms conversion, 5 Hz back). The bridge
    now sends pypilot's rudder calibration as a quadratic (frames 0xC0-0xC6,
    status 0xC8) and the Nano evaluates it on its fresh ADC every loop.
    Cross-check vs pypilot's angle (>5 deg for >1 s -> rejected, fallback to
    the old behaviour, latched until calibration changes); end-stop backstop
    on both angles; AP unchanged. Host test: Nan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
2026-10-02 Bridge: send Nano rudder calibration only after values settle (1 s)
    At start-up pypilot publishes rudder.scale/offset, then re-adjusts them once
    rudder.range loads (Dyason: offset 8.14 -> 0.25 within 0.3 s). The bridge
    sent the in-between set, giving the Nano a calibration ~8 deg off for 0.25 s.
    A new set is now sent only after it has been unchanged for RCAL_SETTLE_S.
2026-10-02 Docs: rudder sweep procedure, protocol, invariants; settings review TODOs
    - CALIBRATION.md: new 2b "Rudder sweep" — prerequisites, dead-man use,
    deadband-dependent minimum, how to read each result field
    - PROTOCOL.md: RAM_SETUP / RAM HOLD / RAM RELEASE / TEST (disabled),
    MODE RAM_OFF|RAM_ON, RAM_PROG, RAM_RESULT
    - CLAUDE.md: attended-only invariants for the sweep (browser heartbeat,
    single exit path, no auto-centre, no resume, own jam check + deadband)
    - TODO.md: [HIGH] rudder limits not enforced in AP/REMOTE; [MEDIUM]
    settings & commissioning redesign (dead pgain/off_course, overloaded
    deadband_pct, proposed commissioning order and settings changes)
    Docs only — no version bum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
2026-10-02 Docs: Nano PWM/digitalRead rule; drop reduced-power notes
    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
2026-10-15 v3.3.0: safety (STOP latch, dead-men, pypilot failsafe) + no rudder motion before limits
    Safety:
    - Nano STOP one press, full stop, latched; Nano AP command watchdog (event 7 AP_LOST)
    - REMOTE dead-man (ALIVE heartbeat) and NUDGE dead-man (NUDGE HOLD)
    - Bridge: stop AP when pypilot connection drops or its COMMAND stream stops;
    no surprise re-engage (pp_cmd_block); skipper alerts via WARN <code>
    No rudder motion before rudder limits:
    - Bridge refuses AP engage (remote, Nano B3, and pypilot's own port 8000 via
    the relay), REMOTE, jog and sweep until limits are set; stops motion when the
    calibration they were set against changes
    - Dock-Side Wizard step 1: rudder sensor + limits by hand (L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
2026-10-15 v3.3.0: fixes from the Inno-Pilot-Rosa bench test
    - Web STOP (ESTOP) silences every Nano alarm (WARNING_CODE value 3) and ends a
    jog: units without helm buttons could not stop a STEER LOSS buzzer
    - Bridge derives "pypilot connected" from client.connection: pypilotClient never
    raises on disconnect, so the connection-lost stop never fired on hardware
    - Jog stops on angle + speed * 0.5 s (lag + coast) instead of at the limit;
    logs where the rudder settled
    - No stale rudder angle to the Nano: relay only while pypilot's servo stream is
    alive; Nano cross-check trusts a relayed angle for 0.6 s only
2026-10-15 v3.3.1: pypilot fork strip — no TIOCEXCL on the servo PTY, no serial NMEA probe
    pypilot's servo set TIOCEXCL on /dev/ttyINNOPILOT and cleared it only on a
    tidy close. A killed servo process (service stop, or pypilot's watchdog after
    a hang) left the flag on the socat PTY, so every reopen failed with EBUSY and
    the AP stayed dead until pypilot, bridge and socat were restarted together.
    Confirmed on Inno-Pilot-Rosa (TIOCGEXCL read back 1).
    The flag only guarded against pypilot's serial NMEA probe; Inno-Pilot has no
    serial NMEA devices, so both are stripped. TCP/UDP NMEA inputs unchanged.
    All active components bumped to v3.3.1.
2026-10-16 v3.3.1: pypilot invalid values are "unknown", not 0 deg
    pypilot reports an invalid rudder reading as False; float(False) is 0.0, so
    the bridge reported a confident 0 deg for ~0.5 s on every pypilot restart (web
    rudder bar/helm swung to centre - 29 deg on Inno-Pilot-Rosa with the rudder
    at port; traced pypilot -> bridge -> page). pp_number() maps invalid values to
    None; a jog is refused or stopped while the angle is unknown. Changelog
    wording corrected (pypilot restarts via systemd, not a child watchdog).
    TODO: self-recovering fault alarm/acknowledge design; per-boat jog lead.
2026-10-16 Docs: TODO state banner and status updates after v3.3.0/v3.3.1
    Close STOP-latch and REMOTE dead-man items in place (shipped in v3.3.0, tested on
    Inno-Pilot-Rosa), mark the AP/REMOTE soft-limit item as the next topic, note the
    false RUDDER STALL while pypilot is frozen, and list the next topics in order.
2026-10-21 v3.3.2: REMOTE false STEER LOSS (touch heartbeat), Nano anti-chatter, durable logs
    Diagnosed on Inno-Pilot-Rosa (2026-10-21) from a REMOTE session that stopped
    by itself and an attended dock test with a packet capture (Samsung S20, Chrome).
    - Web page: wheel touches send "ALIVE T" as well as the 0.4 s timer, also while
    Chrome reports the page hidden. Chrome paused the page's timers ~1.5 s while
    the skipper held the wheel, then flagged it hidden although it stayed on
    screen, so the dead-man fired. A hidden page with no touches still trips.
    - Page lifecycle log: visibility, freeze/resume, focus and late timers are sent
    to POST /pageevent and logged as PAGE_EVENT in the journal.
    - Brid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
2026-10-23 v3.3.2: reversal pause on every Nano drive path (H-bridge protection)
    On 2026-10-21 the IBT-2's starboard side failed 0.7 s after a 440 ms
    starboard run was switched straight into port with no stop, followed by three
    more reversals in 0.8 s while the supply sagged to 8.9 V. Driving a pump that
    still spins the other way draws up to about twice its stall current; the old
    "EN off before direction change" lasted microseconds.
    - motor_pwm() records when a run stops and which way it went.
    - rev_blocked(dir): a request for the opposite direction stops a running motor
    and is refused until REVERSAL_PAUSE_MS (300 ms) after the stop. It can only
    keep the motor off.
    - Called by every path that se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
